AdershM-2/UWB_3/docs/uwb_rtls_design.pdf

# Ultra-Wideband Indoor Positioning System

Design Document: Motivation, Objectives, Methodology & Mathematics

Target Platform: Makerfabs ESP32 UWB Pro (DW1000)

Sensing: UWB Ranging + BNO085 IMU

Output: XYZ Position + Roll/Pitch/Yaw Orientation

Version | 2.0
Date | June 2026
Status | Active Development

UWB RTLS — Design Document | CONTENTS

Contents

1 Introduction and Motivation | 2
2 System Overview | 3
3 Objectives | 4
4 Mathematical Foundations | 4
5 Implementation Roadmap | 17
6 Expected Performance | 18

UWB RTLS — Design Document | 1 INTRODUCTION AND MOTIVATION

### 1 Introduction and Motivation

### 1.1 Problem Statement

Accurate indoor positioning is a prerequisite for autonomous robotics, asset tracking, human-motion capture, augmented reality, and industrial safety systems. The Global Navigation Satellite System (GNSS) fails indoors because satellite signals are attenuated by building materials and the reflected multipath environment renders pseudorange measurements unreliable. Optical systems (cameras, LiDAR) achieve high accuracy but require significant infrastructure, computational resources, and are sensitive to lighting conditions and occlusion. Inertial systems drift unboundedly without external correction.

The result is a gap: no low-cost, infrastructure-light technology currently provides real-time 3D position and 3D orientation (six degrees of freedom, 6-DOF) indoors at centimetre-level accuracy with off-the-shelf microcontroller hardware.

### 1.2 Ultra-Wideband as a Candidate Technology

Ultra-wideband (UWB) radio occupies a spectrum of at least 500 MHz bandwidth (typically 3.1–10.6 GHz for IEEE 802.15.4a devices). The key physical properties that make UWB suitable for ranging are:

- Time resolution. The large bandwidth produces a narrow autocorrelation peak. The Decawave DW1000 timestamps signal arrivals at 15.65 ps resolution (64 GHz system clock), corresponding to a theoretical distance resolution of 15.65 × 10⁻¹² × 3 × 10⁸ ≈ 4.7 mm per clock tick.
- Multipath separation. The short pulse duration (∼2 ns) allows the receiver to distinguish the direct-path component from reflections that arrive within a few nanoseconds. Narrowband systems (Bluetooth, Wi-Fi, Zigbee) cannot make this separation.
- Material penetration. UWB signals propagate through common building materials (drywall, wood, glass), enabling ranging through soft obstructions at the cost of a positive distance bias.
- Low power. The FCC Part 15 power limit (−41.3 dBm/MHz) combined with the wide bandwidth results in pulse energy well below noise floor for narrowband receivers, making UWB inherently covert and interference-resistant.

The Decawave DW1000 chip, used in the Makerfabs ESP32 UWB Pro module, implements IEEE 802.15.4-2011 UWB and achieves a specified ranging accuracy of ±10 cm in line-of-sight (LOS) conditions.

### 1.3 Limitations of Existing Open-Source Libraries

Five open-source Arduino libraries implement DW1000 positioning. All share structural limitations that prevent scaling beyond four anchors or a single mobile tag:

The four-anchor ceiling in thotro and its derivatives arises from the RANGE frame encoding: each device occupies 17 bytes (2-byte address + three 5-byte absolute timestamps) within a 90-byte frame buffer. With the 9-byte MAC header, only ⌊(90 − 9 − 2)/17⌋ = 4 devices fit before buffer overflow. The pizzo00 fork reduces this to 12 bytes/device using differential timestamps, reaching 6 anchors, but the broadcast POLL mechanism still causes RF collision between anchor replies.

Critically, no existing library uses the DW1000’s first-path power registers for non-line-of-sight (NLOS) detection, despite the chip making this data available on every received frame.

UWB RTLS — Design Document | 2 SYSTEM OVERVIEW

Table 1: Open-source DW1000 library comparison

Feature | thotro | Makerfabs jremington | pizzo00 | dw1000-ng
Anchor ceiling | 4 | 4 | 7* | 6 | Unlimited
RF collisions | Yes | Yes | Yes | Yes | No
Update rate (Hz) | 0.6 | 0.6 | 0.6 | 1 | 2
Multi-tag | No | No | No | Partial | No
NLOS detection | No | No | No | No | No
3D positioning | No | No | Fragile | No | No
IMU fusion | No | No | No | No | No
Maintained | No | Partial | Yes | Yes | No

### 1.4 Proposed Contribution

This project designs and implements a scalable UWB real-time locating system (RTLS) with the following distinguishing characteristics:

1. Unlimited anchor scaling via individual addressed DS-TWR exchanges (no shared frame buffer, no broadcast collisions).
2. NLOS detection using the DW1000 first-path power registers (FP_AMPL1/2/3) — the first open-source implementation of this capability.
3. Physics-aware state estimation using a Moving Horizon Estimator with Huber loss, physical room-boundary constraints, and speed limits.
4. Full 6-DOF output (XYZ position + RPY orientation) via tight fusion of UWB ranging and BNO085 IMU data.
5. Anchor self-survey via anchor-to-anchor ranging and Multidimensional Scaling, eliminating the need for manual coordinate measurement.

### 2 System Overview

### 2.1 Hardware

Hardware Specification

UWB module | Makerfabs ESP32 UWB Pro with Display
UWB chip | Decawave DW1000 (IEEE 802.15.4-2011 UWB)
MCU | ESP32 (dual-core Xtensa LX6, 240 MHz, Wi-Fi/BT)
RF front-end | PA/LNA amplifier (∼200 m outdoor range)
Display | 1.3 inch SSD1306 OLED (I²C, pins SDA=4, SCL=5)
IMU (planned) Bosch BNO085 via SPI
Configuration | 3–4 anchors (fixed) + 1 tag (mobile)
Transport | Wi-Fi UDP to MATLAB host (192.168.x.x:5005)

### 2.2 Software Architecture

The system is split into two layers:

Firmware (Arduino/ESP32): The tag performs round-robin DS-TWR ranging to each anchor, collects raw distances with quality metrics, and streams measurement packets over UDP. Anchors are purely passive responders. The tag never solves its own position.

UWB RTLS — Design Document | 4 MATHEMATICAL FOUNDATIONS

Host (MATLAB): All position computation, filtering, visualisation, and logging runs on the host PC. This separation means adding anchors requires only editing a JSON configuration file — no firmware change. The firmware packet format is versioned and IMU-ready.

The processing pipeline on the host is:

Raw ranges median filter

−−−−−−−−→ Filtered ranges NLOS weighting −−−−−−−−−−→ Weighted ranges LM multilat.

−−−−−−−−→ Position EKF/MHE −−−−−−−→ xˆ

EMA
−−−→ Output

### 3 Objectives

O1. Achieve XY positioning accuracy of ≤ 3 cm (1-σ) in LOS and ≤ 8 cm in soft NLOS conditions using 3–4 anchors.

O2. Achieve Z-axis positioning accuracy of ≤ 5 cm with 4 anchors deployed at different heights.

O3. Deliver continuous RPY orientation output at ≥ 50 Hz from BNO085 IMU fusion.

O4. Maintain position tracking continuity during brief anchor occlusions (≤ 3 s) using IMU dead-reckoning.

O5. Support anchor self-survey: determine anchor positions to ≤ 2 cm without external measurement.

O6. Demonstrate update rate ≥ 3 Hz for 3 anchors and ≥ 8 Hz in fast-mode operation.

O7. Provide real-time NLOS detection per anchor using DW1000 channel impulse response diagnostics.

O8. Remain compatible with low-cost hardware: total cost < $200 for a 4-anchor + 1-tag system.

### 4 Mathematical Foundations

This section develops the mathematics behind each processing stage in the pipeline. No prior knowledge of signal processing or estimation theory is assumed. Notation: Scalars are written in italic (t, d, τ ); column vectors in bold italic (x, p); matrices in bold upright (F, Q). The superscript ⊤ means transpose (turning a column into a row). ∥v∥ is the length of vector v (square root of sum of squares of its components). Subscripts k index discrete time steps.

### 4.1 Double-Sided Two-Way Ranging (DS-TWR)

Big picture — what problem does DS-TWR solve?

We want to measure the distance between two radio modules by timing how long a signal takes to travel between them. The speed of light is known (c = 3×10⁸ m/s), so distance = c×time. The problem is that the clock inside each module runs at a slightly different speed. Even a tiny difference — say 20 parts per million (ppm), which is 20 microseconds per second — causes a large range error. If the tag waits 1 ms before replying to an anchor, a 20 ppm clock error makes it think 1 ms has passed when in reality 1 ms × (1 + 20 × 10⁻⁶
) = 1.00002 ms has
passed. That extra 0.00002 ms corresponds to 0.00002 × 10⁻³ × 3 × 10⁸ = 6 m of phantom range. Catastrophic.
DS-TWR fixes this by performing a two-sided exchange so that the clock offsets cancel algebraically — without either device needing to know its clock error.

### 4.1.1 Message Exchange

The DS-TWR protocol uses four messages between a tag (T) and anchor (A), each recorded with a hardware timestamp:

Step | Direction | Frame | Timestamps captured
1 | T → A | poll | t1 (T transmits), t2 (A receives)
2 | A → T | poll-ack | t3 (A transmits), t4 (T receives)
3 | T → A | range | t5 (T transmits); carries t1, t4, t5
4 | A → T | range-report | t6 (A receives); anchor computes & replies d

Think of it as a conversation: the tag says “hello” (t1), the anchor hears it (t2) and replies (t3), the tag hears the reply (t4) and sends a follow-up (t5), and the anchor hears that (t6). Both sides now have enough timing information to eliminate the clock offset.

### 4.1.2 Defining the Timing Intervals

From these six timestamps we form four intervals (all measured in DW1000 hardware ticks; one tick = 15.65 ps):

Ra = t4 − t1 | tag’s round-trip time (poll sent → ack received) | (1)
Da = t3 − t2 | anchor’s reply delay (poll received → ack sent) | (2)
Rb = t6 − t3 | anchor’s round-trip time (ack sent → range received) | (3)
Db = t5 − t4 | tag’s reply delay (ack received → range sent) | (4)

If there were no clock error and the signal takes time τ to travel one way, then ideally Ra = 2τ +Da and Rb = 2τ + Db. Each round-trip is twice the travel time plus the processing delay.

### 4.1.3 The DS-TWR Formula

Combining both round-trips cancels the processing delays and, crucially, the clock offsets:

τToF =

RaRb − DaDb
Ra + Rb + Da + Db

(5)

Why does this formula work?

Consider the ideal case (no clock error). Substitute Ra = 2τ + Da and Rb = 2τ + Db:

τToF =

(2τ + Da)(2τ + Db) − DaDb
(2τ + Da) + (2τ + Db) + Da + Db

=

4τ

2 + 2τ (Da + Db)
4τ + 2(Da + Db)

=

2τ

2τ + Da + Db

2

2τ + Da + Db

= τ

The processing delays Da and Db cancel completely, leaving the true one-way travel time. With clock errors, the algebra is more involved but the errors cancel to second order.

Clock-offset cancellation (detailed). Let εT and εA denote the fractional frequency offsets of the tag and anchor clocks (e.g. ε = 20 × 10⁻⁶
for a 20 ppm crystal). Because the tag’s clock runs fast or slow, all intervals measured by the tag are scaled: Ra (measured by the tag) is really (2τ + Da)(1 + εT ), and Rb (measured by the anchor) is (2τ + Db)(1 + εA). Substituting into eq. (5) and keeping only first-order terms in ε (since ε

2 ≈ 4 × 10⁻¹⁰ is negligible):

τToF ≈ τ | + | O(ε

2
)
| | | {z } ≈ 0.1 mm

The clock-offset terms vanish. The remaining error is at most 0.1 mm — far below the chip’s 4.7 mm resolution.

Worked numerical example

Suppose a tag ranges to an anchor 3 m away. Light travel time: τ = 3 / (3 × 10⁸ ) = 10 ns =
10 × 10⁻⁹
s. In DW1000 ticks (1 tick = 15.65 ps), this is 10 × 10⁻⁹ / 15.65 × 10⁻¹² ≈ 639 ticks. Say the anchor takes 1 ms to process and reply (Da = 1 ms), and the tag takes 1.2 ms (Db = 1.2 ms). In ticks:
Da ≈ 63 900 000, | | Db ≈ 76 700 000

Ra = 2τ + Da ≈ 1278 + 63 900 000 = 63 901 278 ticks

Rb = 2τ + Db ≈ 1278 + 76 700 000 = 76 701 278 ticks

τToF =

RaRb − DaDb
Ra + Rb + Da + Db

≈

63901278 × 76701278 − 63900000 × 76700000 63901278 + 76701278 + 63900000 + 76700000 Numerically the cross-terms from DaDb and the products cancel to leave ≈ 639 ticks, giving: ˆd = 639 × 15.65 × 10⁻¹² × 3 × 10⁸ ≈ 3.0 m. ✓

The measured distance is then:
ˆd = c · τToF + bant | (6)

where c = 2.998 × 10⁸ m/s and bant is a per-board calibration offset (see below).

### 4.1.4 Antenna Delay Calibration

Why calibration is needed

Every DW1000 chip has a slightly different internal wiring delay between the digital timestamp and the physical antenna. This delay is fixed for a given board but unknown. Without correcting it, every range measurement will be off by the same constant — even with perfect DS-TWR maths. Calibration identifies this constant by comparing the measured distance against a known true distance and adjusting a register (∆) until they match.

The DW1000 applies a programmable antenna delay ∆ (a 16-bit register value) that shifts the RX timestamp. Increasing ∆ makes the chip think the signal arrived later, which reduces the computed ToF and thus the reported distance. Calibration finds:

∆∗ = arg min
∆
E

h

ˆd(∆)i
− d

⋆

2

where d

⋆
is the measured true distance (e.g. boards placed 7 m apart with a tape measure). The relationship is monotone, so a binary search over ∆ ∈ [15800, 16900] with 200 averaged measurements per candidate converges to the optimum in 14 iterations (2

14 = 16384 covers the
range). The residual uncertainty is ±3 ticks ≈ ±1.4 mm.

### 4.2 NLOS Detection via Channel Impulse Response

Big picture — detecting blocked paths

When the direct radio path between tag and anchor is blocked by a wall or large object, the signal still arrives — but via a longer reflected route. Since we assume straight-line travel, the extra path length registers as a spurious positive distance error (the measured range is longer than the true range). This is called Non-Line-of-Sight (NLOS) error and is always positive.
The DW1000 gives us a way to detect NLOS without any extra hardware: it separately reports how much energy arrived in the first path (the direct or near-direct arrival) versus the total received energy. If a lot of energy came in late (via reflections), the ratio between total and first-path power is large — a reliable NLOS indicator.

### 4.2.1 Physical Basis

When a radio pulse is transmitted, it spreads out in space. At the receiver, the DW1000 correlates the incoming signal against the known preamble sequence to build a Channel Impulse Response (CIR) — essentially a time-series showing when energy arrives and how much. In LOS conditions, one sharp peak appears at the direct-path delay. In NLOS, additional energy arrives later via reflected paths. The chip hardware captures the amplitude of the three samples straddling the first (earliest) peak, giving us a window into how strong the direct path is relative to all the scattered energy.

### 4.2.2 DW1000 Diagnostic Registers

After every received frame, the DW1000 populates these registers automatically:

- FP_AMPL1, FP_AMPL2, FP_AMPL3 (register 0x12): three amplitude samples around the first-path leading edge. Together they represent the energy in the direct (first-arriving) signal.
- RXPACC (register 0x10): the preamble accumulator count — how many samples were averaged to build the CIR. Used as a normalisation factor.
- CIR_PWR (register 0x12): the total integrated channel power, including all reflections.

### 4.2.3 Computing the NLOS Score

Step 1 — First-path power. Combine the three amplitude samples and normalise by the accumulator count. The result is then converted to decibels (dBm), a logarithmic power scale where each 10 dB corresponds to a factor of 10 in power:

PFP = 10 log10

A²

1 + A²

2 + A²
3
N²
acc | !
− Aconst | (7)

Here A1, A2, A3 are the FP_AMPL values, Nacc is RXPACC, and Aconst is a chip-specific constant (121.74 dBm at 16 MHz PRF; 113.77 dBm at 64 MHz PRF) that accounts for the chip’s internal gain.

Step 2 — Total received power. The total power PRX is read from CIR_PWR via the driver function DW1000.getReceivePower(), using a similar log formula.
Step 3 — NLOS score. The NLOS score is simply the power gap between total and first-path:
∆PNLOS = PRX − PFP | (8)

In LOS, most of the energy arrives in the first path, so PRX ≈ PFP and ∆PNLOS is small. In NLOS, extra reflected energy raises PRX while PFP stays low, widening the gap.

Score | Condition | Action
< 3 dB | LOS. Direct path dominates. | Full weight in multilateration.
3–6 dB | Soft NLOS. Partial obstruction. | Reduce weight proportionally.
≥ 6 dB | Hard NLOS. Reflected path dominant. | Strong downweight or reject.

### 4.2.4 Range Bias Correction under NLOS

NLOS ranging error is always positive: reflected and through-wall paths are geometrically longer than the direct path, so the measured distance always exceeds the true distance. Through-wall propagation also slows the signal by a factor of √
εr, where εr is the material’s relative permittivity (concrete: εr ≈ 6–9; drywall: εr ≈ 2–4). A higher ∆PNLOS score correlates with a larger positive bias, allowing an empirical correction:
bNLOS ≈ kNLOS · max(0, ∆PNLOS − 3 dB) | (9)

with kNLOS ≈ 0.02–0.05 m/dB (environment-dependent, tuned experimentally). This correction is subtracted from the measured range before multilateration.

### 4.3 Weighted Multilateration

Big picture — locating a point from distances

Multilateration is the process of finding a position given distances to several reference points (anchors). The key idea: if you know you are exactly 3 m from anchor 1, you could be anywhere on a circle (or sphere in 3D) of radius 3 m centred on anchor 1. A second anchor gives a second circle. In 2D, two circles intersect at two points. A third anchor breaks the ambiguity and gives a unique intersection — your position.
In practice, the measured distances have noise, so the circles do not intersect perfectly at one point. Instead of looking for an exact intersection, we find the position that is as close as possible to being at the stated distance from each anchor — a least-squares problem.

### 4.3.1 Measurement Model

Let there be N anchors at known positions ai ∈ R

d
(where d = 2 for 2D or d = 3 for 3D), and let ˆdi be the measured range to anchor i after median filtering and bias correction. The true tag position x ∈ R

d
satisfies:

ˆdi = ∥x − ai∥
| | {z | }
true distance

+ ei
|{z}
noise

, ei ∼ N (0, σ²
i
) | (10)

The term ∥x − ai∥ is the Euclidean distance from tag to anchor i (the length of the straight line connecting them). The noise ei
is modelled as Gaussian with standard deviation σi

. Anchors
flagged as NLOS have a larger σi
:
σi = σbase · 10∆PNLOS,i/20 | (11)

A 10 dB NLOS score multiplies the assumed noise standard deviation by 10⁰.5 ≈ 3.16, reducing the weight (see below) by a factor of 10. This is how the NLOS score flows from the radio measurement into the position solver.

### 4.3.2 Weighted Least-Squares Objective

Define the residual for anchor i as ri(x) = ∥x − ai∥ − ˆdi — the difference between the distance implied by guess x and the measured range. If our guess is correct, ri = 0. The position estimate minimises the weighted sum of squared residuals:

xˆ = arg min
x∈Rd

X

N

i=1

wi ri(x)

2
, wi =

1
σ

2
i

(12)

Anchors with higher uncertainty σi get a smaller weight wi
| , so their contribution to the cost is
reduced. This is the core of weighted least squares: trust reliable measurements more.

### 4.3.3 Levenberg-Marquardt Solver

The objective eq. (12) is nonlinear (the distances ∥x − ai∥ are nonlinear in x), so there is no closed-form solution. We use the Levenberg-Marquardt (LM) algorithm, which iteratively improves a guess xk by solving a linearised sub-problem at each step.

The Jacobian J. At the current guess xk, we compute the Jacobian matrix J ∈ R

N×d
. Each
row is the gradient of one residual with respect to the position:

Ji =

∂ri
∂x

=

(x − ai)

| ⊤
∥x − ai∥

(13)

This is just the unit vector pointing from anchor i toward the current guess x. Intuitively, it says: “if you move in direction Ji
, the distance to anchor i increases by one unit.”

LM update step. Let W = diag(w1, . . . , wN ) be the diagonal weight matrix. The LM correction to the current guess is:

xk+1 = xk −

J

⊤WJ + λ diag(J

⊤WJ)

−1
J
⊤Wr(xk) | (14)

The damping parameter λ controls how cautious each step is. When λ is large the step shrinks toward the direction of steepest descent (safe but slow). When λ is small the step is a full Newton step (fast near the solution). LM automatically adjusts λ: increase it if the step made things worse, decrease it if it made things better. This gives it the robustness of gradient descent and the speed of Newton’s method near the solution.

### 4.3.4 Robust Outlier Gating (MAD)

A single badly-NLOS anchor can dominate the cost and pull the estimate far from the truth. After a first LM solve, outlier anchors are detected using the Median Absolute Deviation (MAD):

σˆrobust = 1.4826 · median(|ri − median(r)|) | (15)

Why median instead of mean?

The regular standard deviation is sensitive to outliers: one anchor with a 2 m NLOS error pulls the mean residual and inflates the standard deviation, masking the fact that other anchors are perfectly consistent. The median ignores the extreme values and reports the typical residual. The constant 1.4826 converts the MAD to an equivalent standard deviation under Gaussian noise. Anchors whose residual deviates from the median by more than K = 2.5 times this robust sigma are excluded and the solve repeats with the remaining anchors.

### 4.3.5 Position Covariance

The uncertainty in the position estimate (needed by the Kalman filter) is approximated from the curvature of the cost function at the solution:

Ppos ≈ σ

2

base
J

⊤WJ−1
(16)

Intuitively: if all the Jacobian rows point in similar directions (anchors roughly collinear), the matrix J

⊤WJ is nearly singular and its inverse is large — meaning the position is poorly determined in some directions. If the anchors surround the tag from all sides, the matrix is well-conditioned and the position uncertainty is small. This is the mathematical expression of the “Dilution of Precision” concept familiar from GPS.

### 4.3.6 GPS-Style Simultaneous Bias Estimation

What GPS does that basic ranging does not

In GPS, the receiver’s clock is imprecise, so every pseudorange measurement has the same unknown clock offset added to it. GPS solves for position and this offset simultaneously by using one extra satellite beyond the minimum. The offset term cancels in pairwise differences between satellites, leaving only geometry.
We face the same problem: an uncalibrated or temperature-drifted tag clock adds the same offset δ to all measured ranges. With N ≥ d + 2 anchors (one extra beyond the minimum needed for position), we can estimate δ alongside position.

The augmented measurement model is:

ˆdi = ∥x − ai∥ + δ + ei | (17)

The augmented Jacobian gains an extra column of ones (because moving δ by 1 shifts all residuals by 1):
J˜
i = [Ji
, 1] | (18)

The LM solver treats x˜ = [x

⊤, δ]

⊤ as the unknown and proceeds identically.

Geometric limitation with minimum anchors. If we try this with exactly d + 1 anchors (e.g. 3 anchors in 2D), the δ estimate is not reliable. Subtracting any two range equations cancels δ exactly, so all the information about position comes from differences, not absolute ranges. The solver becomes ill-conditioned near the anchor centroid. For this reason, δ-solve is only enabled when N ≥ d + 2.

### 4.4 State Estimation

### 4.4.1 Extended Kalman Filter (EKF)

Big picture — the Kalman filter idea

The multilateration solver gives a new position estimate every time a ranging sweep completes (roughly 3 Hz). The Kalman filter is a principled way to smooth these noisy position estimates using knowledge of how things physically move.
The filter alternates between two steps every time interval ∆t:
1. Predict. “Given where the tag was and how fast it was moving, where should it be now?” The filter projects the state forward in time using Newton’s equations.
2. Update. “A new measurement arrived. How much should I correct my prediction?”

The correction is proportional to how much we trust the measurement versus the physics model.
The filter tracks not just the state estimate but also its uncertainty (the covariance matrix P). Uncertainty grows during prediction (we are less sure of where the tag is without measurements) and shrinks during update (new data reduces uncertainty).

State vector. The EKF state packs all unknowns into a single column vector:

x =

p
v
a
δ

∈ R

3d+1 | (19)

where p ∈ R

d
is position (e.g. [x, y] in 2D), v ∈ R

d
is velocity (how fast position is changing), a ∈ R

d
is acceleration (how fast velocity is changing), and δ ∈ R is the slowly-varying range bias from §4.3.5.

Transition matrix F (predict step). The state evolves according to Newton’s kinematic equations. If the acceleration stays roughly constant over one time step ∆t, then:

pnew = p + v ∆t +

1/2 a ∆t

2
, | vnew = v + a ∆t, | anew ≈ a, | δnew ≈ δ

Written in matrix form for the full state vector:

F =

Id | ∆t Id | ∆t
| | 2
| | 2
| | Id | 0
0 | Id | ∆t Id | 0
0 | 0 | Id | 0
0 | 0 | 0 | 1

(20)

Each block row corresponds to one sub-state (position, velocity, acceleration, bias). The top-left 3 × 3 block in d = 1 reads: new position = old position ×1 + old velocity ×∆t + old acceleration ×∆t

2/2. This is just kinematics.

Process noise Q (model uncertainty). We know the tag does not follow perfect constant-acceleration motion. Random forces (sudden stops, direction changes) introduce unpredictable acceleration changes. The matrix Q models this uncertainty. Larger Q means we trust the physics model less and will weight new measurements more heavily:

Q = qj

∆t

5
20 I

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
| | I ∆t I | 0
0 | 0 | 0 | qδ ∆t

(21)

The scalar qj (jerk power spectral density, tuned via the EKF_Q_ACCEL slider) controls the trade-off: low qj makes the filter trust its kinematic model and produce smooth but potentially lagging output; high qj makes it follow measurements closely but with more noise.

Measurement model for tight coupling. Rather than feeding the multilaterated position directly into the filter, we can feed the raw ranges and let the filter compute the expected ranges from its own state estimate. For anchor i at position ai
, the predicted range is:
hi(x) = ∥p − ai∥ + δ | (22)

The linearised measurement Jacobian (gradient of hi with respect to the state) is:

Hi =

(p − ai)

⊤
∥p − ai∥
| | {z | }
unit vector toward anchor

, 01×2d
| {z }
vel/acc terms

, 1
|{z}
bias term

(23)

The first part is the unit vector pointing from the tag toward anchor i; moving the tag by 1 m in that direction changes the range to anchor i by exactly 1 m.

Kalman equations. At each time step the filter runs the following sequence:

Predict: xˆk|k−1 = Fxˆk−1|k−1

| (project state forward) | (24)

Pk|k−1 = FPk−1|k−1F

⊤ + Q | (uncertainty grows with time) | (25)

Update: Sk = HkPk|k−1H⊤
k + Rk | (innovation covariance) | (26)
Kk = Pk|k−1H⊤
k S
−1 k | (Kalman gain) | (27)

xˆk|k = xˆk|k−1 + Kk

zk − h(xˆk|k−1

)

| (correct estimate) | (28)
Pk|k = (I − KkHk)Pk|k−1 | (uncertainty shrinks after update) | (29)

Understanding the Kalman gain K

The Kalman gain K decides how much to correct the prediction when a measurement arrives. It is automatically computed from two competing uncertainties:

- Pk|k−1

: how uncertain we are in our prediction. Large P means “I am not confident where the tag is.”
- Rk: how uncertain we are in the measurement (the covariance from the multilaterator, eq. (16)). Large R means “I do not trust this measurement.”
If the prediction is uncertain (large P) and the measurement is reliable (small R), then K is large: the filter corrects strongly toward the measurement. If the prediction is confident (small P) and the measurement is noisy (large R), K is small: the filter barely moves. This is the optimal weighted combination.

The subscript notation xˆk|k−1 means “estimate of state at time k, using data up to time k − 1” (prediction). xˆk|k means “estimate at time k, after incorporating measurement at time k” (updated).

### 4.4.2 Moving Horizon Estimator (MHE)

Big picture — looking at a window of past data

The Kalman filter processes one measurement at a time and maintains a compact summary (mean and covariance). The Moving Horizon Estimator takes a different approach: at every time step, it looks at the last N measurements simultaneously and solves one large optimisation problem to find the trajectory that best fits all of them together.
This is more computationally expensive but offers two key advantages:
1. Hard constraints. The solution is forced to lie inside the room and respect a speed limit. The Kalman filter cannot enforce these.
2. Robustness to outliers. Using the Huber loss (described below), the MHE naturally reduces the influence of NLOS-corrupted measurements without explicitly rejecting them.

At time step k, the MHE considers the window of past states {xk−N+1, . . . , xk} and minimises:

min
{xt}

∥xk−N+1 − x¯k−N+1∥

2
P

−1
arr
| | {z | }
| arrival cost
| (memory of the past)

+

X

k

t=k−N+2

∥xt − Fxt−1∥

2
Q⁻¹
| | {z | }
dynamics residuals
(penalises unphysical jumps)

+

X

t

X

i

ρδ

∥pt − ai∥ − ˆdt,i

| | {z | }
range residuals
(fit the measurements)

(30)

where ∥v∥

2
M = v

⊤Mv is a weighted norm. The three terms penalise:

1. Arrival cost: deviation of the oldest state in the window from the summary x¯k−N+1 carried forward from the previous window. This compactly encodes all information from before the window.
2. Dynamics residuals: how much each consecutive pair of states violates the physics model xt ≈ Fxt−1. Large jumps are penalised.
3. Range residuals: how well the estimated positions fit the UWB range measurements, using the Huber loss ρδ.

The Huber loss ρδ. Standard least squares penalises errors quadratically: doubling the error quadruples the penalty. This means a single large NLOS error can dominate the whole objective. The Huber loss switches to a linear penalty for large errors, limiting the influence of any single outlier:

ρδ(e) =

1
2

e

2
if |e| ≤ δ

δ

|e| − δ
2
if |e| > δ

(31)

Residual |e| Squared loss | Huber loss (δ = 0.15 m)
0.05 m | 0.0025 | 0.00125 (quadratic)
0.15 m | 0.0225 | 0.01125 (quadratic, at threshold)
0.30 m | 0.0900 | 0.01688 (linear; only 12× larger than 0.05 m)
1.00 m | 1.0000 | 0.13500 (linear; only 108× larger than 0.05 m)

An NLOS anchor with a 1 m error contributes 108× less than a perfect anchor under Huber loss, versus 400× more under squared loss.

Constraints:

pmin ≤ pt ≤ pmax | (room boundary, hard constraint) | (32)
∥vt∥2 ≤ vmax | (speed limit, hard constraint) | (33)

These hard constraints prevent the estimator from placing the tag outside the room or moving it at superhuman speed, which can happen during anchor occlusions if the estimator is unconstrained.

Computational cost. With window N = 6, space d = 3, and Na = 4 anchors, the problem has N × (3d + 1) = 60 unknowns and is solved by fmincon (MATLAB interior-point method) in 2–5 ms per step — well inside the 333 ms between UWB sweeps.

Table 2: EKF vs. MHE comparison

Property | EKF | MHE
NLOS handling | Pre-gating required | Huber loss absorbs outliers
Physical constraints | None | Room boundary + speed (hard)
Nonlinearity | Jacobian linearisation | Solved exactly
Lag | Zero | N/2 steps (≈ 1 s at N = 6)
Compute per step | Trivial (µs) | 2–5 ms (fmincon)
Sensitivity to initialisation | Moderate | Low (window smooths errors)

### 4.5 IMU Fusion and Orientation Estimation

Big picture — bridging the gap between UWB updates

UWB provides a position fix roughly every 300 ms. An IMU (inertial measurement unit) measures angular rates (gyroscope) and linear acceleration at 100 Hz. Between UWB updates, the IMU provides 30 intermediate position estimates using dead-reckoning (integrating acceleration twice). At each UWB update, the integrated position is corrected. Together, UWB provides the absolute reference while the IMU provides smooth high-rate motion between fixes.
The BNO085 also outputs orientation (roll/pitch/yaw) at 100 Hz directly, which UWB alone cannot provide.

### 4.5.1 Why Quaternions?

Orientation in 3D can be parameterised in several ways. The most intuitive is three Euler angles (roll ϕ, pitch θ, yaw ψ) — tilt left/right, tilt forward/back, and turn left/right. However, Euler angles have a singularity called gimbal lock: when the pitch angle reaches ±90◦
, roll and yaw
become indistinguishable and one degree of freedom is lost. This causes numerical instability in tracking algorithms.

Quaternions avoid this by representing orientation as four numbers [qw, qx, qy, qz] with the constraint q

2
w + q

2
x + q

2
y + q

2
z = 1. The geometric interpretation: every rotation can be described as a rotation by angle θ about a unit axis [ˆnx, nŷ, nẑ], encoded as:
qw = cos(θ/2), | qx = ˆnx sin(θ/2), | qy = ˆny sin(θ/2), | qz = ˆnz sin(θ/2)

For example, a 90◦ yaw (rotation about the Z axis) gives q = [cos 45◦

| | | , 0, 0,sin 45◦ ] = [0.707, 0, 0, 0.707].

The BNO085 handles all quaternion arithmetic internally and outputs a pre-filtered quaternion, so the user never needs to implement quaternion integration from scratch.

### 4.5.2 Rotation Matrix from Quaternion

To transform a vector from the body frame (relative to the sensor) into the world frame (fixed to the room), use the rotation matrix:

R(q) =

1 − 2(q

2
y + q

2
z

) 2(qxqy − qwqz) 2(qxqz + qwqy) 2(qxqy + qwqz) 1 − 2(q

2
x + q

2
z

) 2(qyqz − qwqx)
2(qxqz − qwqy) 2(qyqz + qwqx) 1 − 2(q

2
x + q

2
y

)

- (34)

Each element is a quadratic combination of the quaternion components. This 3×3 matrix rotates any body-frame vector into world coordinates.

### 4.5.3 Quaternion Kinematics (How Orientation Updates)

If the gyroscope reports a body angular rate ω

b = [ωx, ωy, ωz]

⊤ (in rad/s), the quaternion evolves according to:

q˙ =

1
2

q ⊗

"
0
ω

b

(35)

where ⊗ is the Hamilton product (a specific rule for multiplying two quaternions, analogous to cross-product for vectors). The 0 in the first slot makes the combined object a pure quaternion compatible with the product rule.

For a finite time step ∆t, the exact discrete integration is:

qk+1 = qk ⊗

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
(36)

This rotates the current orientation by the incremental rotation corresponding to spinning at rate ω

b
for time ∆t. The magnitude of the rotation angle is
ω

b
k

∆t radians.

### 4.5.4 IMU-Driven Position Propagation

The BNO085 also outputs linear acceleration a

b
(acceleration with gravity removed) measured in the body frame. To integrate it into world-frame position, first rotate it:

a

w = R(q) a

b

Then apply Newton’s equations over one IMU time step ∆t = 10 ms (at 100 Hz):

pk+1 = pk + vk ∆t +
1/2 a

w
k ∆t

2
(37)

vk+1 = vk + a

w
k ∆t | (38)

Between two UWB sweeps (300 ms apart) the IMU runs 30 propagation steps, providing smooth position estimates throughout. When the next UWB measurement arrives, the Kalman update corrects the accumulated drift.

### 4.5.5 Loose vs. Tight Coupling

Loose coupling first runs multilateration to get a position, then feeds that position into the EKF as the measurement zk = pˆmultilat. It is easier to implement but throws away information: the multilateration step collapses the individual range errors into a single covariance, losing the directional information about which anchors were reliable.

Tight coupling feeds raw UWB ranges ˆdi directly into the EKF/MHE as separate measurements via the model of eq. (22). This is the recommended approach because:

- It can use partial anchor sets (e.g. 2 of 4 anchors visible) without changing any equations.
- Each anchor’s quality metric flows directly into the measurement weight Rk.
- The Jacobian Hi automatically captures the geometry of each anchor.

### 4.5.6 Roll, Pitch, and Yaw from Quaternion

Physical meaning of roll, pitch, yaw

Roll (ϕ): rotation about the forward axis (tilting left/right like an aircraft banking). Pitch (θ): rotation about the side axis (nose up/down). Yaw (ψ): rotation about the vertical axis (turning left/right on a compass heading). Together these three angles fully describe orientation in 3D.

The Euler angles in ZYX convention are extracted from the quaternion by:
ϕ = atan2
2(qwqx + qyqz), 1 − 2(q

2
x + q

2
y

)

(39)
θ = arcsin(2(qwqy − qzqx)) | (40)
ψ = atan2
2(qwqz + qxqy), 1 − 2(q

2
y + q

2
z

)

(41)

The function atan2(y, x) returns the angle whose sine is proportional to y and whose cosine is proportional to x, in the correct quadrant. The arcsin for pitch is why pitch is limited to ±90◦ in this convention.

The BNO085 runs its ARVR Stabilised Rotation Vector mode, which fuses accelerometer, gyroscope, and magnetometer internally at 400 Hz. The magnetometer provides an absolute heading reference (like a compass), preventing the yaw drift that gyroscope integration alone would accumulate over time.

### 4.6 Anchor Self-Survey via Multidimensional Scaling

Big picture — building a map from pairwise distances

Normally we assume the anchor positions are known (measured with a tape measure or laser rangefinder and entered into the config file). Any measurement error directly biases all subsequent position estimates.
Anchor self-survey replaces manual measurement: the anchors range to each other and a mathematical procedure called Multidimensional Scaling (MDS) recovers their 2D or 3D layout automatically. The analogy: given a table of driving distances between cities, MDS reconstructs a map of those cities without any compass or coordinate system.

### 4.6.1 Data Collection

With N anchors, there are N
2
=

N(N−1)
2

unique pairs. For 4 anchors this is 6 pairs. Each anchor temporarily becomes a ranging initiator and ranges to every other anchor. Each pairwise distance is averaged over M = 100 measurements to reduce noise: the averaged uncertainty is σd/

√
M ≈ 5 cm/

√
100 = 0.5 cm.

### 4.6.2 Classical Multidimensional Scaling

Step 1 — Build the squared-distance matrix. Arrange all pairwise distances ˆdij into a symmetric N × N matrix and square each entry:

D

(2)
ij = ˆd
2
ij
The diagonal entries are zero (distance from any anchor to itself is zero).
Step 2 — Double-centering. The matrix D⁽²⁾ encodes distances relative to the centroid of the anchor cloud, but it is not centred. Apply the centering matrix J = IN −

1
N

11⊤ (which
subtracts row and column means): B = −
1/2 J D⁽²⁾ J | (42)

UWB RTLS — Design Document | 5 IMPLEMENTATION ROADMAP

Why double-centering?

If the anchor positions are stored in a matrix X (rows = anchors, columns = coordinates), then the squared distances satisfy D

(2)
ij = ∥xi − xj∥ 2 = ∥xi∥

2 − 2xi
- xj + ∥xj∥

2
. The
double-centering operation eq. (42) algebraically cancels the ∥xi∥

2
and ∥xj∥

2
terms, leaving
Bij = xi
- xj — the dot products between anchor positions. In matrix form: B = XX⊤. We have converted distances into dot products, from which positions can be extracted by factorisation.
Step 3 — Eigendecomposition. Factor B into eigenvectors and eigenvalues: B = VΛV⊤. If the distances were exact, exactly d eigenvalues would be non-zero (one per spatial dimension). Take the d largest:
Xˆ = Vd Λ
| 1/2 d
(43)

where Vd contains the d leading eigenvectors as columns and Λd = diag(λ1, . . . , λd). Each row of Xˆ is the recovered position of one anchor.

Numerical example: 3 anchors in 2D

Suppose the true anchor positions are a1 = (0, 0), a2 = (3, 0), a3 = (1.5, 2.6) metres. The true pairwise distances are: d12 = 3 m, d13 = 3 m, d23 = 3 m (equilateral triangle, side 3 m).

D⁽²⁾ =

0 9 9
9 0 9
9 9 0

After double-centering: B =

6 | −3 −3
−3 | 6 | −3
−3 −3 | 6

- (scaled by 1/3 internally). Eigendecomposition

yields 2 non-zero eigenvalues. Taking the top 2 and applying eq. (43) recovers the anchor layout up to rotation/reflection. After frame fixation, the output matches the true positions.

### 4.6.3 Coordinate Frame Fixation

MDS recovers the shape but not the orientation or position (the solution is ambiguous up to rigid-body motion). Three conventions fix a unique coordinate frame:

1. Translation: Subtract the position of anchor 1 from all positions, so anchor 1 becomes the origin (0, 0) or (0, 0, 0).
2. Rotation: Rotate the layout so that anchor 2 lies on the positive X axis.
3. Reflection: If anchor 3 ends up below the X axis (negative Y), flip the Y axis.

The result is written to config/anchors.json for immediate use by the localisation pipeline.

### 4.6.4 Noise Propagation

Each pairwise distance is the mean of M = 100 measurements. If individual measurement noise is σd ≈ 5 cm, the mean has standard deviation σd/

√
M = 0.5 cm. Classical MDS propagates this to a position uncertainty of roughly 0.5 cm per anchor coordinate — within our ≤ 2 cm self-survey target.

### 5 Implementation Roadmap

The system is developed in six phases, each independently testable:

UWB RTLS — Design Document | 6 EXPECTED PERFORMANCE

Table 3: Implementation phases and key items

Phase | Item | Description | Difficulty

1 — Foundation

1.0 | Switch to 64 MHz PRF (accuracy mode) | Easy
1.1 | Better calibration (200 samples, multi-distance) | Easy
1.2 | Adaptive polling: skip dead anchors | Easy
1.3 | Faster sweep rate (reduce reply delay) | Medium
1.5 | Anchor self-survey + auto anchors.json | Medium

2 — Ranging

2.1 | FP_POWER NLOS detection (firmware + wire format) | Medium
2.2 | Weighted multilateration (NLOS score) | Medium
2.3 | NLOS range bias correction slider | Easy
2.4 | Per-anchor diagnostics panel | Easy
2.5 | GPS-style δ-solve (4+ anchors) | Medium

3 — Estimation

3.1 | Constant-acceleration EKF | Medium
3.2 | δ as EKF state (bias estimation) | Med-Hard
3.3 | Moving Horizon Estimator | Hard
3.4 | Hybrid EKF + MHE | Medium

4 — 3D + RPY

4.1 | 4th anchor + 3D configuration | Easy
4.2 | BNO085 SensorImu (SPI) | Medium
4.3 | RPY output from quaternion | Easy
4.4 | Loose coupling: IMU-aided EKF | Hard
4.5 | Tight coupling: raw ranges + IMU in MHE | Very Hard

5 — Hardening

5.1 | Deep sleep on anchors | Medium
5.2 | DW1000 driver error handling | Medium
5.3 | Temperature compensation | Medium
5.4 | Online self-calibration | Hard

6 — Scale

6.1 | Multi-tag TDMA superframe | Hard
6.2 | Differential timestamp encoding | Hard
6.3 | On-device 2D solve (OLED) | Medium

### 6 Expected Performance

The theoretical floor for the DW1000 chip is approximately 1–2 cm in perfect LOS conditions (limited by the 15.65 ps timestamp resolution and residual crystal asymmetry). Practical indoor environments with multipath and occasional NLOS will see 2–5 cm as the sustainable floor. IMU integration does not improve UWB ranging accuracy but eliminates position lag between sweeps and provides orientation at sensor rate.

UWB RTLS — Design Document | 6 EXPECTED PERFORMANCE

Table 4: Expected accuracy progression through implementation phases

After Phase | XY accuracy | Z accuracy | RPY | Rate | Key enabler
Current | 3–10 cm | — | — | 3 Hz | Baseline
Phase 1 | 2–6 cm | — | — | 4–8 Hz | Calibration + PRF
Phase 2 | 1–4 cm | — | — | 4–8 Hz | NLOS detection
Phase 3 | 1–3 cm | — | — | 4–8 Hz | MHE + CA-EKF
Phase 4 | 1–3 cm | 2–5 cm | 3–5◦ | 100 Hz RPY | IMU fusion
Phase 5 | 1–3 cm | 2–5 cm | 3–5◦ | 100 Hz RPY | Reliability
