AdershM-2/UWB_3/docs/uwb_rtls_for_dummies.pdf

# UWB Indoor Positioning

### A Plain-English Guide to Every Equation

Companion to the technical design document.

No prior engineering or maths background assumed.

Hardware | Makerfabs ESP32 UWB Pro (Decawave DW1000)
Goal | Find the XYZ position and orientation of a moving tag
Version | 1.0 — June 2026

UWB RTLS — Plain English Guide | CONTENTS

Contents

1 The Big Picture in One Page | 2
2 Step 1 — Measuring Distance with Radio Pulses (DS-TWR) | 2
3 Step 2 — Detecting Blocked Paths (NLOS) | 5
4 Step 3 — Finding Position from Distances (Multilateration) | 7
5 Step 4 — Smoothing Position Over Time (EKF / MHE) | 11
6 Step 5 — Adding Orientation (IMU Fusion) | 14
7 Step 6 — Finding Anchor Positions Automatically (MDS) | 16
8 How All the Pieces Fit Together | 19

UWB RTLS — Plain English Guide 2 STEP 1 — MEASURING DISTANCE WITH RADIO PULSES (DS-TWR)

### 1 The Big Picture in One Page

What are we building?

We are building an indoor GPS. Four small radio modules (called anchors) are fixed at known positions around a room. One more module (called the tag) is carried by a person or robot. The tag measures how far it is from each anchor by timing how long a radio pulse takes to travel between them. A laptop then uses those four distances to calculate where the tag must be.
That is the whole idea. Everything else in this document is about doing it more accurately.

Why not just use GPS? Ordinary GPS works by receiving signals from satellites 20 000 km above Earth. Indoors, those signals are too weak and reflect off walls, making them unreliable. Our system places the equivalent of “mini-satellites” in the same room, which solves both problems.

The processing chain — each step in the pipeline is covered by one section of this document:

Step | What happens
1 | Tag sends a radio pulse to each anchor and times the round-trip (§2)
2 | We check whether any anchor’s signal was blocked or reflected (§3)
3 | We use the four distances to triangulate position (§4)
4 | We smooth the position over time using a physics model (§5)
5 | We add orientation (tilt, heading) from an IMU sensor (§6)
6 | Anchors measure each other to find their own positions automatically (§7)

### 2 Step 1 — Measuring Distance with Radio Pulses (DS-TWR)

What is DS-TWR?

DS-TWR stands for Double-Sided Two-Way Ranging. It is the method used to measure how far the tag is from one anchor. The core idea: send a radio pulse from the tag to the anchor, measure how long it takes, and multiply by the speed of light to get a distance. Then correct for the fact that neither device has a perfect clock.

### 2.1 Why Timing is Hard — The Clock Problem

Radio pulses travel at the speed of light: c = 3 × 10⁸ metres per second. At 3 metres distance, the travel time is:

time =

distance
speed =

3
3 × 10⁸

= 10 nanoseconds (a nanosecond is 10⁻⁹ seconds)

So we need to measure 10 nanoseconds accurately. That is extremely short. The clock inside a cheap crystal oscillator runs at a slightly wrong speed — typically off by about 20 parts per million (ppm). What does that mean?

How bad is a 20 ppm clock error?

“20 parts per million” means the clock gains or loses 20 microseconds for every second it runs. If the tag waits 1 millisecond (1/1000 of a second) before sending its reply, the

UWB RTLS — Plain English Guide 2 STEP 1 — MEASURING DISTANCE WITH RADIO PULSES (DS-TWR)

error in that delay is:

20 × 10⁻⁶ × 1 × 10⁻³
seconds = 20 nanoseconds of error

Since light travels 3 × 10⁸ m/s, 20 ns of timing error corresponds to:

20 × 10⁻⁹ × 3 × 10⁸ = 6 metres of fake distance

A 6 metre error from a 1 ms processing delay! This is why we cannot simply time a single pulse.

### 2.2 The Four-Message Fix

DS-TWR uses four messages between the tag (T) and anchor (A) so that the clock errors cancel out mathematically:

Msg | Who sends | Name | What time is recorded
1 | Tag → Anchor POLL | Tag records send time t1; Anchor records receive time t2
2 | Anchor → Tag POLL-ACK Anchor records send time t3; Tag records receive time t4
3 | Tag → Anchor RANGE | Tag records send time t5; also sends t1, t4, t5 inside the message
4 | Anchor → Tag REPORT | Anchor records receive time t6; computes and sends back distance

Think of it like a carefully timed conversation where both sides know exactly when they
spoke and when they heard a reply.

### 2.3 Building the Four Timing Intervals

From those six timestamps, we build four intervals. Each is measured in clock ticks (one tick on the DW1000 chip = 15.65 picoseconds, i.e. 15.65 × 10⁻¹² seconds):

Ra = t4 − t1 | Tag’s round-trip time | (tag sent POLL at t1, received ACK at t4)
Da = t3 − t2 | Anchor’s reply delay | (anchor received POLL at t2, sent ACK at t3)
Rb = t6 − t3 | Anchor’s round-trip time (anchor sent ACK at t3, received RANGE at t6)
Db = t5 − t4 | Tag’s reply delay | (tag received ACK at t4, sent RANGE at t5)

R stands for “Round-trip.” D stands for “Delay” (the waiting time before replying). The subscripts a and b indicate which side (tag or anchor) did the measuring.

If the clocks were perfect and the one-way travel time is τ :

Ra = | 2τ
|{z}
signal went there and back

+ Da
|{z}
anchor’s delay

and Rb = 2τ + Db

### 2.4 The DS-TWR Formula

τToF =

Ra · Rb − Da · Db
Ra + Rb + Da + Db

(1)

UWB RTLS — Plain English Guide 2 STEP 1 — MEASURING DISTANCE WITH RADIO PULSES (DS-TWR)

τToF | The one-way travel time we want (ToF = Time of Flight)
Ra, Rb | The two round-trip measurements
Da, Db | The two processing delays

### 2.4.1 Why does this formula work? (Step-by-step)

Step 1. In the ideal case, substitute Ra = 2τ + Da and Rb = 2τ + Db into the formula:

τToF =

(2τ + Da)(2τ + Db) − DaDb
(2τ + Da) + (2τ + Db) + Da + Db
Step 2. Expand the numerator:

(2τ + Da)(2τ + Db) − DaDb = 4τ

2 + 2τDb + 2τDa + DaDb − DaDb = 4τ

2 + 2τ (Da + Db)

Step 3. Simplify the denominator:

(2τ + Da) + (2τ + Db) + Da + Db = 4τ + 2Da + 2Db = 2(2τ + Da + Db)

Step 4. Divide:

τToF =

4τ

2 + 2τ (Da + Db)
2(2τ + Da + Db)

=

2τ (2τ + Da + Db)
2(2τ + Da + Db)

= τ ✓

The delays Da and Db cancel out completely. The formula returns the exact travel time regardless of how long the devices waited before replying.

### 2.4.2 How the Clock Error Cancels

With real clocks, the tag’s clock runs at a slightly wrong speed. Let εT be how wrong (e.g. εT = 20 × 10⁻⁶
for a 20 ppm error). Every interval measured by the tag is stretched by (1 + εT ). Similarly the anchor’s clock error is εA.

So the actual measured values are:

Ra = (2τ + Da)(1 + εT ) Rb = (2τ + Db)(1 + εA)

When you substitute these into the DS-TWR formula and do the algebra, the εT and εA terms cancel to first order, leaving:

τToF ≈ τ + (error proportional to ε

2
)
| | {z | }
≈ (20 ppm)

2=4×10⁻¹⁰, i.e. less than 0.1 mm

The remaining error is tiny (less than 0.1 mm), no matter how long the devices waited.

### 2.4.3 Converting Travel Time to Distance

ˆd = c · τToF + bant | (2)

UWB RTLS — Plain English Guide | 3 STEP 2 — DETECTING BLOCKED PATHS (NLOS)
ˆd | Measured distance (the hat ˆ means “estimated”, not exact)
c | Speed of light: 2.998 × 10⁸ m/s
τToF | Travel time from equation 1
bant | A small correction for each board’s internal wiring delay (see below)

Complete numerical example

A tag is 3 metres from an anchor. The DW1000 clock ticks at 64 GHz (i.e. 1/64 × 10⁹ seconds per tick = 15.65 ps per tick). The one-way travel time is 10 ns = 639 ticks. Say the anchor delays 1 ms (Da ≈ 63,900,000 ticks) and the tag delays 1.2 ms (Db ≈ 76,700,000 ticks). Then:
Ra = 2 × 639 + 63,900,000 = 63,901,278 ticks
Rb = 2 × 639 + 76,700,000 = 76,701,278 ticks
Plugging into equation 1: the huge delay numbers cancel in numerator and denominator, and we get back ≈ 639 ticks. Multiplying: 639 × 15.65 ps × 3 × 10⁸ m/s = 3.0 m. ✓

### 2.5 Antenna Delay Calibration

Why calibrate?

Every DW1000 chip has a slightly different internal wiring delay between its digital clock and its physical antenna. This shifts every distance reading by the same constant amount. Calibration finds and removes that constant.
Think of it like zeroing a scale before weighing something — the scale might read 2 grams when empty, so you subtract 2 grams from every reading.

The DW1000 has a register (∆, a 16-bit number) that shifts the receive timestamp. We find the best value by trying different ∆ values and comparing the measured distance against a known true distance d

⋆
:
∆∗ = arg min
∆
E[

ˆd(∆)] − d
⋆

2

Plain English: “Find the ∆ that makes the average measured distance E[

ˆd(∆)] as close as
possible to the true distance d

⋆
.” The symbol arg min means “the value of ∆ that minimises the expression in the brackets.” We use a binary search (the same idea as guessing a number between 1 and 100 by always trying the middle of the remaining range), which finds the answer in 14 steps.

Key takeaway

After calibration, the distance error caused by internal chip delays is reduced to under 1.4 mm.

### 3 Step 2 — Detecting Blocked Paths (NLOS)

What is NLOS?

NLOS stands for Non-Line-of-Sight. It means the direct path between tag and anchor is blocked by a wall, person, or furniture. When this happens, the radio pulse still arrives at the anchor — but only after bouncing off other surfaces. Because the bounced path is longer than the direct path, the measured distance is always too large. We never get a negative NLOS error, only positive ones.

UWB RTLS — Plain English Guide 3 STEP 2 — DETECTING BLOCKED PATHS (NLOS)

The DW1000 chip can tell us whether this happened by reporting how much of the received energy came in early (the direct path) versus late (via reflections).

The shouting analogy

Shout “hello” across a room. In a normal room you hear one clear echo. Now put a wall in the way — some sound diffracts around it, and some bounces off side walls, arriving a little later and sounding “muddy.” More spread-out echoes = more reflected paths = NLOS.

### 3.1 What the Chip Reports

After every received message, the DW1000 automatically fills three registers:

Register | What it stores | In plain words
FP_AMPL1, 2, 3 Three amplitude samples | Strength of the first-arriving signal
RXPACC | Preamble accumulator count How many samples were averaged (normalisation factor)
CIR_PWR | Total channel power | Strength of everything received, including reflections

### 3.2 Computing First-Path Power

We combine the three first-path amplitudes A1, A2, A3 into a single power value. Power is proportional to amplitude squared, so we square each and add them. Then we normalise by N²
acc (where Nacc = RXPACC) and convert to decibels (dB):

PFP = 10 log10

A²

1 + A²

2 + A²
3
N²
acc | !
− Aconst | (3)
PFP | First-path power in dBm (power of the direct-arrival signal)
A1, A2, A3 | The three FP_AMPL register values
Nacc | RXPACC — normalises for how many preamble samples were collected
Aconst | Chip constant: 121.74 dBm at 16 MHz PRF; 113.77 dBm at 64 MHz PRF
log10 | Logarithm base 10 (tells us the power of 10 needed to reach a number)

What is a decibel (dB)?

A decibel is a way of expressing a ratio on a squished scale, because power can vary by enormous factors. 10 log10(x) converts a power ratio x into dB. Key facts:
- +3 dB means the power doubled (10⁰.3 ≈ 2).
- +10 dB means the power became 10 times larger (10¹ = 10).
- −10 dB means the power became 10 times smaller.
We use dB because “6 dB difference” is easier to write than “the power ratio is 3.98”.

### 3.3 The NLOS Score

The total received power PRX is read from CIR_PWR by the chip’s driver. The NLOS score is simply the gap between total and first-path power:

∆PNLOS = PRX − PFP | (4)

UWB RTLS — Plain English Guide 4 STEP 3 — FINDING POSITION FROM DISTANCES (MULTILATERATION)

∆PNLOS | NLOS score in dB. ∆ (delta) means “difference.”
PRX | Total received power (first path + all reflections)
PFP | First-path power (direct arrival only)

How to read the score:

NLOS score | Meaning | What we do
Less than 3 dB | Most energy came in early (LOS) | Trust this anchor fully
3 to 6 dB | Some late energy (soft NLOS) | Reduce this anchor’s weight
More than 6 dB Most energy came in late (hard NLOS) Strongly distrust or ignore

### 3.4 Correcting the NLOS Range Error

Because the blocked path is longer than the direct path, the measured distance is always too large. We estimate how much to subtract:

bNLOS ≈ kNLOS · max(0, ∆PNLOS − 3 dB) | (5)
bNLOS | The distance correction to subtract from ˆd (in metres)
kNLOS | A tunable constant, typically 0.02–0.05 m per dB
max(0, . . .) “Take the larger of 0 and the expression.” If the score is below 3 dB, the correction is zero (no correction needed in LOS).

Example

NLOS score = 8 dB. Correction: b = 0.03 × (8 − 3) = 0.15 m. We subtract 15 cm from the measured range before using it in the position solver.

Key takeaway

NLOS detection is free — the chip computes it from data it already collects. No extra hardware required. This is the first open-source UWB system to use it.

### 4 Step 3 — Finding Position from Distances (Multilateration)

What is multilateration?

“Trilateration” or “multilateration” means finding a position given distances to several known points. You have distances from the tag to each anchor. Each distance says “I could be anywhere on a circle (or sphere) of that radius around this anchor.” Multiple circles narrow it down to one intersection point — your position.

The radio-station analogy

Imagine you can hear three radio stations and you know how strong each signal is (weaker = farther away). You draw a circle of the right radius around each station on a map. The point where all three circles cross is where you are. With four anchors in 3D (one per spatial dimension plus one spare), you can find position in XYZ.

UWB RTLS — Plain English Guide 4 STEP 3 — FINDING POSITION FROM DISTANCES (MULTILATERATION)

### 4.1 The Measurement Equation

For each anchor i (where i goes from 1 to N, the number of anchors):

ˆdi = ∥x − ai∥
| | {z | }
true distance

+ ei
|{z}
noise

(6)

ˆdi | Measured (noisy) distance to anchor i
x | The tag’s position we are trying to find — a vector like [x, y] or [x, y, z]
ai | The known position of anchor i — also a vector like [ax, ay]
∥x − ai∥ The straight-line distance from tag to anchor i
| This equals q (x − ax) 2 + (y − ay) 2 in 2D (Pythagoras’ theorem)
ei | Measurement noise — a random error, assumed to follow a bell curve
N (0, σ²
i
| ) Bell curve (Gaussian) with average 0 and spread σi
σi | Standard deviation: roughly the expected size of the error

The noise σi for each anchor depends on its NLOS score:

σi = σbase · 10 ∆PNLOS,i / 20 | (7)
σbase | Baseline noise (e.g. 0.10 m) when the anchor is in perfect LOS
10∆P/20 | A multiplier > 1 that grows with the NLOS score
| At 10 dB NLOS: 10¹⁰/20 = 10⁰.5 ≈ 3.16, so σi ≈ 3.16 × σbase

An NLOS anchor gets a larger σi

| , which means we trust it less (see weights below).

### 4.2 Minimising the Total Error

We want to find the position x that makes all the distance equations as consistent as possible. The cost function is:

xˆ = arg min
x

X

N

i=1

wi

∥x − ai∥ − ˆdi

2
, wi =

1
σ

2
i

(8)

arg minx | “Find the x that makes the following expression as small as possible”
PN
i=1 | Add up the following term for each anchor from i = 1 to i = N
wi | Weight for anchor i: larger weight = we trust this anchor more
wi = 1/σ²
i | Noisier anchors (large σi) get smaller weight (large σ
| 2
| i in denominator)
(∥x − ai∥ − ˆdi)
2 | Squared difference between the distance our guess implies
| and what we actually measured to anchor i

Plain English

We are guessing a position x. For each anchor, we check: “if I were at position x, what distance would I expect to anchor i? How far is that from what I actually measured?” We square that gap so positive and negative errors don’t cancel, multiply by how much we trust the anchor, and add it all up. We adjust our guess to make this total as small as possible.

UWB RTLS — Plain English Guide 4 STEP 3 — FINDING POSITION FROM DISTANCES (MULTILATERATION)

### 4.3 Solving It Iteratively — Levenberg-Marquardt (LM)

This minimisation has no closed-form solution (we cannot just rearrange the equation). So we use an iterative algorithm called Levenberg-Marquardt that makes small improvements to the guess until it stops improving.

The residual vector. For a current guess xk, define the residual for anchor i as:

ri(xk) = ∥xk − ai∥ − ˆdi

This is simply: (distance my guess implies) − (what I measured). If ri = 0, the guess is perfect for anchor i. If ri > 0, the guess is too far from anchor i.

The Jacobian. To improve the guess, we need to know: “which direction should I move x to reduce each ri most quickly?” The answer is the Jacobian matrix J. Each row i of J is:

Ji =

∂ri
∂x

=

(x − ai)

⊤
∥x − ai∥

(9)

∂ri/∂x | “How much does ri change when I nudge x a tiny bit?” (partial derivative)
(x − ai) | The vector pointing from anchor i to the current guess
∥x − ai∥ | The length of that vector
(x − ai)/∥x − ai∥ This divides by the length to get a unit vector (length = 1)
In plain words: Ji | is a unit vector pointing from anchor i toward the current position guess.
Moving the guess in that direction increases the distance to anchor i by exactly 1 metre per metre of movement. This is just geometry.

The update step. Given the Jacobian J, the weight matrix W = diag(w1, . . . , wN ) (a matrix with weights on the diagonal, zeros elsewhere), and the damping parameter λ, the new guess is:

xk+1 = xk −

J

⊤WJ + λ diag(J

⊤WJ)

−1
J
⊤Wr(xk) | (10)

This looks intimidating but the logic is:

1. J

⊤Wr — the weighted gradient (which direction is downhill?).

2. (J

⊤WJ)

−1 — scales the step to the right size.

3. λ — a safety dial. Large λ: take a tiny, safe step (slow but won’t overshoot). Small λ: take a big, efficient step (fast near the solution). The algorithm sets λ automatically: increase it if the step made things worse; decrease it if the step helped.

The algorithm typically converges in 5–15 iterations.

### 4.4 Throwing Out Bad Anchors (MAD Gating)

After the first solve, we check whether any anchor is wildly inconsistent (e.g. NLOS blocked and the correction wasn’t enough). We use the Median Absolute Deviation:

σˆrobust = 1.4826 · median(|ri − median(r)|) | (11)

UWB RTLS — Plain English Guide 4 STEP 3 — FINDING POSITION FROM DISTANCES (MULTILATERATION)

median(r) | The middle value of all residuals when sorted smallest to largest
|ri − median(r)| How far each residual is from the median
median(. . .) | The median of those absolute distances
1.4826 | A constant that makes the result equivalent to a standard deviation when the noise is bell-shaped (Gaussian). This is a well-known statistics result.

Why median instead of mean?

The ordinary average is pulled by outliers. If five anchors have 2 cm residuals and one has 200 cm (NLOS), the average is about 35 cm — way above the typical 2 cm. The median ignores the outlier and returns 2 cm. We use the median to judge which anchors are normal and which are suspicious.
Any anchor with a residual more than K = 2.5 times this robust σˆ is excluded and the solve repeats with the remaining anchors.

### 4.5 How Certain Are We? (Position Covariance)

After the solve, we want to know how uncertain the position estimate is. The answer comes from the curvature of the cost function:

Ppos ≈ σ

2

base
J

⊤WJ−1
(12)
Ppos | The position covariance matrix. Its diagonal entries are the
variance (spread²
) of the error in x and y (and z). σ

2
base | Baseline ranging variance
(J

⊤WJ)

−1 The inverse of the curvature matrix. When all anchors surround
the tag evenly, this is small (good geometry). When anchors are
all in a line, this is large in the perpendicular direction (bad geometry).

This matrix is passed to the Kalman filter in the next step.

### 4.6 Solving for a Timing Bias Too (GPS-Style)

If we have N ≥ d + 2 anchors (at least 4 in 2D, 5 in 3D), we can simultaneously solve for an unknown timing offset δ that shifts all measurements by the same amount — exactly how GPS receivers solve for their clock error:

ˆdi = ∥x − ai∥ + δ + ei | (13)

The only change to the solver is that the Jacobian gains an extra column of ones (because changing δ by 1 shifts every residual by 1 equally):

J˜
i = [Ji
, 1] | (14)

Everything else stays the same.

Key takeaway

With 3 anchors in 2D, multilateration finds (x, y) in 2 unknowns from 3 equations — one spare for checking consistency. With 4 anchors, we get a third spare which lets us also solve for the timing bias δ.

UWB RTLS — Plain English Guide 5 STEP 4 — SMOOTHING POSITION OVER TIME (EKF / MHE)

### 5 Step 4 — Smoothing Position Over Time (EKF / MHE)

What problem are we solving now?

The multilateration step gives a position every time a ranging sweep completes (about 3 times per second). That position is noisy — it jumps around even when the tag is stationary. We want to smooth it using knowledge that people and robots do not teleport. They move continuously, with some speed and acceleration. A filter uses this physics knowledge to reject noise and fill in the gaps.

### 5.1 The Extended Kalman Filter (EKF)

The ship navigator analogy

Imagine a navigator on a ship. Every few minutes they get a GPS position (noisy). Between GPS fixes, they use the ship’s speed and heading (from a compass and speedometer) to estimate where the ship is now. When the next GPS fix arrives, they combine the physics-based estimate with the new measurement, trusting each one according to how reliable it has been. The Kalman filter does exactly this, but with maths.

### 5.1.1 The State Vector

The Kalman filter tracks everything it needs to know in a single column vector called the state:

x =

p
v
a
δ

(15)

p | Position — e.g. [x, y] in metres in 2D
v | Velocity — e.g. [vx, vy] in m/s (how fast position is changing)
a | Acceleration — e.g. [ax, ay] in m/s² (how fast velocity is changing)
δ | Range bias — the common clock offset shared by all anchor measurements

The filter also keeps track of how uncertain it is about each of these quantities, stored in a matrix P (the covariance matrix).

### 5.1.2 Step A: Predict (Physics)

Between measurements, the filter predicts where the tag should be now, based on where it was and how fast it was moving. This is just Newton’s kinematics:

| new position = old position + velocity × ∆t +
| 1 2 × acceleration × ∆t
| 2
| new velocity = old velocity + acceleration × ∆t

Written for all state variables at once using a transition matrix F:

xˆk|k−1 = F xˆk−1|k−1

(16)

UWB RTLS — Plain English Guide 5 STEP 4 — SMOOTHING POSITION OVER TIME (EKF / MHE)

xˆk|k−1 | State estimate at time k, predicted using data up to time k − 1
xˆk−1|k−1 | State estimate at time k − 1, after incorporating the measurement at k − 1
F Transition matrix — encodes the kinematic equations above
∆t | Time between measurements

The matrix F (shown in the technical document) is just the kinematics equations packed into matrix form. Its top-left block reads: new x = old x × 1 + old vx × ∆t + old ax × ∆t

| 2/2.

The prediction uncertainty grows:

Pk|k−1 = F Pk−1|k−1 F

⊤ + Q | (17)

Q is the process noise matrix. It represents the fact that the tag might change direction or speed in ways the filter cannot predict (e.g. the person suddenly stops). Larger Q = the filter knows it cannot predict well = it gives new measurements more weight.

### 5.1.3 Step B: Update (Measurement)

A new UWB measurement zk arrives. The filter combines prediction and measurement:

Sk = Hk Pk|k−1 H⊤
k + Rk | (total uncertainty in the predicted measurement)
(18)

Kk = Pk|k−1 H⊤
k S

−1
k
(Kalman gain) | (19)

xˆk|k = xˆk|k−1 + Kk

zk − h(xˆk|k−1

)

(corrected estimate) | (20)

Pk|k = (I − Kk Hk) Pk|k−1

(uncertainty reduced after update) | (21)
Hk | Measurement Jacobian — how does the measurement depend on the state?
Rk | Measurement noise covariance (= Ppos from equation 12)
Sk | Innovation covariance — total uncertainty about what measurement to expect
Kk | Kalman gain — the weight given to the measurement correction

zk − h(xˆk|k−1

) “Innovation”: difference between what we measured and what we predicted
h(·) | The function that converts a state into a predicted measurement
For anchor i: hi(x) = ∥p − ai∥ + δ

Understanding the Kalman gain K

K is automatically computed from two uncertainties:

- Pk|k−1

(prediction uncertainty): if this is large, the filter is not confident in its prediction, so it will strongly correct toward the measurement.
- Rk (measurement uncertainty): if this is large, the measurement is noisy, so the filter barely corrects.
If the prediction is perfect and the measurement is noisy, K ≈ 0 (ignore the measurement). If the prediction is useless and the measurement is perfect, K ≈ H⁻¹
(jump to the
measurement). In practice it is always somewhere between.

The measurement model for anchor i in tight coupling is:

hi(x) = ∥p − ai∥ + δ | (22)

UWB RTLS — Plain English Guide 5 STEP 4 — SMOOTHING POSITION OVER TIME (EKF / MHE)

and its Jacobian (how does this measurement change if the state changes?):

Hi =

(p − ai)

⊤
∥p − ai∥

, 0 |{z} vel/acc terms

, 1

- (23)

The first part is the unit vector from anchor i to the tag. It says: “moving 1 metre toward anchor i reduces the range to anchor i by 1 metre.” The final 1 is for the bias δ: increasing the bias by 1 increases all ranges by 1.

### 5.2 Moving Horizon Estimator (MHE)

An alternative to the Kalman filter

Instead of updating one step at a time, the MHE keeps the last N measurements and solves one big optimisation problem over all of them simultaneously. Think of it like a detective who reviews all the evidence from the last 6 crime scenes together, rather than updating their theory one crime at a time. This is slower to compute but allows hard constraints (“the suspect cannot be outside the building”).

The MHE minimises this objective over the window {xk−N+1, . . . , xk}:

min ∥xk−N+1 − x¯k−N+1∥

2
P

−1
arr
| | {z | }
Term 1: Arrival cost
(memory of history)

+

X

t

∥xt − Fxt−1∥

2
Q⁻¹
| | {z | }
Term 2: Physics penalty
(penalise unphysical jumps)

+

X

t,i

ρδ

∥pt − ai∥ − ˆdt,i

| | {z | }
Term 3: Range fit
(fit the UWB measurements)

(24)

∥v∥

2
M A weighted squared length: v

⊤Mv (penalises directions M says matter)
x¯k−N+1 | Prior estimate at the start of the window (from previous window’s solution)
Parr | Uncertainty of that prior estimate (arrival covariance)
Fxt−1 | Where physics says xt should be, given xt−1
ρδ(·) | Huber loss (explained below)
ˆdt,i | UWB range measurement to anchor i at time t

The Huber loss ρδ — tolerating bad measurements:

ρδ(e) =

1/2 e

2
if |e| ≤ δ (normal error: quadratic penalty)

δ

|e| − δ
2
if |e| > δ (large error: linear penalty)

(25)

Why the Huber loss?

Ordinary squared error (e

2

) treats a 1 m NLOS error as 1/0.05² = 400 times worse than a normal 5 cm error. One bad anchor dominates everything. The Huber loss switches to linear growth for large errors, so the 1 m outlier only contributes about 13 times a normal 5 cm error — a much fairer penalty that does not let one bad anchor ruin the solution.

UWB RTLS — Plain English Guide 6 STEP 5 — ADDING ORIENTATION (IMU FUSION)

Error |e| Squared: e

2 | Huber (δ = 0.15 m) | Ratio
0.05 m | 0.0025 | 0.00125 | 1× (baseline)
0.15 m | 0.0225 | 0.01125 | 9×
0.30 m | 0.0900 | 0.01688 | 13× (Huber caps growth)
1.00 m | 1.0000 | 0.13500 | 108× vs 400× for squared

Hard constraints prevent the MHE from placing the tag outside the room or moving it faster than a person can walk:

pmin ≤ pt ≤ pmax | (room boundary) | (26)
∥vt∥ ≤ vmax | (speed limit, e.g. 2 m/s for walking) | (27)

Key takeaway

EKF = fast, simple, real-time. MHE = slower, handles hard constraints and outliers better. Use EKF first; upgrade to MHE for hostile environments.

### 6 Step 5 — Adding Orientation (IMU Fusion)

What does the IMU add?

UWB tells us where the tag is (position), but not which way it is pointing (orientation). A BNO085 IMU (Inertial Measurement Unit) measures rotation and acceleration 100 times per second. Adding it gives us:
1. Roll, Pitch, Yaw — the three angles that describe orientation.
2. 30 position estimates per UWB sweep — by integrating acceleration between UWB fixes.

### 6.1 Describing Orientation — Why Quaternions?

Three ways to describe “which way you are facing”

Euler angles (roll, pitch, yaw): easy to understand, but have a bug called gimbal lock. When you pitch up 90 degrees, roll and yaw point in the same direction and you lose a degree of freedom — the maths breaks down.
Quaternions: four numbers instead of three, with one constraint. No gimbal lock, no singularities. The BNO085 outputs quaternions directly, so we never experience gimbal lock.

A quaternion is written q = [qw, qx, qy, qz] with the constraint q

2
w + q

2
x + q

2
y + q

2
z = 1 (unit
length). The geometric meaning: any rotation can be described as “rotate by angle θ about a unit axis nˆ”, encoded as:

qw = cos(θ/2) The “how much” part
qx = ˆnx sin(θ/2) The x-component of the axis, scaled qy = ˆny sin(θ/2) The y-component of the axis, scaled qz = ˆnz sin(θ/2) The z-component of the axis, scaled

Example: 90◦ yaw (turning left)

Axis = [0, 0, 1] (straight up, the Z axis). Angle θ = 90◦ .

qw = cos(45◦

) = 0.707, | qx = 0, | qy = 0, | qz = sin(45◦
) = 0.707

UWB RTLS — Plain English Guide 6 STEP 5 — ADDING ORIENTATION (IMU FUSION)

So q = [0.707, 0, 0, 0.707].

### 6.2 The Rotation Matrix

To rotate a vector from the body frame (tag’s perspective) into the world frame (room’s perspective), we use:

R(q) =

1 − 2(q

2
y + q

2
z

) 2(qxqy − qwqz) 2(qxqz + qwqy) 2(qxqy + qwqz) 1 − 2(q

2
x + q

2
z

) 2(qyqz − qwqx)
2(qxqz − qwqy) 2(qyqz + qwqx) 1 − 2(q

2
x + q

2
y

)

- (28)

Each entry is a quadratic combination of qw, qx, qy, qz. If the tag accelerates forward (body frame), multiply R by that acceleration vector to get the world-frame direction of the acceleration. This is needed to integrate IMU acceleration into world-frame position.

### 6.3 How Orientation Updates (Quaternion Kinematics)

The gyroscope measures angular rate ω

b = [ωx, ωy, ωz] in rad/s. The continuous-time update rule is:

q˙ =

1
2

q ⊗

"
0
ω

b

(29)
q˙ | Time derivative of the quaternion (how fast it is changing)
⊗ | Hamilton product (the rule for multiplying two quaternions, similar to cross product)
[0, ω

b
| ] The angular rate packed as a pure quaternion (zero scalar part)
1
2 | A factor that comes from the chain rule applied to the angle-halving in quaternions

For a finite time step ∆t (e.g. 10 ms at 100 Hz), the discrete update is:

qk+1 = qk ⊗

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
(30)

What this equation does

The big bracket on the right is a quaternion that represents “rotate by ∥ω

b∥ · ∆t radians
about the axis ω

b/∥ω

b∥.” Multiplying (Hamilton product ⊗) the current orientation quaternion by this rotation quaternion rotates it to the new orientation. This is exactly analogous to multiplying rotation matrices, but numerically more stable.
The BNO085 chip handles all of this internally and outputs the result directly.

### 6.4 Position Propagation from IMU

The BNO085 also reports linear acceleration a

b
(gravity already removed) in the body frame. Steps:

### 1. Rotate to world frame: a

w = R(q) a

b

UWB RTLS — Plain English Guide 7 STEP 6 — FINDING ANCHOR POSITIONS AUTOMATICALLY (MDS)

### 2. Integrate (Newton’s equations):

pk+1 = pk + vk ∆t +
1/2 a

w
k ∆t

2
(31)

vk+1 = vk + a

w
k ∆t | (32)

This runs at 100 Hz. Every UWB sweep (at 3 Hz) provides 33 intermediate positions, making the output much smoother. The UWB measurement then corrects any drift accumulated during those 33 IMU steps.

### 6.5 Extracting Roll, Pitch, Yaw from a Quaternion

Physical meaning

Roll ϕ: tilting left/right (like an airplane banking). Pitch θ: nose up or down. Yaw ψ: turning left or right (like a compass bearing). These three angles together fully describe orientation.

From a unit quaternion [qw, qx, qy, qz]:

ϕ = atan2
2(qwqx + qyqz), 1 − 2(q

2
x + q

2
y

)

(33)
θ = arcsin(2(qwqy − qzqx)) | (34)
ψ = atan2
2(qwqz + qxqy), 1 − 2(q

2
y + q

2
z

)

| (35)

atan2(y, x) The 4-quadrant arctangent. Returns the angle whose tangent is y/x, choosing the correct quadrant based on the signs of y and x. Range: −180◦

to +180◦
arcsin(x) Inverse sine. Returns the angle whose sine is x. Range: −90◦ to +90◦ (this is why pitch is limited to ±90◦
).

The BNO085 ARVR Stabilised Rotation Vector mode fuses accelerometer + gyroscope + magnetometer internally at 400 Hz. The magnetometer provides a compass heading (absolute yaw reference), preventing the yaw angle from drifting over time as it would with a gyroscope alone.

### 7 Step 6 — Finding Anchor Positions Automatically (MDS)

What problem does this solve?

Normally, the anchor positions must be measured by hand with a tape measure and typed into the configuration file. Even small errors (1–2 cm) directly bias the position output. Anchor self-survey replaces the tape measure: the anchors range to each other, and a mathematical technique called Multidimensional Scaling (MDS) reconstructs their 2D or 3D layout automatically.

The city-map analogy

You are given a table of road distances between 4 cities but no map. You want to reconstruct the map. MDS is the procedure that does exactly this — from pairwise distances, it recovers the 2D coordinates of each point.

UWB RTLS — Plain English Guide 7 STEP 6 — FINDING ANCHOR POSITIONS AUTOMATICALLY (MDS)

### 7.1 Collecting Pairwise Distances

With N anchors, there are N
2
= N(N − 1)/2 unique pairs. For 4 anchors: 4 × 3/2 = 6 pairs. Each anchor temporarily acts as a tag and ranges to every other anchor. Each pair’s distance is averaged over M = 100 measurements. By the statistics rule for averaging: the uncertainty reduces from σd per measurement to σd/

√
M.

Noise benefit of averaging

Each single UWB measurement has noise σd ≈ 5 cm. After averaging 100 measurements:

uncertainty of mean =

5 cm
√
100

=

5
10

= 0.5 cm

We get sub-centimetre anchor position accuracy for free, just by averaging more measurements.

### 7.2 Step 1: The Squared-Distance Matrix

Arrange all pairwise distances in a symmetric N × N matrix (rows and columns are anchors), and square each entry:
D

(2)
ij = ˆd
2
ij
The diagonal is zero (each anchor is 0 metres from itself). This matrix encodes all the geometric information.

### 7.3 Step 2: Double-Centering

Apply the centering matrix J = IN −

1
N

11⊤, where IN is the identity matrix and 1 is a column of ones:

B = −

1/2 J D⁽²⁾ J | (36)

Why this step?

Consider four anchor positions packed as rows of a matrix X. The squared distance between anchor i and anchor j expands as:

d

2
ij = ∥xi − xj∥

2 = ∥xi∥

2 − 2 xi
- xj + ∥xj∥

2

The terms ∥xi∥

2 and ∥xj∥

2 depend only on how far each anchor is from the origin — which is an arbitrary choice we have not made yet. The double-centering operation cancels these terms and leaves only Bij = xi

- xj (the dot product between positions). In matrix form: B = XX⊤. We have converted distances (which depend on the origin) into dot products (which describe shape, independent of origin).

### 7.4 Step 3: Eigendecomposition

Decompose B into eigenvalues and eigenvectors:

B = VΛV⊤

UWB RTLS — Plain English Guide 7 STEP 6 — FINDING ANCHOR POSITIONS AUTOMATICALLY (MDS)

V Matrix of eigenvectors (each column is an eigenvector)
Λ | Diagonal matrix of eigenvalues λ1 ≥ λ2 ≥ . . . ≥ λN
V⊤ | Transpose of V

What is an eigenvalue/eigenvector?

An eigenvector of a matrix is a special direction that the matrix does not rotate — it only stretches or shrinks it. The eigenvalue is the stretch factor. For our matrix B, which encodes a 2D shape, there are exactly 2 large eigenvalues (one for each spatial dimension). All others are near zero. The two eigenvectors corresponding to the two largest eigenvalues point along the two axes of the shape.

Take the top d eigenvalues (2 for 2D, 3 for 3D) and their eigenvectors:

Xˆ = Vd Λ

1/2
d

(37)

Vd The d eigenvectors with the largest eigenvalues, as columns Λ

1/2

d | A diagonal matrix with √ λ1, . . . , √ λd on the diagonal (square root because B = XX⊤ and we want X, not XX⊤)
Xˆ | The recovered anchor positions: each row is one anchor’s (x, y) or (x, y, z)

### 3 anchors forming an equilateral triangle

True positions: A1 = (0, 0), A2 = (3, 0), A3 = (1.5, 2.6) metres. All sides = 3 m.

D⁽²⁾ =

0 9 9
9 0 9
9 9 0

After double-centering and eigendecomposition, taking the 2 largest eigenvectors and scaling by √
λ, we recover a layout matching the triangle (up to rotation and reflection). After frame fixation (below), we get back the original coordinates.

### 7.5 Step 4: Fix the Coordinate Frame

MDS recovers the shape but not its orientation or position (there is no “north” in the math). Three rules fix a unique frame:

1. Move anchor 1 to the origin. Subtract xˆ1 from every row of Xˆ .
2. Rotate so anchor 2 is on the positive X axis. Compute the angle of xˆ2 and rotate all points by −that angle.
3. Flip if needed. If anchor 3 ends up below the X axis (negative y), negate all y coordinates.

The resulting layout is saved to config/anchors.json and used immediately. No tape measure needed.

### 7.6 How Accurate Is It?

Each pairwise distance is the mean of 100 measurements. The averaging reduces noise by a factor of √
100 = 10. MDS propagates this to anchor position uncertainty of approximately

UWB RTLS — Plain English Guide | 8 HOW ALL THE PIECES FIT TOGETHER

σd/

√
M per coordinate:

Position accuracy ≈

5 cm
√
100

= 0.5 cm per anchor

This is well within the target of ≤ 2 cm for anchor self-survey.

Key takeaway

All the maths in this section uses only: squared distances, averages, and eigenvalues. No GPS, no cameras, no manual measurement.

### 8 How All the Pieces Fit Together

§ Step | Input | Output
2 | DS-TWR ranging 6 timestamps (per anchor) | Distance ˆdi to each anchor
3 | NLOS detection | FP_AMPL + RXPACC + CIR_PWR | NLOS score, corrected ˆdi
4 | Multilateration | N corrected distances + anchor positions Position estimate pˆ + covariance
5 | EKF / MHE | New position every sweep | Smoothed position xˆ at each step
6 | IMU fusion | Quaternion + linear accel at 100 Hz | Roll/pitch/yaw + high-rate positions
7 | MDS self-survey | Anchor-to-anchor distances | Anchor positions in anchors.json

The six phases of improvement map directly to these steps:

Phase | Improves | Target accuracy
0 (done) MATLAB robustness | Stable 3–10 cm baseline
1 | PRF + calibration + self-survey 2–6 cm
2 | NLOS weighting | 1–4 cm
3 | EKF/MHE | 1–3 cm
4 | 3D + IMU fusion + RPY | 1–3 cm XY, 2–5 cm Z, 3 ◦–5 ◦ RPY
5–6 | Hardening + multi-tag | Same accuracy, more robust
