AdershM-2/UWB_3/RAP Paper/03_CaRLi-V_Camera-RADAR-LiDAR-3D-Velocity.pdf

IEEE ROBOTICS AND AUTOMATION PRACTICE (RA-P) | 1

# CaRLi-V: Camera-RADAR-LiDAR Point-Wise 3D Velocity Estimation

Landson Guo∗

, Andres M. Diaz Aguilar∗

, William Talbot‡†, Turcan Tuna‡

, Marco Hutter‡

, Cesar Cadena‡

Abstract—Accurate point-wise velocity estimation in 3D is crucial for robot interaction with non-rigid dynamic agents, enabling robust performance in path planning, collision avoidance, and object manipulation in dynamic environments. To this end, this paper proposes a novel RADAR, LiDAR, and camera fusion pipeline for point-wise 3D velocity estimation named CaRLi-V. This pipeline leverages raw RADAR measurements to create a novel RADAR representation, the velocity cube, which densely encodes RADAR radial velocities. By combining the velocity cube for radial velocity extraction, optical flow for tangential velocity estimation, and LiDAR for point-wise range measurements through a closed-form solution, our approach can produce 3D velocity estimates for a dense array of points. Developed as an open-source ROS2 package¹
, CaRLi-V has been field-tested on a custom dataset and achieves low velocity error metrics relative to ground truth while outperforming state-of-the-art scene flow methods.

Index Terms—Sensor Fusion, Computer Vision for Automation, Data Sets for Robotic Vision, Visual Tracking, Range Sensing

I. INTRODUCTION
3D velocity estimation is essential for robotic applications in dynamic environments, enabling systems to perceive and react effectively to moving objects. Conventional 3D velocity estimation tends to rely on object-wise estimates, which can be inaccurate in the case of non-rigid objects that are partially in motion [1]–[6]. In contrast, dense velocity estimates consist of per-point velocity measurements that describe the motion of all surfaces in a scene. This captures fine-grained motion variations that can improve downstream tasks such as object detection and collision avoidance in dynamic environments [7]. However, extracting dense velocities remains challenging and often requires specialized hardware. Sensors such as Frequency-Modulated Continuous-Wave (FMCW) RADAR and LiDAR enable the direct extraction of radial velocity. However, RADAR data is difficult to interpret directly and presents signal processing challenges, such as multi-path reflections, low signal-to-noise ratios, and limited resolving power, factors that explain why common detection algorithms, like Constant False Alarm Rate (CFAR), typically yield sparse point clouds [8]. While FMCW LiDAR can resolve many of these signal processing problems, it is a costly emerging technology that is not readily available [9], [10] while still limited to radial velocities. Alternatively, optical flow and scene flow algorithms extract velocity estimates from consecutive motion in indirect sensors such as cameras and Time of Flight (ToF) LiDAR, but these are either limited to tangential motion or incur very high computational cost [11], [12].
∗Authors are with ETH Zurich, Z ¨ | urich, Switzerland and contributed equally. ¨
‡ Authors are with the Robotic Systems Lab (RSL), ETH Zurich. ¨
† Corresponding author (E-mail address: wtalbot@ethz.ch).
The research leading to these results has received funding from armasuisse Science and Technology and Swiss National Science Foundation (SNSF) under grant CHIST-ERA-23-MultiGIS-07. 1https://github.com/Soldann/CaRLi-V

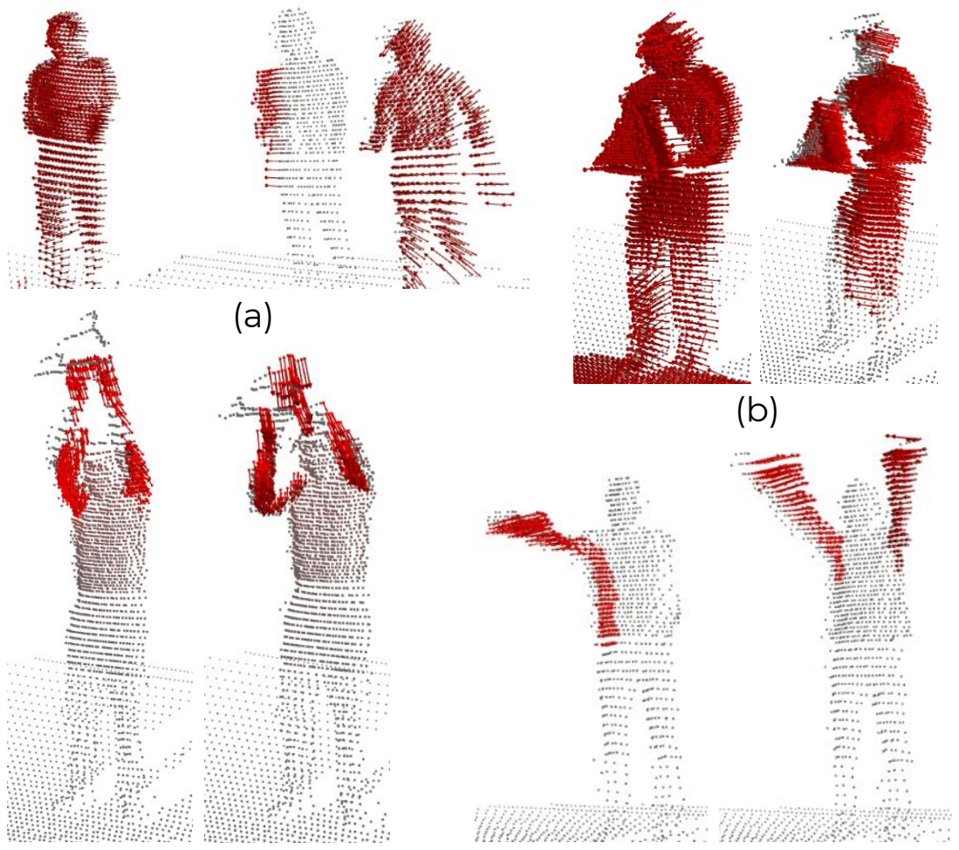
[picture p11: figure]

(c) (d)

Fig. 1. Resulting point clouds augmented with full velocity vectors displayed in red. The pipeline is able to (a) discern velocities between different dynamic agents; (b) estimate both radial and tangential velocities, as well as combinations of both, and (c, d) extract velocities from single parts of non-rigid moving agents, such as individual limbs in humans.

In this work, we propose a point-wise velocity estimation approach using perceptual sensor fusion from camera, RADAR, and LiDAR sensors. We build upon classical RADAR processing theory based on the RADAR cube to develop a novel representation, the velocity cube, that densely models radial velocities in space. Using the high spatial accuracy of the LiDAR points as a reference, we compute the velocity of each point by combining radial measurements from the velocity cube and tangential optical flow readings coinciding with these points to assign full velocity estimates. In this manner, CaRLi-V (Camera-RADAR-LiDAR point-wise Velocity estimation) is capable of estimating point-wise 3D velocities for all LiDAR points within camera and RADAR range as shown in Fig 1, following the recent trend of cross-modal motion estimation using Doppler cues [13]. We implement this approach as an open-source ROS package¹
and validate its
performance in real-world settings using a custom dataset that has been provided to facilitate the reproduction of our results.

II. RELATED WORK

Recent works on full velocity estimation from direct measurements predominantly focus on object-wise estimates [1]– [6], restricting predictions to detected rigid objects. To tackle these limitations, Long et al. [7] propose a method for point-wise full velocity estimation by augmenting RADAR point cloud measurements with camera-based optical flow for tangential velocity estimation. They present a closed-

# arXiv:2511.01383v2 [cs.RO] 10 Apr 2026 (https://arxiv.org/abs/2511.01383v2)

form geometric solution for the full velocity, as well as a neural network to correct for RADAR positional inaccuracies. However, relying on the RADAR point cloud introduces sparsity in the resulting velocity estimates. Scene flow directly leverages LiDAR’s higher spatial resolution to produce denser velocity estimates by computing displacement vectors between consecutive point cloud measurements, with efficient implementations including [14]–[19]. However, in addition to being computationally expensive, since scene flow is estimated instead of directly observed, it has unbounded error that potentially exceeds RADAR measurement noise in complex scenes. As demonstrated by Long et al. [7], optical flow, used to estimate pixel-wise displacement vectors, can be leveraged to estimate tangential velocities. Many dense optical flow algorithms are inspired by RAFT [20], with notable extensions including [21]–[23]. While accurate, these algorithms are very computationally demanding. To address this, alternatives such as NeuFlow [24], [25] employ simpler architectures, enabling real-time performance with minimal loss of accuracy.
RADAR point clouds are the result of detection algorithms that focus on identifying strong intensity peaks over noise. While effective for robust target detection, this process discards weaker returns and thus loses substantial information, leading to sparse radial velocity measurements [8], [26]. A promising alternative is the RADAR cube, a 3D/4D object representing range, Doppler velocity, azimuth (and elevation) angle, computed using the Fast Fourier Transform (FFT) across all Analog-to-Digital Converter (ADC) dimensions, yielding a dense representation of RADAR returns. Existing studies use the RADAR cube for object detection [27]–[29] and demonstrate its capabilities for encoding local motion patterns, but none to the authors’ knowledge extend upon its capacities for dense velocity estimation.
Recent advances in scene flow techniques focus on integrating different sensor modalities to further improve velocity estimates in challenging scenarios. DoGFlow [13] introduces cross-modal supervision via RADAR Doppler measurements for LiDAR scene flow; MilliFlow [30] focuses on estimating scene flow directly from RADAR point clouds; and CamLiFlow [31] integrates dense image and sparse LiDAR modalities in an end-to-end fusion framework. These demonstrate how camera and Doppler information can help with non-rigid motion handling, improving accuracy and highlighting the effectiveness of cross-modal fusion in addressing the limitations of LiDAR-only scene flow.

III. METHODOLOGY

A. RADAR preprocessing

Traditionally, 4D RADAR processing involves applying FFTs along the sample, chirp, and antenna dimensions of the raw ADC data to construct a 4D RADAR cube, a dense representation of RADAR returns with axes corresponding to range, Doppler, azimuth, and elevation. However, due to significant noise present in raw RADAR measurements, CFAR is commonly used to isolate strong reflections in the cube and extract discrete point returns for RADAR point cloud generation [8], [32].

However, peak-detection approaches discard useful information about object shape, size, and spatial continuity contained in the full RADAR cube. To preserve this information, we introduce a novel RADAR representation—the velocity cube—which encodes dense radial velocity across the measurement space. The velocity cube is a discretized 3D tensor with angular dimensions (range, azimuth, and elevation), where each voxel is assigned a single radial velocity value by collapsing the Doppler axis. The velocity cube is computed for each spatial coordinate (r, α, θ) as the radial velocity corresponding to the Doppler bin with maximum magnitude:

V (r, α, θ) = vd∗ , d∗ = arg max

d

R(r, α, θ, d), (1)

where R(r, α, θ, d) denotes the magnitude of the RADAR return at range r, azimuth α, elevation θ, and Doppler index d, and vd∗ is the radial velocity associated with bin d

∗
To suppress noise, windowing is applied during FFT processing to mitigate spectral leakage caused by signal truncation during sampling, which breaks the assumption of signal periodicity in finite-length sequences [33]. In the RADAR cube, this appears as stretched reflections along the its dimensions. A Hanning window is employed to taper the signal smoothly at both ends, reducing sidelobe levels and suppressing crossshaped artifacts from strong point returns.
Furthermore, non-maximum suppression is applied at the RADAR cube level to filter out values more than 16 dB below the peak, enabling the removal of low-frequency noise while retaining spatial resolution. This reduces ambiguities in the location of objects along the angular dimensions, which is important given their lower resolution relative to range and Doppler in most RADAR. Furthermore, this removes the presence of salt-and-pepper noise stemming from lowintensity, low signal-to-noise ratio Doppler readings, which get carried into the velocity cube due to the argmax in Eq. 1. After suppression, velocity readings remain concentrated only in regions corresponding to actual moving agents, as visible in Fig 3. The non-maximum suppression threshold follows from a parameter ablation study (see supplementary material), where 16 dB achieved the lowest error by balancing noise suppression with the preservation of informative signal content.
B. Camera Preprocessing
In parallel , dense optical flow is computed between consecutive image pairs to obtain pixel-wise displacement vectors. For this, we make use of Neuflow v2 [25] for its inference speed, but alternatives like RAFT [20] could also be employed.
C. Sensor fusion
As shown in Fig 2, the preprocessed RADAR and camera data are individually fused with the LiDAR point cloud to provide point-wise radial velocity measurements and imageplane motion constraints, which are jointly used to recover the full 3D velocities. To estimate radial velocities, since the LiDAR provides accurate 3D positions but no Doppler, while the RADAR provides Doppler readings with inaccurate angles, we use the LiDAR points as ”queries” into the RADAR velocity cube. For each LiDAR point, its coordinates are

IEEE ROBOTICS AND AUTOMATION PRACTICE (RA-P) | 3 FFTs

### Camera Pre-Processing

RADAR ADC Data

### RADAR Pre-Processing

Consecutive Camera Images

Velocity Cube

LiDAR Point Cloud

Assign radial

velocities from

doppler context

Argmax over
doppler
RADAR Cube | RADAR Cube

Point cloud with full
velocities

Point-Wise Radial
Velocity Estimates

Hanning

windowing
Intensity

thresholding

Optical flow

LiDAR points
projected to
camera

### Sensor Fusion

Geometric

closed-form
solution

Point-Wise Optical
Flow Measurements

Project to

velocity cube

Assign context
windows

Fig. 2. The CaRLi-V pipeline is divided into three steps: RADAR preprocessing, where raw ADC RADAR data is used to compute the RADAR velocity cube, a dense representation of velocities in the environment; Camera preprocessing, where two consecutive camera images are used to compute optical flow vectors for each pixel in the image; Sensor fusion, where the LiDAR point cloud is projected into both representations to extract radial velocity and optical flow readings, with both estimates combined through a closed-form solution.
converted to polar form and used to assign it to the nearest
bin in the discretized velocity cube. The radial velocity of
that point is then defined as the maximum-magnitude velocity within a local context window to mitigate the effects of spatial uncertainty inherent in RADAR measurements. In our implementation, this context window spans 5 azimuth bins, 10 elevation bins, and 20 range bins, corresponding to a physical coverage of about 10◦×50◦×0.938 m. Once again, these were selected based on our parameter ablation study.
For tangential velocity estimation, each LiDAR point is projected onto the image, and its corresponding optical flow vector provides an image-space motion constraint for that point. Through the camera intrinsics, this pixel displacement is mapped to motion in normalized image coordinates, while the LiDAR-derived depth provides the scale required to convert this motion into metric displacement. Due to the high spatial resolution of the camera and LiDAR, no context window is required. These image constraints are combined with the RADAR-derived radial velocity in a closed-form geometric solution of Eq. 2 to recover the full 3D velocity vector. Originally derived by Long et al. [7], this models the motion of a point from position p to q at constant velocity m˙ over time ∆t. In this same interval, the camera moves from B to A. The closed-form solution is

Am˙ =

B
AR1 − up

B
AR3
B
AR2 − vp

B
AR3
Arˆ

⊤

−1

Bq1 − up
Bq3
/∆t

Bq2 − vp
Bq3
/∆t
r˙
- ,

(2)
where Am˙ is the 3D velocity of the point q in A frame,

B
AR1,

B
AR2,

B
AR3 are the first, second, and third rows of the rotation matrix from A to B,

Bq1
,

Bq2
,

Bq3
the coordinates
of the point we are trying to measure in B frame, up and vp the image coordinates of point p,

Arˆ

⊤ is the unit vector

pointing in the direction from the RADAR frame origin | 4 2 2 4

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
Fig. 3. Effect of thresholding on the velocity cube. Thresholding removes saltand-pepper noise and improves spatial precision along the angular dimensions, concentrating velocity readings to regions corresponding to moving agents.

to point q expressed in A frame, and r˙ the radial velocity measured by the RADAR. For a detailed geometric derivation of how image-space motion is combined with radial velocity to recover full 3D velocity, the reader is referred to [7].

IV. RESULTS & DISCUSSION
Existing datasets providing RADAR, LiDAR, and camera data lack ground truth velocities [34]–[38], and those that do only provide RADAR point clouds [38]. As such, we collected a new dataset consisting of scenes with humans walking, waving, and manipulating RADAR retro-reflectors to test our pipeline on dynamic agents undergoing non-rigid motion. Details and access are provided in the supplementary material. Ground truth velocities were obtained by manually labelling bounding boxes around each object and measuring the displacement of their centroid across consecutive frames. For direct comparison, the point-wise velocity estimates from our pipeline were averaged over the same object clusters. Note that this methodology incurs certain limitations: non-rigid motion (e.g., limb movement) can alter bounding box dimensions, shifting centroids and affecting the ground truth estimate, which explains the larger deviation observed for humans compared to the rigid reflector (see Fig 4). Additionally, the average of point-wise velocities may be biased by local motions

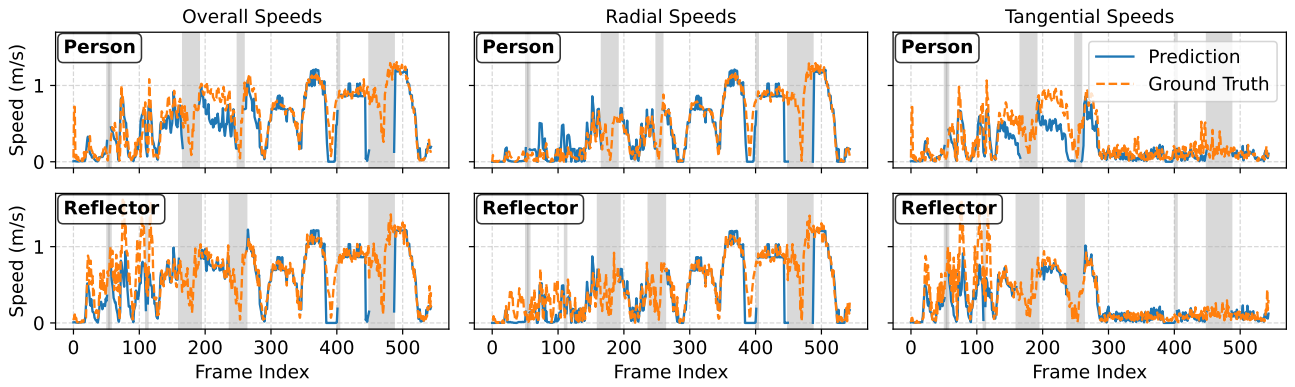
[picture p12: figure]
Speed (m/s); Person; Overall Speeds; Radial Speeds; Tangential Speeds; Prediction Ground Truth; Frame Index; Reflector

Fig. 4. Plots of the magnitude of the estimated (blue) and ground truth (orange) velocity vectors, as well as their decompositions into radial and tangential components. These are taken from Scene 1 of the provided dataset. Gray regions show areas where the target object moved out sensor range. Note the jitter in the ground truth is due to the fact that we use instantaneous velocity estimates of the centroid.

that deviate from the overall object motion. Nevertheless, since
centroid motion reflects the object translation, averaging point-wise velocities provides a coherent and comparable estimate
by capturing the dominant motion shared across most points. While non-rigid motions introduce local deviations, these are typically spatially limited and directionally inconsistent, and therefore tend to cancel out or diminish under averaging.
To quantify performance, we define the per-frame velocity error (VE) and velocity angular error (VAE) as:

ei = ∥vi − vˆi∥2

, θi = cos⁻¹

vi
- vˆi
∥vi∥2
- ∥vˆi∥2
. (3)

where vi and vˆi are the ground truth and estimated velocities at frame i respectively. We report the average (AVE, AVAE) and median (MVE, MVAE) of these quantities across frames, including tangential and radial components for the velocity error. Additionally, a weighted AVAE (AVAEw) is computed by weighting each θi by the magnitude of the ground truth velocity as small velocities may be ambiguous in direction. Overall, the pipeline produces dense, high-resolution velocity estimates that distinguish the motion of different dynamic agents, resolve multiple moving agents simultaneously, and capture localized non-rigid motions such as human limb movement (see Fig. 1). Notably, AVEtan is higher than AVErad, pointing to the optical flow branch as the main source of inaccuracy. This is visible in Fig 4, particularly in frames 200-250, where the predicted tangential speed for the person is underestimated, likely due to the use of NeuFlow v2 [25] instead of slower but more accurate methods such as RAFT [20]. Still, the gap between radial and tangential errors remains small, indicating that the proposed fusion strategy is able to recover motion reliably across different directions. Table I also shows that the standard deviations are relatively large for several metrics, indicating that the pipeline performs well for most frames, but degrades in a smaller number of more challenging cases. This is consistent with the consistently lower median values, suggesting that the typical error is substantially lower than the mean error, while a limited number of difficult frames disproportionately increase the average. These cases are likely associated with ambiguous motion conditions such as very small target velocities, where angular errors become unstable and optical-flow-based tangential estimation be-

TABLE I
VELOCITY ESTIMATION PERFORMANCE COMPARED TO THE GROUND TRUTH FROM SCENE 1 (STANDARD DEVIATION IN PARENTHESES)
Metric | TeFlow [19] Flow4D [18] DeltaFlow [17] | Ours

Velocity Magnitude Errors

AVE [m/s] | 0.39 (0.24) | 0.32 (0.23) | 0.32 (0.23) | 0.22 (0.21)
AVErad [m/s] | 0.17 (0.14) | 0.14 (0.13) | 0.15 (0.13) | 0.12 (0.16)
AVEtan [m/s] | 0.33 (0.23) | 0.26 (0.22) | 0.25 (0.22) | 0.16 (0.16)
MVE [m/s] | 0.37 | 0.30 | 0.29 | 0.14
MVErad [m/s] | 0.13 | 0.11 | 0.12 | 0.07
MVEtan [m/s] | 0.29 | 0.22 | 0.2 | 0.11

Velocity Angular Errors

AVAE [◦] | 38.1 (33.0) | 40.8 (38.2) | 40.9 (38.1) | 28.2 (33.0)
AVAEw [
◦] | 30.4 (28.4) | 30.0 (29.8) | 29.7 (29.0) | 18.0 (14.9)
MVAE [◦] | 24.0 | 22.8 | 22.7 | 13.1

comes more sensitive to noise. This is also reflected by the gap between AVAE and AVAEw, indicating that a substantial portion of the angular error is associated with low-speed points. Compared to [17]–[19], CaRLi-V achieves lower error on all reported metrics in Table I. Since the compared baselines are learned scene flow methods that infer motion indirectly from consecutive LiDAR frames, while CaRLi-V combines LiDAR geometry with direct RADAR velocities and image-based tangential constraints, this highlights the value of the proposed cross-modal fusion strategy for dense velocity estimation. Note that the RADAR’s limited angular resolution combined with the large Doppler context leads to velocity estimates occasionally bleeding into nearby static objects. This effect further increases the difference between AVAE and AVAEw since static points can exhibit large apparent angular deviations.

V. CONCLUSION
CaRLi-V presents a novel field-tested RADAR, LiDAR, and camera fusion pipeline for dense point-wise 3D velocity estimation. By introducing the velocity cube and combining it with optical flow and LiDAR in closed-form, CaRLi-V enables accurate velocity estimation for dynamic, non-rigid agents, outperforming state-of-the-art scene flow methods when evaluated on a custom dataset. Future work will focus on more advanced Doppler context window algorithms and temporal filtering strategies to reduce velocity bleeding, leveraging sparse optical flow for improved computational efficiency, and evaluating point-wise accuracy using motion capture techniques.

REFERENCES

[1] B. Yang, R. Guo, M. Liang, S. Casas, and R. Urtasun, “Radarnet: Exploiting radar for robust perception of dynamic objects,” 2020. [Online]. Available: https://arxiv.org/abs/2007.14366
[2] Y. Wang, J. Deng, Y. Li, J. Hu, C. Liu, Y. Zhang, J. Ji, W. Ouyang, and Y. Zhang, “Bi-lrfusion: Bi-directional lidar-radar fusion for 3d dynamic object detection,” in Proceedings of the IEEE/CVF Conference on Computer Vision and Pattern Recognition (CVPR), June 2023, pp. 13 394–13 403.
[3] J. Song, L. Zhao, and K. A. Skinner, “Lirafusion: Deep adaptive lidar-radar fusion for 3d object detection,” 2024. [Online]. Available: https://arxiv.org/abs/2402.11735
[4] D. Niederlohner, M. Ulrich, S. Braun, D. K ¨ | ohler, F. Faion, C. Gl ¨ | aser, ¨
A. Treptow, and H. Blume, “Self-supervised velocity estimation for automotive radar object detection networks,” in 2022 IEEE Intelligent Vehicles Symposium (IV), 2022, pp. 352–359.
[5] M. Kampelmuhler, M. G. M ¨ | uller, and C. Feichtenhofer, “Camera-based ¨
vehicle velocity estimation from monocular video,” 2018. [Online]. Available: https://arxiv.org/abs/1802.07094
[6] R. McCraith, L. Neumann, and A. Vedaldi, “Real time monocular vehicle velocity estimation using synthetic data,” 2021. [Online]. Available: https://arxiv.org/abs/2109.07957
[7] Y. Long, D. Morris, X. Liu, M. Castro, P. Chakravarty, and P. Narayanan, “Full-velocity radar returns by radar-camera fusion,” in Proceedings of the IEEE/CVF International Conference on Computer Vision, October 2021.
[8] H. Rohling, “Radar cfar thresholding in clutter and multiple target situations,” IEEE transactions on aerospace and electronic systems, no. 4, pp. 608–621, 2007.
[9] B. Zhou, S. Sun, Y. Zhang, M. Yu, and Y. Wang, “Towards deep radar perception for autonomous driving: Datasets, methods, and challenges,” Sensors, vol. 22, no. 11, p. 4208, 2022.
[10] L. Brune, K. Dietmayer, and N. Scheiner, “A survey of deep learningbased methods for fmcw radar odometry and ego-localization,” Applied Sciences, vol. 14, no. 6, p. 2267, 2024.
[11] R. Battrawy, Z. Li, B. Dellen, and N. Navab, “Dense scene flow estimation from sparse lidar and stereo images,” in IEEE/RSJ International Conference on Intelligent Robots and Systems (IROS). IEEE, 2019, pp. 7604–7610.
[12] C. M. Ng, Y. Chen, X. Jiang, A. Steed, and W. K. V. Lo, “Uncertainty estimation of dense optical flow for robust scene flow in dynamic environments,” Sensors, vol. 21, no. 21, p. 7212, 2021.
[13] A. Khoche, Q. Zhang, Y. Cai, S. S. Mansouri, and P. Jensfelt, “Dogflow: Self-supervised lidar scene flow via cross-modal doppler guidance,” arXiv preprint arXiv:2508.18506, 2025.
[14] Y. Lin and H. Caesar, “Icp-flow: Lidar scene flow estimation with icp,” 2024. [Online]. Available: https://arxiv.org/abs/2402.17351
[15] Q. Zhang, Y. Yang, P. Li, O. Andersson, and P. Jensfelt, “Seflow: A self-supervised scene flow method in autonomous driving,” 2024. [Online]. Available: https://arxiv.org/abs/2407.01702
[16] X. Li, J. Zheng, F. Ferroni, J. K. Pontes, and S. Lucey, “Fast neural scene flow,” 2023. [Online]. Available: https://arxiv.org/abs/2304.09121
[17] Q. Zhang, X. Zhu, Y. Zhang, Y. Cai, O. Andersson, and P. Jensfelt, “DeltaFlow: An efficient multi-frame scene flow estimation method,” in The Thirty-ninth Annual Conference on Neural Information Processing Systems, 2025. [Online]. Available: https://openreview.net/forum?id=T9 qNDtvAJX (https://openreview.net/forum?id=T9qNDtvAJX)
[18] J. Kim, J. Woo, U. Shin, J. Oh, and S. Im, “Flow4d: Leveraging 4d voxel network for lidar scene flow estimation,” IEEE Robotics and Automation Letters, vol. 10, no. 4, pp. 3462–3469, 2025.
[19] Q. Zhang, C. Jiang, X. Zhu, Y. Miao, Y. Zhang, O. Andersson, and P. Jensfelt, “TeFlow: Enabling multi-frame supervision for self-supervised feed-forward scene flow estimation,” in Proceedings of the IEEE/CVF conference on computer vision and pattern recognition, 2026.
[20] Z. Teed and J. Deng, “Raft: Recurrent all-pairs field transforms for optical flow,” 2020. [Online]. Available: https://arxiv.org/abs/2003.12039
[21] Y. Wang, L. Lipson, and J. Deng, “Sea-raft: Simple, efficient, accurate raft for optical flow,” 2024. [Online]. Available: https: //arxiv.org/abs/2405.14793
[22] A. Jahedi, M. Luz, L. Mehl, M. Rivinius, and A. Bruhn, “High resolution multi-scale raft (robust vision challenge 2022),” 2022. [Online]. Available: https://arxiv.org/abs/2210.16900
[23] Z. Teed and J. Deng, “Raft-3d: Scene flow using rigid-motion embeddings,” 2021. [Online]. Available: https://arxiv.org/abs/2012.007 26 (https://arxiv.org/abs/2012.00726)
[24] Z. Zhang, H. Jiang, and H. Singh, “Neuflow: Real-time, high-accuracy optical flow estimation on robots using edge devices,” in 2024 IEEE/RSJ International Conference on Intelligent Robots and Systems (IROS), 2024, pp. 5048–5055.
[25] ——, “Neuflow: Real-time, high-accuracy optical flow estimation on robots using edge devices,” in 2024 IEEE/RSJ International Conference on Intelligent Robots and Systems (IROS). IEEE, 2024, pp. 5048–5055.
[26] M. A. Richards, J. A. Scheer, and W. A. Holm, Principles of modern radar: basic principles. IET, 2010.
[27] A. Palffy, J. Dong, J. F. P. Kooij, and D. M. Gavrila, “Cnn based road user detection using the 3d radar cube,” IEEE Robotics and Automation Letters, vol. 5, no. 2, p. 1263–1270, Apr. 2020. [Online]. Available: http://dx.doi.org/10.1109/LRA.2020.2967272
[28] Y. Jin, Y. Kuang, M. Hoffmann, C. Schußler, A. Deligiannis, J.-C. ¨ Fuentes-Michel, and M. Vossiek, “Radar and lidar deep fusion: Providing doppler contexts to time-of-flight lidar,” IEEE Sensors Journal, vol. 23, no. 20, pp. 25 587–25 600, 2023.
[29] F. Fent, A. Palffy, and H. Caesar, “Dpft: Dual perspective fusion transformer for camera-radar-based object detection,” IEEE Transactions on Intelligent Vehicles, p. 1–11, 2024. [Online]. Available: http://dx.doi.org/10.1109/TIV.2024.3507538
[30] F. Ding, Z. Luo, P. Zhao, and C. X. Lu, “milliflow: Scene flow estimation on mmwave radar point cloud for human motion sensing,” in European Conference on Computer Vision. Springer, 2024, pp. 202–221.
[31] H. Liu, T. Lu, Y. Xu, J. Liu, and L. Wang, “Learning optical flow and scene flow with bidirectional camera-lidar fusion,” IEEE Transactions on Pattern Analysis and Machine Intelligence, vol. 46, no. 4, pp. 2378– 2395, 2023.
[32] S. Yao, R. Guan, Z. Peng, C. Xu, Y. Shi, W. Ding, E. Gee Lim,
Y. Yue, H. Seo, K. Lok Man, J. Ma, X. Zhu, and Y. Yue, “Exploring radar data representations in autonomous driving: A comprehensive review,” IEEE Transactions on Intelligent Transportation Systems, vol. 26, no. 6, p. 7401–7425, Jun. 2025. [Online]. Available: http://dx.doi.org/10.1109/TITS.2025.3554781
[33] Jwo, Dah-Jing, Wu, I-Hua, and Chang, Yi, “Windowing design and performance assessment for mitigation of spectrum leakage,” E3S Web Conf., vol. 94, p. 03001, 2019. [Online]. Available: https://doi.org/10.1051/e3sconf/20199403001
[34] W. Maddern, G. Pascoe, C. Linegar, and P. Newman, “1 Year, 1000km: The Oxford RobotCar Dataset,” The International Journal of Robotics Research (IJRR), vol. 36, no. 1, pp. 3–15, 2017. [Online]. Available: http://dx.doi.org/10.1177/0278364916679498
[35] D. Barnes, M. Gadd, P. Murcutt, P. Newman, and I. Posner, “The oxford radar robotcar dataset: A radar extension to the oxford robotcar dataset,” in Proceedings of the IEEE International Conference on Robotics and Automation (ICRA), Paris, 2020. [Online]. Available: https://arxiv.org/abs/1909.01300
[36] A. Palffy, E. Pool, S. Baratam, J. F. P. Kooij, and D. M. Gavrila, “Multiclass road user detection with 3+1d radar in the view-of-delft dataset,” IEEE Robotics and Automation Letters, vol. 7, no. 2, pp. 4961–4968, 2022.
[37] M. Meyer and G. Kuschk, “Automotive radar dataset for deep learning based 3d object detection,” in 2019 16th European Radar Conference (EuRAD), 2019, pp. 129–132.
[38] H. Caesar, V. Bankiti, A. H. Lang, S. Vora, V. E. Liong, Q. Xu, A. Krishnan, Y. Pan, G. Baldan, and O. Beijbom, “nuscenes: A multimodal dataset for autonomous driving,” in CVPR, 2020.

TABLE II
SUPPLEMENTARY MATERIAL
Supplementary Material | Description | Link
Dataset | The dataset was collected on the sensor rig shown in our public repository (https://github.com/Sol dann/CaRLi-V) (https://github.com/Soldann/CaRLi-V) using the following sensors: • V-MD3 RADAR transceiver • HESAI QT128 LiDAR • ZED 2i Camera The dataset consists of various scenes, each saved as a separate MCAP file. Furthermore, an annotated version of scene 1 is provided along with an evaluation script, which was used to test the accuracy of the velocity estimates. This annotated scene includes bounding boxes for the person and the RADAR reflector, which were moving throughout the scene. The bounding boxes were manually labeled for each frame separately using the online data annotation platform ”Supervisely” (https: //supervisely.com). The dataset consists of the following scenes (including the number of LiDAR frames in parentheses): • Scene 1: A person holding a radar reflector moving it up, down, left, right, forward, backward (545 frames) • Scene 2: A person moving forward, back, side to side, and in a figure 8 without a reflector (448 frames) • Scene 3: A person moving arms while stationary (391 frames) • Scene 4: A person moving just an arm holding the radar reflector (336 frames) • Scene 5: One stationary person holding a reflector, one moving person holding a reflector, and one moving then stationary person without a reflector (304 frames) • Angle Tests 1-6: A supplementary set of six MCAP files consisting of a person holding the RADAR reflector in different locations for testing of angular accuracy Ground truth: To compute the ground truth velocities, a Python script (included in our open-source repository) was used to extract the centroid of the bounding boxes at each frame, from which the person and the reflector velocities were computed by taking the displacement of the object’s centroid between consecutive frames divided by the time between frames. To compare our pipeline’s point- wise velocity estimates with these ground truth object-wise velocities, the average velocity of all points within each bounding box was used to compute the object-wise velocity at each frame. The same was done for the scene flow methods.

https://drive.google
.com/drive/folders/1
UL3VH1ohd WEl
az9 1rwBXL3sD56
v-sE?usp=drive link (https://drive.google.com/drive/folders/1UL3VH1ohd_WElaz9_1rwBXL3sD56v-sE?usp=drive_link)
Open-source package | The proposed pipeline has been implemented as an open-source ROS2 package. The package can be installed following the instructions on the GitHub page.

https://github.com/S
oldann/CaRLi-V (https://github.com/Soldann/CaRLi-V)
Ablation study | An ablation study was conducted to determine the best performing parameters regarding the non- maximum suppression threshold and the Doppler context cube dimensions. These were chosen to be 16 dB and 5 azimuth × 10 elevation × 20 range bins respectively. All experiments are provided in the linked document.Ablation Study Link (https://drive.google.com/file/d/1mmHAB13cUg7lGWQMyjycJdf3t4YLK5_b/view?usp=drive_link)
Azimuth angle estimation | An explanation of the linear approximation that was used for angle estimation has been provided in the attached supplementary material. | Azimuth Angle Esti- mation Link (https://drive.google.com/file/d/1mPeh8J50JbAY3uWld1gpxPougZ2WQW_p/view?usp=drive_link)
Supplementary Videos | Video 1: Main video giving an overview of the pipeline and of the methods used in this work. | https://youtu.be/k 9M2VB4EQu8 (https://youtu.be/k9M2VB4EQu8)
| Video 2: Video of the pipeline running on Scenes 1 and 3 of the collected dataset illustrating the pipeline in action. These scenes display a person walking around and moving a RADAR reflector in the air, and a person moving their arms around while standing in place. | https://youtu.be/M KxTlQ3L6q0 (https://youtu.be/MKxTlQ3L6q0)

Video 3: Video showcasing a comparison of the ground truth and computed velocity vectors in Scene
1. These are shown as velocity plots over time for the person and the retro-reflector individually.

https://youtu.be/M
MEd8KCGGbM (https://youtu.be/MMEd8KCGGbM)

Video 4: Video visualizing the effects of different windowing techniques on range-doppler RADAR cube data (of which the Hanning window was selected). This is compared to the RFFT (range FFT) output of the V-DM3 RADAR, which has its own signal processing pipeline to reject noise.

https://youtu.be/mqh
vvih8nNs (https://youtu.be/mqhvvih8nNs)

Video 5: Video visualizing the velocity cube alongside the LiDAR data of a scene to better illustrate the concept of the velocity cube.

https://youtu.be/bcn
T-UELoDg (https://youtu.be/bcnT-UELoDg)

TABLE III
SENSOR SETTINGS AND SPECIFICATIONS USED IN OUR DATASET.
V-MD3 RADAR | HESAI QT128 LiDAR | ZED 2i Camera
Setting used | 7 | Settings used | – | Settings used | –
Max range [m] | 6 m | Max range [m] | 50 m | Depth range [m] | 20 m (2.1 mm) / 35 m (4 mm)
Max speed [km/h] | 10 km/h | Max speed [km/h] | – | Max speed [km/h] | –
Range samples | 128 | Range samples | – | Range samples | –
Speed samples | 32 | Speed samples | – | Speed samples | –
Angle setting | 3D | FoV | 360◦ × 105.2
| | | ◦ | FoV | 110◦ × 70◦ × 120◦ (2.1 mm) / 72◦ × 44◦ × 81◦ (4 mm)
Frame rate [ms] | 130 ms | Frame rate [ms] | 100 ms and 50 ms (10 Hz and 20 Hz) | Frame rate [ms] | 10 ms (100 Hz)
Range res. [cm] | 4.69 cm | Range res. [cm] | – | Range res. [cm] | –
Speed res. [km/h] | 0.63 km/h | Speed res. [km/h] | – | Speed res. [km/h] | –
