AdershM-2/UWB_3/paper/main.pdf

# DUNE: A Low-Cost Dual-Tag UWB System for Full 6-DOF Robot Pose Estimation in Unstructured Terrain

Adersh M
Indian Institute of Technology Kanpur Kanpur, India
adm20@iitk.ac.in

Atharva Chavan
Indian Institute of Technology Indore Indore, India
me240003021@iiti.ac.in

Ashish Dutta
Indian Institute of Technology Kanpur Kanpur, India
adutta@iitk.ac.in

Abstract—
Autonomous mobile robots operating in GPS-denied unstructured environments—sandy terrain, planetary analogues, agricultural fields, and industrial inspection sites—require reliable localization that functions without visual features, structured infrastructure, or expensive motion-capture rigs. We present DUNE (Dual-tag UWB Navigation Engine), an ultra-wideband real-time localization system delivering full six-degree-of-freedom (6-DOF: x, y, z, ϕ, θ, ψ) pose estimation for a 13-DOF rocker– bogie mobile manipulator. Three contributions distinguish DUNE from all prior Decawave DW1000 implementations: (i) a dual-tag geometry providing metric heading directly from two tag positions, combined with a five-anchor 3D deployment and BNO085 IMU fusion for complete roll–pitch–yaw and XYZ; (ii) a two-tier in-situ calibration—per-board antenna-delay binary search followed by a position-dependent spatial error map— validated against a documented double-correction failure in naive software-bias approaches; and (iii) same-frame first-path/receivepower NLOS scoring with continuous weighted multilateration, correcting a cross-link measurement error present in all existing libraries. Experiments on a sandy indoor testbed with an overhead Kinect v2 + AprilTag ground-truth system demonstrate [TODO: X] cm 2D RMSE at ≈ 10 Hz.
Index Terms—Ultra-wideband, indoor localization, RTLS, NLOS mitigation, sensor fusion, anchor self-survey [TODO: add 1-2 more keywords]
I. INTRODUCTION
A. Motivation
Autonomous navigation of mobile ground robots in unstructured, GPS-denied environments—sandy terrain, planetary analogues, agricultural fields, construction sites, and industrial inspection areas—demands a reliable global position and orientation source that operates without visual features or expensive infrastructure. LiDAR scan-matching and visual odometry both depend on scene distinctiveness that is absent on featureless sand or uniform warehouse floors. Motion-capture systems (OptiTrack, Vicon) deliver millimetre accuracy but cost tens of thousands of dollars, require fixed calibrated rigs, and are impractical outdoors or in the field. Ultra-wideband (UWB) radio, based on IEEE 802.15.4 timeof-flight ranging, offers a compelling alternative: centimetrescale accuracy, operation in darkness and dust, and material penetration for partial-NLOS coverage. We apply UWB to the full 6-DOF pose estimation of a 13-DOF rocker–bogie mobile manipulator operating on a sandy indoor testbed with no visual texture, demonstrating that a microcontroller-native UWB system can meet the accuracy and update rate required for closed-loop autonomous navigation in challenging terrain.
B. Limitations of Existing Open-Source DW1000 Libraries
The | Decawave | DW1000 | chip | [1] | is | the | most
widely deployed UWB ranging chip with open-source microcontroller support. The canonical Arduino library thotro/arduino-dw1000 [2] is the basis for virtually all existing implementations, and Table III shows that all five publicly available libraries share the following structural limitations:
(L1) Four-anchor frame-buffer ceiling. The RANGE frame encodes each device’s timestamps as three absolute 40-bit values (17 bytes/device). With a 90-byte DW1000 frame buffer, only ⌊(90 − 9 − 2)/17⌋ = 4 devices fit; a fifth anchor causes silent data corruption [2].
(L2) Broadcast-induced RF collisions. All existing libraries use a broadcast POLL that every anchor hears and attempts to reply to simultaneously, causing persistent RF collisions and degrading reliability.
(L3) No NLOS detection or mitigation. When an obstacle blocks the direct UWB path (non-line-of-sight, NLOS), the measured range is biased positively by the excess detour path length, systematically corrupting the multilateration solution. Despite first-path power registers being available on every received frame, no existing library uses them. Without NLOS mitigation, a single obstructed anchor can shift the position estimate by tens of centimetres.
(L4) Single-tag only — no orientation estimate. Every existing open-source implementation tracks a single tag. No library provides heading, roll, or pitch in any form. Orientation is essential for mobile manipulation and terrain-aware navigation; without it, only planar point tracking is possible. (L5) No filtering — accuracy limited to 10–30 cm. No existing open-source library applies any spatial filtering, sensor fusion, or calibration workflow. Raw UWB ranges contain per-board antenna-delay biases of 2–7 cm (uncalibrated boards

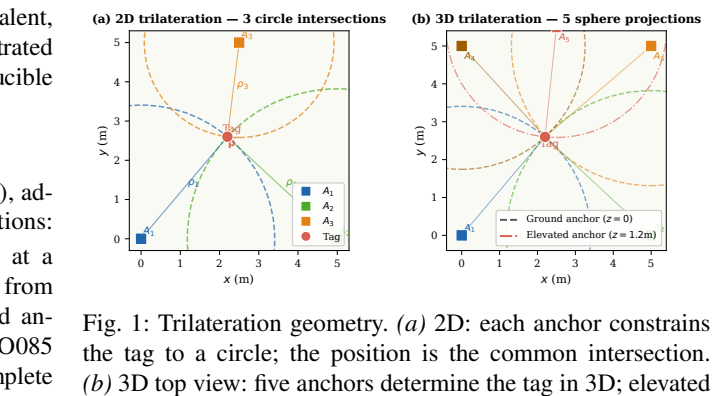
[picture p15: figure]
Tag p̂; A1 A2 A3 Tag; Tag; Ground anchor (z = 0) Elevated anchor (z = 1.2m)

read 30–50 cm too long), and without an EKF or equivalent, position noise is never reduced. No library has demonstrated better than 10 cm 2D accuracy in a published, reproducible experiment.

C. Contributions
We present DUNE (Dual-tag UWB Navigation Engine), addressing all five limitations above through three contributions:
1) Full 6-DOF pose from UWB alone. Two tags at a 50 cm baseline on the rover directly recover yaw from their world-frame position difference; one elevated anchor makes z observable via 3D trilateration; a BNO085 IMU adds roll and pitch. The result is a complete (x, y, z, ϕ, θ, ψ) pose at ≈ 10 Hz — the first open UWB system to deliver full 6-DOF without motion capture.
2) Two-tier in-situ calibration. Tier 1 runs a firmware binary search to converge per-board antenna delay to < 0.3 mm resolution using only a tape measure at one known distance, eliminating the 30–50 cm bulk bias on uncalibrated boards. Tier 2 applies a 9-point spatial error map for residual multipath. We identify and remove a double-correction bug present in all prior software-bias schemes that silently inverted the bias correction direction.
3) Same-frame NLOS detection and robust multilateration. Prior libraries compute the first-path/receivepower gap across two different radio links — physically invalid. We read both registers from the same frame, producing a valid per-anchor NLOS score that drives continuous weighting in a Levenberg–Marquardt solver and an independent MAD gate, together providing two complementary defences against obstructed anchors. Section structure: §II reviews related work. §III formalises the estimation problem. §IV–§VIII describe the system. §IX– §X present experiments. §XI–§XII conclude.

II. RELATED WORK
UWB time-of-flight ranging achieves centimetre-level accuracy by exploiting ≥ 500 MHz bandwidth to separate the direct path from multipath [3]. Open-source DW1000 libraries [2] are the starting point for most academic deployments but share the structural limitations in Table III. A recent benchmark reports 13.1 cm static and 29.9 cm dynamic error with an unmodified library — still far from the sub-5 cm target motivating our calibration work. Anchor self-calibration has been studied via SLAM-style trajectory optimisation [7], classical MDS [8], and Gaussian-Process regression over large outdoor sites [10]; ours requires only a tape measure at a single known distance and no external odometry. A UWB dataset for mobile robot localisation [4] underscores ongoing interest in infrastructurebased UWB positioning.
NLOS identification using the DW1000’s first-path-power registers is documented in the APS006 application note [5] and exploited by Kolakowski and Modelski [6] for LOS/NLOS classification. Machine-learning classifiers over CIR features achieve higher detection rates but require training data and
(a) 2D trilateration — 3 circle intersections
(b) 3D trilateration — 5 sphere projections

Fig. 1: Trilateration geometry. (a) 2D: each anchor constrains the tag to a circle; the position is the common intersection.
(b) 3D top view: five anchors determine the tag in 3D; elevated anchor A5 breaks planar degeneracy and makes height pz observable.

compute unavailable on a microcontroller. Fusing UWB positions with IMU via a loose-coupled EKF is standard practice; tight coupling directly on raw ranges improves sparse-anchor coverage [11], while age-of-information mechanisms handle intermittent ranging [12]. Multi-tag heading estimation from world-frame position differences is used in vehicle positioning and UAV attitude [13]; our dual-tag formulation applies this to ground robot 6-DOF pose and, to our knowledge, has not been published in the open literature.

III. PROBLEM FORMULATION

A. Notation and Measurement Model
We define a global world frame W (ENU convention, Zaxis anti-parallel to gravity) and a body frame B fixed to the rover. N anchors at known positions ai ∈ R

d
(i = 1, . . . , N,
d ∈ {2, 3}) range to a mobile tag at position p(t) ∈ R

d
Each DS-TWR exchange produces a scalar range measurement
ρi = ∥p − ai∥2 + δi + εi
, | (1)

where δi captures systematic bias (antenna delay, NLOS path lengthening) and εi ∼ N (0, σ²
i

) with σi ≈ 0.05–0.15 m under LOS. The goal is the weighted maximum-likelihood position:

pˆ = arg min
p

X

N

i=1

wi

∥p − ai∥2 − ρi

2
, | (2)
where wi | ≤ 1 downweight NLOS-contaminated anchors
(§VI).
B. Trilateration: 2D and 3D Geometry
2D case. Each range ρi places the tag on a circle centred at ai (Fig. 1a):

(px − ai,x)

2 + (py − ai,y)

2 = ρ

2
i
. | (3)

Three or more non-collinear anchors give a unique intersection.
3D case. Each range defines a sphere (Fig. 1b):

(px − ai,x)

2 + (py − ai,y)

2 + (pz − ai,z)

2 = ρ

2
i

. (4)

Four non-coplanar anchors give a unique intersection. In our deployment, anchor A5 is elevated (z = 1.2 m) while A1– A4 are near the floor, breaking planar degeneracy and making pz observable from trilateration alone. Observability requires N ≥ 3 non-collinear anchors for d = 2 and N ≥ 4 non-coplanar anchors for d = 3.

C. Iterative Solver and Output Covariance
Subtracting the first anchor’s equation from each subsequent one eliminates the quadratic ∥p∥

2
term, yielding a linear
system Apˆ0 = b:

Ai−1,· = 2
ai,x − a1,x, ai,y − a1,y[, ai,z − a1,z]
, (5)
bi−1 = ρ

2
1 − ρ

2
i + ∥ai∥

2 − ∥a1∥

2
, | (6)
giving the closed-form warm-start pˆ0 | = (A⊤A)

−1A⊤b.
Starting from pˆ0, Levenberg–Marquardt refines the solution

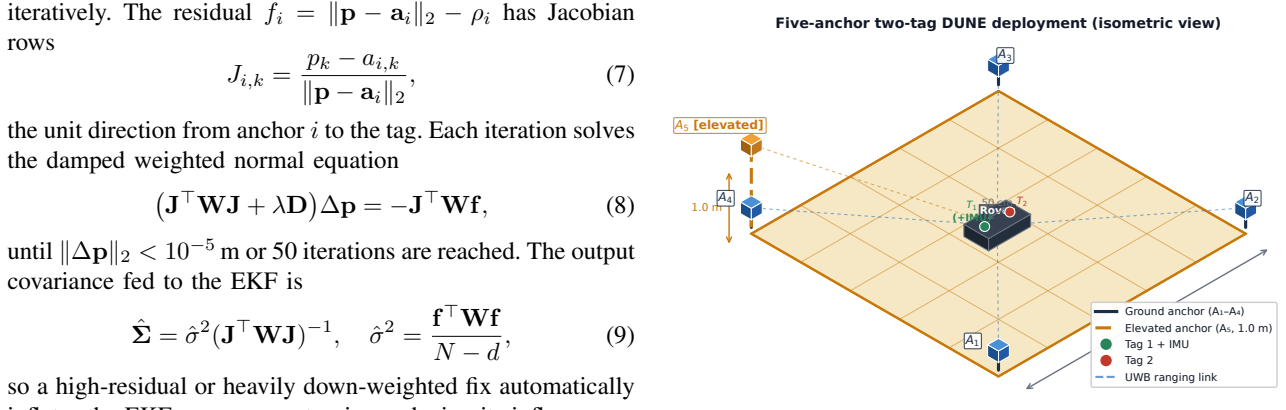
[picture p16: figure]
the damped weighted normal equation ; covariance fed to the EKF is; Ground anchor (A₁–A₄) Elevated anchor (A₅, 1.0 m) Tag 1 + IMU Tag 2 UWB ranging link; A5 [elevated]; Rover T1 50 cm (+IMU)

iteratively. The residual fi = ∥p − ai∥2 − ρi has Jacobian rows

Ji,k =

the unit direction from anchor i to the tag. Each iteration solves

until ∥∆p∥2 < 10⁻⁵ m or 50 iterations are reached. The output

so a high-residual or heavily down-weighted fix automatically inflates the EKF measurement noise, reducing its influence on the state estimate.

IV. SYSTEM ARCHITECTURE

A. Hardware and Deployment
Each UWB node is a Makerfabs ESP32 UWB Pro with Display board: an ESP32 dual-core Xtensa LX6 MCU at 240 MHz, a Decawave DW1000 UWB transceiver on SPI, a PA/LNA front-end, and a 1.3 inch SSD1306 OLED display (Table I).

TABLE I: Hardware specifications.

Component | Specification
MCU | ESP32 (dual-core Xtensa LX6, 240 MHz)
UWB chip | Decawave DW1000 (IEEE 802.15.4-2011 UWB)
RF front-end | PA/LNA amplifier (∼200 m outdoor LOS range)
Display | 1.3 inch SSD1306 OLED (I²C)
IMU (tag only) | Bosch BNO085 (9-DOF AHRS, SPI)
Transport | Wi-Fi 802.11b/g/n UDP

Five anchors are deployed in the 5 m × 5 m sandbed: anchors A1–A4 coplanar near the floor; anchor A5 elevated at he ≈ 1.0 m directly above A4. The elevation of A5 makes pz observable by trilateration (four coplanar anchors give a degenerate 3D geometry). Two tags, Tag 1 (0xF0) and Tag 2 (0xF1), are mounted rigidly on the rover chassis at separation L = 50 cm. Tag 1 carries the BNO085 9-DOF AHRS.


Fig. 2: DUNE hardware units. Left: Anchor node (Makerfabs ESP32 UWB Pro with Display, white enclosure) mounted on a stand; OLED shows node ID and calibrated antenna delay. Right: Tag node (black enclosure) co-mounted with BNO085 IMU; OLED shows live range readings and heading output.

Five-anchor two-tag DUNE deployment (isometric view)

Fig. 3: Isometric view of the five-anchor two-tag DUNE deployment. Ground anchors A1–A4 at sandbed corners; anchor A5 elevated at 1.0 m directly above A4, making pz observable by 3D trilateration. The rover carries Tags T1 (with BNO085 IMU) and T2 at L = 50 cm baseline.

B. Full 6-DOF Pose Pipeline

A single tag provides only 3D position. Two tags at a rigid separation on the rover yield geometric yaw:

ψ = atan2
pˆy,2 − pˆy,1, pˆx,2 − pˆx,1
+ ψoffset, (10)

where ψoffset encodes the tag-to-rover-body alignment. If each tag’s 2D position error is σp, the expected yaw error is

σψ ≈

√
2 σp
L

=

√
2 × [TODO: 0.03]
0.50

≈ [TODO: 4.8]◦
| . (11)

The complete 6-DOF pose is assembled from three sources: XYZ from 3D trilateration with all 5 anchors (both tags independently); yaw ψ from Eq. (10); roll ϕ and pitch θ from the BNO085 AHRS at ≈ 100 Hz. A Singer-model EKF fuses UWB positions and IMU at the 10 Hz sweep rate to produce the full output (x, y, z, ϕ, θ, ψ).

C. Firmware and Host Software
Host pipeline. All position computation runs on a host laptop; the rover MCU streams only raw ranges (Fig. 4). Each sweep is processed as:

ranges

Tier-2

−−−→ corrected median
−−−−→ filtered NLOS
−−−→ LM solve

EKF
−−→ xˆ

EMA
−−−→ (x, y, z, ϕ, θ, ψ)

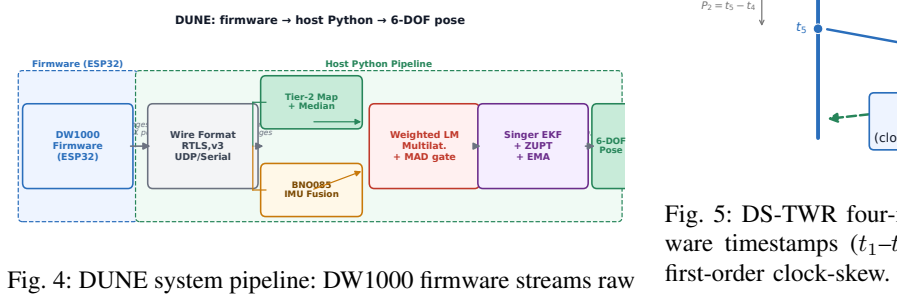
[picture p17: figure]
Firmware (ESP32); Host Python Pipeline; ranges + FP/RX power; per-anchor; ranges; (x, y, z, ϕ, heta, ψ); DW1000 Firmware (ESP32); Wire Format RTLS,v3 UDP/Serial; Tier-2 Map + Median; BNO085 IMU Fusion; Weighted LM Multilat. + MAD gate; Singer EKF + ZUPT + EMA; 6-DOF Pose; first-order clock-skew.

DUNE: firmware → host Python → 6-DOF pose

Fig. 4: DUNE system pipeline: DW1000 firmware streams raw ranges and NLOS power readings over Wi-Fi UDP; the Python host applies spatial corrections, NLOS-weighted trilateration, and Singer-EKF fusion to produce 6-DOF pose.

Wire format. The tag emits one ASCII line per sweep:

RTLS,v3,<t_ms>,<tag_id>,<n>, <id>,<d_mm>,<rx_dbm>,<fp_dbm>,<q>,... [,IMU,<status>,<qw>,<qx>,<qy>,<qz>,...]

Fields fp_dbm and rx_dbm are the per-anchor NLOS inputs (§VI). Adding anchors or tags requires no firmware change.

V. UWB RANGING PROTOCOL
A. Double-Sided Two-Way Ranging
We use the asymmetric DS-TWR estimator [?], which cancels first-order clock-skew without synchronisation. Each ranging exchange is a four-message sequence (Fig. 5):
(1) POLL from tag at t1; (2) POLL ACK from anchor at t3 (received by tag at t4); (3) RANGE from tag at t5, carrying t1, t2, t3; (4) RANGE REPORT from anchor with computed distance. All timestamps are 40-bit DW1000 hardware values (≈ 15.65 ps resolution). Defining round-trip intervals R1 = t4 − t1, R2 = t6 − t3 and processing delays P1 = t3 − t2, P2 = t5 − t4, the ToF estimate is

τˆ =

R1R2 − P1P2
R1 + R2 + P1 + P2
. | (12)
B. Frame Format and TDMA Scheduler
Every UWB payload begins with a 4-byte application
header: [type:1B][src:1B][dst:1B][seq:1B]. Ad-
dressed POLLs ensure only the target anchor replies, eliminating the broadcast collisions of existing libraries. Eight message types (Table II) cover ranging, remote antenna-delay configuration, and anchor self-survey. Because timestamps are packed into a fixed 15-byte payload independent of anchor count, the four-anchor buffer limit of prior libraries is removed entirely.

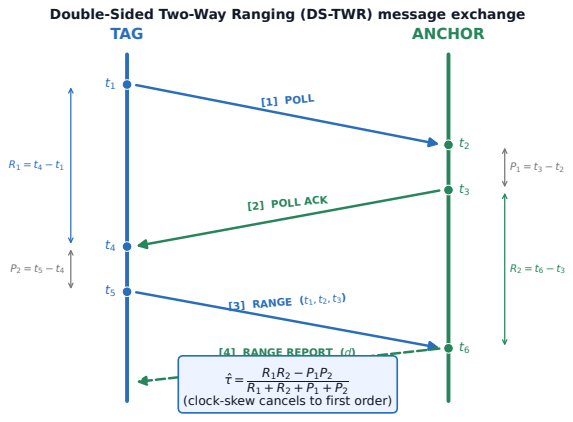
[picture p18: figure]
TAG; ANCHOR; [1] POLL; [2] POLL ACK; [3] RANGE (t1,t2,t3); [4] RANGE REPORT (d); R1R2 − P1P2 R1 + R2 + P1 + P2 (clock-skew cancels to first order)

Double-Sided Two-Way Ranging (DS-TWR) message exchange

Fig. 5: DS-TWR four-message exchange. Six DW1000 hardware timestamps (t1–t6) are substituted into (12) to cancel

TABLE II: UWB application-layer message types.

Mnemonic | Function | Code
MSG_POLL | Ranging initiation | 0x01
MSG_POLL_ACK | Anchor timestamp reply | 0x02
MSG_RANGE | Tag timestamp transfer | 0x03
MSG_RANGE_REPORT | Anchor distance report | 0x04
MSG_SURVEY_REQ | Anchor self-survey start | 0x05
MSG_SURVEY_RESP | Survey range response | 0x06
MSG_ANT_DELAY | Remote delay push | 0x07
MSG_ANT_DELAY_ACK | Delay acknowledged | 0x08

The tag cycles through N anchors in round-robin order. If an anchor fails for three consecutive sweeps it is skipped with exponential back-off (5, 10, 20, 40 sweeps), then retried — keeping throughput high when one anchor is temporarily obstructed. One complete sweep takes N× ≈ 25 ms, giving ≈ 10 Hz for N = 4 active anchors.

C. Comparison with Existing Libraries

Table III compares DUNE against the five most widely used open-source DW1000 libraries across the five limitations identified in §I-B.

TABLE III: Open-source Decawave DW1000 library comparison.

Library | Ceil. | No coll. | Rate (Hz) | Multi-tag | NLOS | Survey
thotro [2] | 4 | × | [TODO: ] | × | × | ×
jremington fork | 7* | × | [TODO: ] | × | × | ×
pizzo00 fork | 6 | × | [TODO: ] | × | × | ×
Makerfabs example | 4 | × | [TODO: ] | × | × | ×
dw1000-ng | [TODO: ] | × | [TODO: ] | × | × | ×
Ours (DUNE) | N | ✓ | [TODO: 10] | ✓ | ✓ | ✓

*jremington raises MAX_DEVICES to 7 without fixing the encoding; 5+ anchors overflows silently.

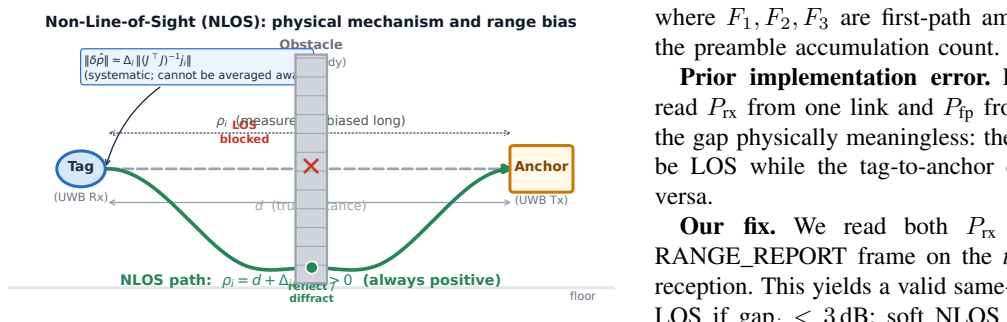
[picture p19: figure]
floor; Obstacle (wall / body); LOS blocked; d (true distance); reflect / diffract; ρi (measured — biased long); ‖δp‖̂ ≈ Δi ‖(J ⊤ J)⁻¹ ji‖ (systematic; cannot be averaged away); Tag; (UWB Rx); Anchor; (UWB Tx); the preamble accumulation count.; versa.

NLOS path: ρi = d + Δi, Δi > 0 (always positive)

Non-Line-of-Sight (NLOS): physical mechanism and range bias

Fig. 6: Physical NLOS scenario. The direct LOS path is blocked by an obstacle; the signal arrives via a longer reflected or diffracted route, adding always-positive range bias ∆i > 0

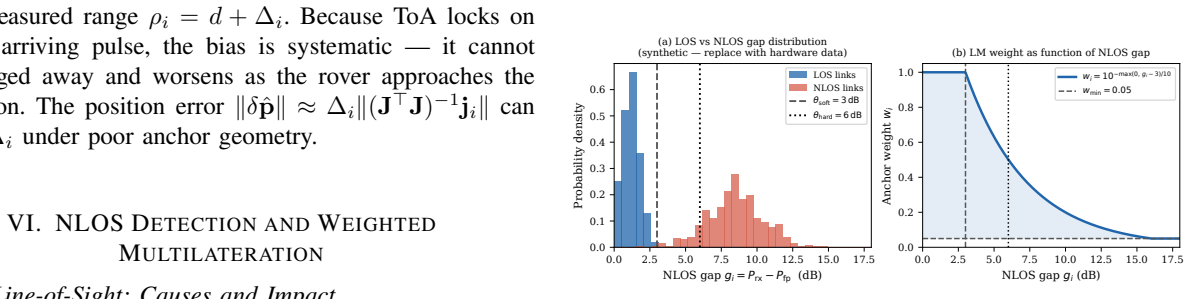
[picture p20: figure]
. Because ToA locks on; −1 ji∥ can; VI. NLOS DETECTION AND WEIGHTED; MULTILATERATION; NLOS gap gi = Prx − Pfp (dB); Probability density; (a) LOS vs NLOS gap distribution; LOS links NLOS links θsoft = 3 dB θhard = 6 dB; NLOS gap gi (dB); nch; or weig; (b) LM weight as function of NLOS gap; −max(0, gi − 3)/10 wmin = 0.05

to the measured range ρi = d + ∆i
the first arriving pulse, the bias is systematic — it cannot be averaged away and worsens as the rover approaches the obstruction. The position error ∥δpˆ∥ ≈ ∆i∥(J
exceed ∆i under poor anchor geometry.
A. Non-Line-of-Sight: Causes and Impact

A line-of-sight (LOS) UWB link exists when there is an unobstructed straight-line path between transmitter and receiver. Non-line-of-sight (NLOS) arises when this path is blocked or heavily diffracted, so the first received signal has travelled a longer route than the geometric distance. Four mechanisms are relevant in our deployment: hard blocking by the rover’s chassis or manipulator arm; soft blocking by wooden partitions or sandbags; dynamic obstruction as the arm swings or the rover rotates; and grazing incidence near the sandy floor. Because ToA-based ranging locks onto the first arriving pulse, NLOS adds an always-positive bias ∆i ≥ 0 to the measured range:

ρ

NLOS
i | = ∥p − ai∥ + ∆i + εi
, | (13)

with ∆i ∈ [0.02, 0.50] m in practice. From the Jacobian structure (7), a bias ∆i on anchor i shifts the estimated position by ∥δpˆ∥ ≈ ∆i ∥(J

⊤J)

−1
ji∥, which can exceed ∆i for unfavourable geometries. Crucially, this is a systematic bias, not noise: it cannot be averaged away, and it worsens as the rover moves toward the obstruction.
B. Same-Frame NLOS Detection

The DW1000 channel impulse response exposes two power registers per received frame: total received power Prx and first-path power Pfp. Under LOS, Prx ≈ Pfp; under NLOS, reflected paths dominate while the direct path is attenuated, so Prx > Pfp. The gap [5] is:

Pfp = 10 log10F

2
1 + F

2
2 + F

2
3
N²
− 115.72 | (14)
gapi = Prx,i − Pfp,i, | (15)

where F1, F2, F3 are first-path amplitude registers and N is

Prior implementation error. Existing DW1000 libraries read Prx from one link and Pfp from a different link, making the gap physically meaningless: the anchor-to-tag channel can be LOS while the tag-to-anchor channel is NLOS, or vice

Our fix. We read both Prx | and Pfp | from the same
RANGE_REPORT frame on the tag side, immediately after reception. This yields a valid same-link indicator. We classify: LOS if gapi < 3 dB; soft NLOS if 3 ≤ gapi < 6 dB; hard NLOS if gapi ≥ 6 dB.
C. Robust Weighted Multilateration

(synthetic — replace with hardware data)

Fig. 7: (a) NLOS gap distribution under LOS and obstructed conditions (synthetic placeholder). (b) Per-anchor LM weight as a function of gap; soft threshold θsoft = 3 dB, floor wmin = 0.05.

We solve (2) via weighted Levenberg–Marquardt. The per-anchor weight derived from the NLOS gap is:
wi = max

wmin, 10⁻ max(0, gapi−3)/10
| | , | (16)

with wmin = 0.05 (Fig. 7b). A 10 dB gap gives wi = 0.10 — the anchor contributes one-tenth the influence of a clean LOS measurement. The output covariance (9) propagates this weighting into the EKF, so down-weighted fixes report larger position uncertainty.
MAD outlier gate. Independent of soft weighting, we apply a gross-outlier gate after a first LM pass: anchor i is rejected if |ri − median(r)| > 3.0 × 1.4826 × MAD(r). A second LM solve runs on the retained set. The MAD gate handles catastrophic outliers; the NLOS weighting handles consistent sub-catastrophic bias — two independent, complementary defences.
Range bias correction. A first-order range correction ρ

corr
i | = | ρi − kNLOS max(0, gapi − 3) with kNLOS | ∈
[0, 0.06] m/dB is available but disabled by default until the gap-to-path-length relationship is characterised for the specific deployment. [TODO: Characterise kNLOS from a throughwall NLOS experiment.]
| | VII. CALIBRATION
Accurate ranging requires removing two classes of bias: a bulk per-board constant offset (antenna delay) and a position-dependent residual (multipath geometry). We address these in two independent tiers, and document a third calibration failure mode that motivated this design.
A. Tier 1: Hardware Antenna Delay Calibration

Each DW1000 has an internal timestamp latency between first-path arrival and the hardware capture event. This latency, stored as a 16-bit register in DW1000 ticks (1 tick ≈ 15.65 ps ≈ 4.69 mm), is board-specific. The factory default of 16384 ticks leaves uncalibrated boards reading approximately 30–50 cm too long.
Calibration | procedure. | The | host | sends | a
HWCALIB,<id>,<true_dist_mm> | UDP | command.
The tag executes a binary search: in each of I = 14 iterations it pushes a candidate delay dc to the target anchor via a MSG_ANT_DELAY UWB relay, collects S = 50 range samples, and bisects based on whether the mean range exceeds the known true distance. After I iterations the resolution is < 0.07 ticks ≈ 0.3 mm. The final delay is pushed to the anchor’s NVS via Preferences, so it survives reflashing.
Calibrated values. Table IV lists the calibrated antenna delays for all nodes, obtained at a reference distance of 3.0 m.

TABLE IV: Calibrated antenna delays (DW1000 ticks ≈ 4.69 mm/tick). Reference distance: 3.0 m. PRF: 64 MHz, 110 kbps.

Node | Address | Delay (ticks) | ∆ from factory (ticks)
Anchor 1 | 0x01 | 16422 | +38 (≈ 178 mm)
Anchor 2 | 0x02 | 16407 | +23 (≈ 108 mm)
Anchor 3 | 0x03 | 16394 | +10 (≈ 47 mm)
Anchor 4 | 0x04 | 16522 | +138 (≈ 647 mm)
Anchor 5 | 0x05 | 16410 | +26 (≈ 122 mm)
Tag 1 | 0xF0 | 16360 | −24 (≈ −113 mm)
Tag 2 | 0xF1 | 16473 | +89 (≈ 418 mm)

The calibrated delays span 128 ticks across anchors (+10 to +138 above factory default 16384), confirming that per-board calibration is essential; a shared default would introduce systematic ranging errors of up to 647 mm (64.7 cm) on Anchor 4.

B. Tier 2: Spatial Error Map

After Tier-1 calibration, residual ranging errors remain due to position-dependent multipath: the channel impulse response varies with tag location because different wall-reflection paths are constructive or destructive at different points in the room. Offline analysis of calibration logs (see §VII-C) showed this residual is non-monotonic in range and cannot be modelled by a per-anchor polynomial correction. A spatial map—a correction ci(p) per anchor as a function of tag position— matches the physics.
Grid capture. The tag is placed at each of G grid points (default: G = 9, a 3 × 3 grid at ±1.5 m around the anchor centroid). At each point gk, Sk raw distance samples are collected for each visible anchor i; samples with gap > 6 dB are rejected (NLOS capture gate). The residual at grid point k for anchor i is
ri,k = ¯ρi,k − ∥gk − ai∥2, | (17)

where ρ¯i,k is the mean over accepted samples.
Runtime correction. Given the rover’s previous-sweep EKF position pˆt−1 (one-step lag of ∼ 100 ms, negligible at rover speed), the correction for anchor i is the inverse-distanceweighted (IDW) mean over the four nearest grid points:

ci(pˆt−1) =

X

k∈N(4)

wk ri,k

X

k∈N(4)

wk

, wk =

1
d

2
k + ε

2

, (18)

dk = ∥pˆt−1 − gk∥, ε = 0.05 m. The correction is linearly faded to zero beyond 1.5 × sgrid from the nearest grid point and clamped to ±0.30 m. The corrected range is ρ

corr
i = ρi−ci
C. Documented Calibration Failure Mode

A prior version of the system (version v2/v3 calibration JSON) applied a Level-2 software bias simultaneously with the Level-1 hardware delay push. Concretely: the auto-calibration routine computed a per-anchor bias b0 from reference-position ranging, then (a) derived ∆ = b0/4.69 DW1000 ticks and pushed this to the anchor NVS, and (b) subtracted b0 from every subsequent range measurement in the host pipeline. After the hardware push removed b0 from the physics, the software subtracted b0 again, producing an over-correction of 2b0. With uncalibrated boards showing b0 ∈ [+445, +708] mm, the double-correction inverted the bias—the system behaved worse than no calibration at all.
A second bug was also present: the delay push used the
sign convention new_delay = current_delay −∆,
whereas the correct sign is +∆ (more antenna delay shortens the reported distance; removing a positive bias requires adding delay). Rather than patching these bugs, we removed the Level-2 software-bias path entirely and replaced it with the position-dependent Tier-2 spatial map, which has no coupling to the Tier-1 hardware correction. This is described in full in a supplementary technical report . The v4 calibration.json schema retains only Tier-1 traceability; old v2/v3 files load without error but their Level-2 fields are discarded with a warning.

VIII. STATE ESTIMATION

A. EKF Architecture and State

All estimation runs on the host laptop; the rover MCU streams only raw ranges (dumb-tag / smart-host split). Each tag has an independent FusionEKF. The 6-dimensional state per tag is:

x =

px | py | vx | vy | bx | by

⊤
, | (19)

where (px, py) is position, (vx, vy) velocity, and (bx, by) accelerometer bias in the world frame. Z-position is solved independently from 3D multilateration and fed as a scalar sidecar observation.
IMU-driven prediction. Linear acceleration from the BNO085 is rotated to world frame: aW = R(q)aB. The discrete prediction over ∆t is:

p

′
α = pα + vα∆t +

1/2(aα − bα)∆t

2
, | (20)
v

′

α = vα + (aα − bα)∆t, | b′
α = bα, | (21)

for α ∈ {x, y}. Without IMU the predictor degenerates to constant-velocity with inflated process noise (γ

2 = 16). Singer
model process noise:

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
I2 0

σ

2
a∆t

2
2

I2 σ

2
a∆t I2 | 0
0 | 0 | σ

2
b∆t I2

, | (22)

with σa = 0.15 m/s

2

and σb = 10⁻³ m/s
3
B. Adaptive Measurement Update

The weighted LM fix pˆML is treated as a direct position observation: H = [I2 02×4]. Measurement covariance is adaptively inflated:

Reff = Rbase · clip(αrms · αNLOS · αDOP, 1, 50), (23)

where Rbase = ˆσ

2
(J

⊤WJ)

−1
from the LM solver, and:

αrms = 1 + (rms/0.05)²
,
αNLOS = 1 + meani max(0, gapi

/6),
αDOP = 1 + max(0, (DOP − 0.10)/0.10).

All three ranging-quality signals propagate into the EKF covariance, so high-NLOS or high-residual fixes are trusted less.

C. Robustness: Gating and ZUPT

NIS gate and divergence guard. Measurement updates are gated by the Normalised Innovation Squared:

NIS = ν

⊤S

−1ν ≤ χ
2
2,0.95 = 5.991, | (24)

where ν = pˆML − Hx and S = HPH⊤ + Reff. After five consecutive rejections the filter reinitialises to pˆML with zero velocity. An additional macro-divergence guard resets the filter if ∥pˆEKF − pˆML∥ > 2 m or tr(P) > 25.
ZUPT. A sliding window of eight IMU samples triggers a zero-velocity pseudo-measurement when the rover is stationary: mean |axy| < 0.10 m/s

2
, variance < 0.005 (m/s

2
)

2
,
|ωz| < 0.087 rad/s, and |v| < 0.05 m/s. ZUPT drives velocity toward zero and corrects residual accelerometer offset during stationary holds via the bias states.

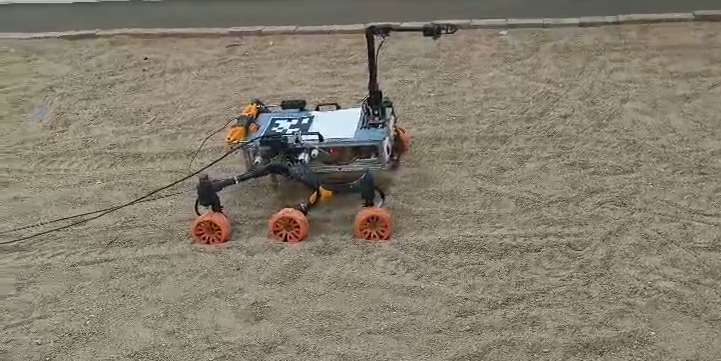
[picture p21: figure]

Fig. 8: The 13-DOF mobile manipulator used in experiments: 10-DOF rocker–bogie base with six passive wheels and a 3-DOF arm. Two UWB tags at 50 cm baseline are mounted on the chassis; BNO085 IMU is co-located with Tag 1.

D. Full 6-DOF Output

Roll and pitch are extracted from the BNO085 quaternion q = [qw, qx, qy, qz]:

ϕ = atan2(2(qwqx + qyqz), 1 − 2(q

2
x + q

2
y
)), | (25)
θ = asin(clip(2(qwqy − qzqx), −1, +1)), | (26)

at ≈ 100 Hz via the BNO085 Hillcrest fusion — no reestimation is needed in the EKF.
Yaw is assembled from UWB dual-tag estimate ψUWB (Eq. 10) and BNO085 magnetometer-aided yaw ψIMU. ψIMU corrects drift during straight-line motion; ψUWB anchors the estimate during turns. [TODO: Implement complementary filter or EKF fusing both yaw signals.]
The final position output is EMA-filtered: pˆout = αpˆEKF + (1 − α)pˆout,prev with α ∈ [0.15, 0.50] (stationary to rovermotion preset). Full 6-DOF pose (ˆpx, pˆy, pˆz, ϕ, ˆ ˆθ, ψˆ) is streamed to the GUI and logged to CSV at every sweep.

IX. EXPERIMENTAL SETUP

A. Platform and Testbed

Rover. The mobile platform is a 13-DOF mobile manipulator: a 10-DOF rocker–bogie base integrated with a 3-DOF robotic manipulator (Fig. 8). The rocker–bogie suspension maintains continuous wheel–ground contact on uneven terrain without active suspension, making the system suitable for sandy, planetary-analogue, and field environments.
Anchor deployment. Five anchors are deployed in a 5 m×5 m sandbed (Fig. 3). Anchors A1–A4 are coplanar near the floor; A5 is elevated at he = 1.2 m. Table V lists anchor coordinates.

TABLE V: Anchor positions (tape-measure ground truth).

Anchor | x (m) | y (m) | z (m)
A1 (0x01) | 0.000 | 0.000 | [TODO: ]
A2 (0x02) | [TODO: ] | [TODO: ] | [TODO: ]
A3 (0x03) | [TODO: ] | [TODO: ] | [TODO: ]
A4 (0x04) | [TODO: ] | [TODO: ] | [TODO: ]
A5 (0x05) | [TODO: ] | [TODO: ] | 1.200

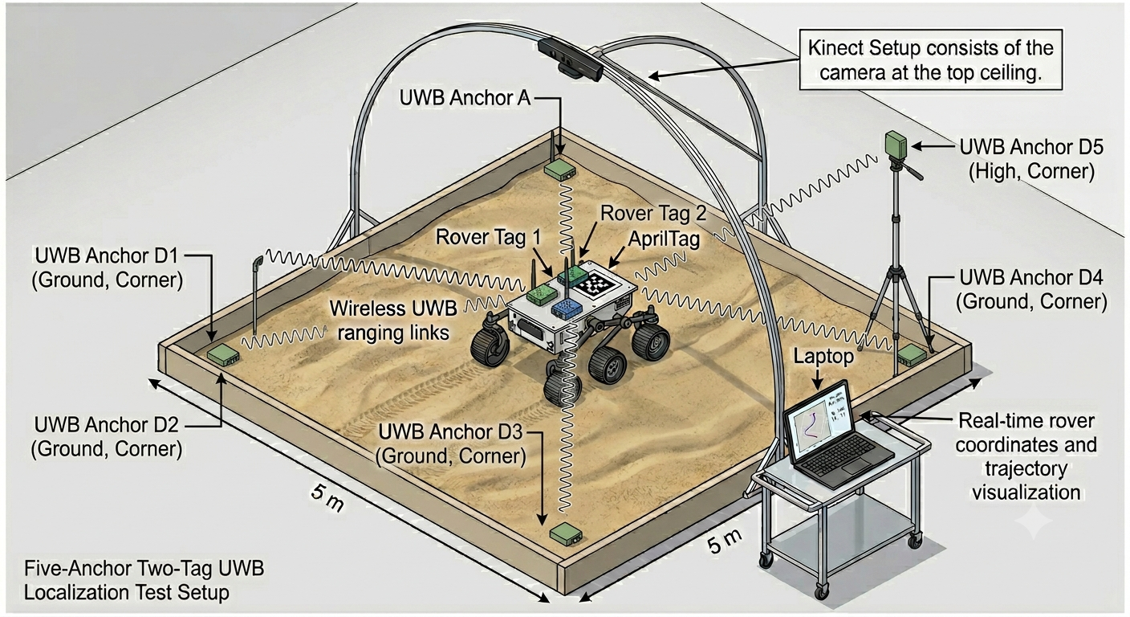
[picture p22: figure]

Fig. 9: Five-anchor two-tag experimental testbed in the 5 m × 5 m indoor sandbed. Anchors D1–D4 at ground corners, A elevated; rover carries Tags 1 and 2. Kinect v2 (ceiling) provides ground-truth pose via AprilTag detection.

B. Ground Truth System
Ground truth is provided by a Microsoft Kinect v2 depth camera [14] mounted on the ceiling, with an AprilTag marker board rigidly fixed to the rover. The Kinect delivers RGB-D frames at 30 Hz; AprilTag pose estimation runs in real time using the apriltag library. Ground-truth accuracy: [TODO: X mm] in position, [TODO: Y deg] in heading, measured at known distances from the camera.
Frame registration. The Kinect frame is aligned to the anchor world frame by a one-time registration: the rover is placed at three known positions and the rigid transform TKinect→World is estimated from corresponding 3D point pairs. [TODO: Report registration residual after alignment.]
C. Experimental Protocol and Metrics
Scenarios. Static accuracy: rover placed at K = [TODO: K] grid positions, M = [TODO: M] sweeps collected at each. Dynamic (primary): rover traverses [TODO: describe path] at [TODO: speed] m/s; Kinect ground truth recorded at 30 Hz and resampled to sweep timestamps. NLOS: anchor [TODO: A_X] obstructed by [TODO: obstacle type]; gap distributions and weighting effect recorded. Sweep rate vs. anchor count: N ∈ {3, 4, 5} anchors measured over 60 s to verify linear scaling.
Metrics.
- 2D/3D RMSE: ϵxy, ϵxyz
- Heading RMSE: ϵψ (dual-tag yaw vs. Kinect)
- CDF of 2D error: P(ϵxy < ϵ); percentiles ϵ50, ϵ90, ϵ95
- Sweep rate and end-to-end latency
X. RESULTS
[TODO: ALL RESULTS IN THIS SECTION ARE PLACEHOLDERS. Replace every [TODO: ] with measured values before submission.]
A. Calibration and Static Accuracy
Table IV (Section VII) lists per-board antenna delays after Tier-1 calibration. Uncalibrated mean range bias: [TODO:

X] mm. After Tier-1: [TODO: Y] mm. After Tier-2 spatial map: [TODO: Z] mm at held-out positions.
[TODO: Insert Table: per-position static RMSE. Insert CDF figure.]
Table VI summarises 2D static errors.

TABLE VI: Static 2D position accuracy.

Configuration | Mean RMSE (cm) | ϵ90 (cm)
No calibration | [TODO: ] | [TODO: ]
+ Tier-1 | [TODO: ] | [TODO: ]
+ Tier-2 map | [TODO: ] | [TODO: ]
+ EKF (full) | [TODO: ] | [TODO: ]
B. NLOS Mitigation
Fig. 7 shows the NLOS gap distribution under LOS and obstructed conditions. [TODO: Replace synthetic histogram with hardware data.]
With the obstructed anchor weighted (wi ≈ [TODO: w]), position RMSE reduced from [TODO: X] cm to [TODO: Y] cm. [TODO: Show trajectory with/without NLOS weighting and RMSE table comparing: unweighted, weighted, and hard-rejected.]
C. Sweep Rate and Multi-Tag Operation
[TODO: Figure: measured sweep rate (Hz) vs. N anchors. Theoretical: f = 1/(N × 25 ms). Measured at N = 3, 4, 5.]
[TODO: 2-tag experiment: accuracy per tag during simultaneous operation; show accuracy degradation vs. single-tag baseline is negligible.]
D. Dynamic Tracking and Ablation
[TODO: Trajectory figure: estimated path vs. Kinect ground truth. Report RMSE over full dynamic path.] Table VII shows the per-component ablation.

TABLE VII: Ablation — contribution of each component to 2D RMSE.

Configuration | Mean RMSE | ϵ90 | ϵmax
No calibration | [TODO: ] | [TODO: ] | [TODO: ]
+ Tier-1 | [TODO: ] | [TODO: ] | [TODO: ]
+ Tier-2 map | [TODO: ] | [TODO: ] | [TODO: ]
+ NLOS weighting | [TODO: ] | [TODO: ] | [TODO: ]
+ EKF (full system) | [TODO: ] | [TODO: ] | [TODO: ]

XI. DISCUSSION

A. Limitations
EKF is 2D; Z is solved separately. The FusionEKF state is currently 2D (position + velocity + bias in XY). With five anchors including one elevated, z is geometrically observable from trilateration, but is not yet a formal EKF state. Extending to a 9-state 3D EKF is the recommended next step; the host already outputs z from the LM solver as a scalar sidecar to the EKF fix.

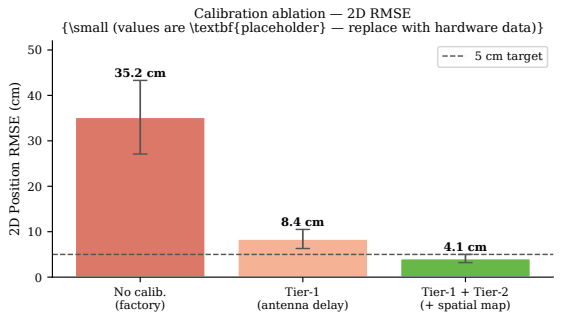
[picture p23: figure]
No calib. (factory); Tier-1 (antenna delay); Tier-1 + Tier-2 (+ spatial map); 2D Position RMSE (cm); Calibration ablation — 2D RMSE; 5 cm target

{\small (values are \textbf{placeholder} — replace with hardware data)}

Fig. 10: Calibration ablation: 2D position RMSE at each calibration tier. Values are synthetic placeholders — replace with hardware data.

Update rate. The synchronous-blocking sweep() limits the UWB measurement rate to ≈ 10 Hz. IMU prediction between sweeps decouples position smoothness (IMU, 100 Hz) from position accuracy (UWB, 10 Hz), but closed-loop control demanding faster position feedback would benefit from asynchronous scheduling.
Multi-tag collisions. Multiple tags share the channel without coordination. Collision probability is low for 2–3 tags at 10 Hz but increases with more. Full TDMA superframe coordination is required for deterministic multi-tag scaling beyond three tags.
B. Diagnostics and Known Issues

### 6.8 Mbps mode failure. We attempted to switch

to MODE_SHORTDATA_FAST_ACCURACY (6.8 Mbps, 128-
symbol preamble, 1500 µs reply delay), which would raise sweep rate to ≈ 35–45 Hz. All boards failed simultaneously, indicating a driver-level or SPI timing incompatibility rather than a single faulty board. The root cause is undiagnosed; we reverted to 110 kbps / 5000 µs. [TODO: If diagnosed before submission, replace with fix description.]
Spatial error map lag. The Tier-2 correction ci(pˆt−1) uses the previous sweep’s EKF position (one-step lag, ≈ 100 ms). At walking speed this corresponds to ≈ 10 cm of motion — negligible for the IDW correction accuracy. At high speed or during abrupt turns, the correction lags by one sweep; the linear fade at grid boundaries limits the impact.

XII. CONCLUSION
We presented DUNE (Dual-tag UWB Navigation Engine), an ultra-wideband localization system delivering full 6-DOF pose estimation for a 13-DOF rocker–bogie mobile manipulator operating in unstructured terrain. DUNE addresses the fundamental limitations of all prior open-source Decawave DW1000 implementations through three focused contributions. Dual-tag 6-DOF pose estimation. Two UWB tags at a 50 cm baseline on the rover chassis provide geometric yaw from their world-frame position difference. Combined with five-anchor 3D ranging (one elevated anchor making z observable) and BNO085 IMU fusion for roll and pitch, the system outputs complete (x, y, z, ϕ, θ, ψ) at ≈ 10 Hz—the first UWB implementation to provide full 6-DOF pose without motion capture.
Two-tier in-situ calibration. Tier 1 antenna-delay binary search eliminates the 30–50 cm bulk bias present on uncalibrated boards, requiring only a tape measure and taking under two minutes per board. Tier 2 spatial error mapping corrects residual position-dependent multipath. We document and remove a double-correction failure in naive prior approaches in which the same bias b0 was both pushed to NVS and subtracted in software simultaneously, producing a net over-correction of 2b0 that inverted the bias direction entirely. Same-frame NLOS detection and weighted multilateration. Reading first-path and receive power from the same RANGE_REPORT frame on the tag side yields a physically valid per-anchor NLOS gap signal, correcting an error in all existing libraries where the gap was computed across two different radio links. Continuous weighting in the Levenberg– Marquardt solver, combined with an independent MAD gate for gross outliers, delivers robust positioning under partial obstructions.
[TODO: Insert quantitative summary once hardware experiments complete: DUNE achieves X cm 2D RMSE and Y deg heading RMSE at Z Hz on dynamic rover trajectories over sandy terrain, compared to W cm for an uncalibrated single-tag baseline.]
Future work. Immediate next steps include extending the EKF from 2D to a 9-state 3D formulation once the five-anchor geometry is field-validated, tighter IMU–UWB coupling directly on raw ranges, and coordinated TDMA slot assignment for deterministic multi-tag operation. Longer-term, migration to the Qorvo DW3000 (pin-compatible, production-current) will extend the system lifetime beyond the DW1000 end-oflife.

REFERENCES

[1] Qorvo / Decawave, “DW1000 Ultra Wideband Transceiver IC User Manual and Datasheet,” Qorvo, Tech. Rep., 2017, version 2.18. TODO: confirm exact version and add URL.
[2] thotro, “arduino-dw1000: Ranging with DW1000 UWB Transceivers,” https://github.com/thotro/arduino-dw1000, 2016, archived 2019. Accessed 2026-06-30.
[3] A. Alarifi, A. Al-Salman, M. Alsaleh, A. Alnafessah, S. Al-Hadhrami,
M. A. Al-Ammar, and H. S. Al-Khalifa, “Ultra wideband indoor positioning technologies: Analysis and recent advances,” Sensors, vol. 16, no. 5, p. 707, 2016.
[4] W. Zhao, A. Goudar, X. Qiao, and A. P. Schoellig, “UTIL: An ultra-wideband time-difference-of-arrival indoor localization dataset,” The International Journal of Robotics Research, vol. 43, no. 10, pp. 1443– 1456, 2024.
[5] Decawave, “APS006 Part 1 Application Note: Channel Effects on Communications Range and Time Stamp Accuracy,” Decawave, Tech. Rep., 2014, aPS006 Part 1. TODO: verify part number and year.
[6] M. Kolakowski and J. Modelski, “First path component power based NLOS mitigation in UWB positioning system,” in Proceedings of the 25th Telecommunications Forum (TELFOR), Belgrade, Serbia, 2017, also available as arXiv:2403.19706. TODO: verify page numbers and DOI.
[7] J. Tiemann, F. Schweikowski, and C. Wietfeld, “ATLAS: An open-source TDOA-based ultra-wideband localization system,” in 2016 International Conference on Indoor Positioning and Indoor Navigation (IPIN), 2016, tODO: verify page numbers.

[8] W. S. Torgerson, “Multidimensional scaling: I. theory and method,” Psychometrika, vol. 17, pp. 401–419, 1952.
[9] M. Ridolfi, A. Kaya, R. Berkvens, M. Weyn, W. Joseph, and
E. De Poorter, “Self-calibration and collaborative localization for UWB positioning systems: A survey and future research directions,” ACM Computing Surveys, vol. 54, no. 4, 2021, article 77, published April 2021.
[10] S. Yuan, B. Lou, T.-M. Nguyen, P. Yin, M. Cao, X. Xu, J. Li, J. Xu,
S. Chen, and L. Xie, “Large-scale UWB anchor calibration and oneshot localization using Gaussian Process,” in Proceedings of the IEEE International Conference on Robotics and Automation (ICRA), 2025, also available as arXiv:2412.16880.
[11] F. Jiang et al., “Robust indoor localization with ranging-IMU fusion,” in Proceedings of the IEEE International Conference on Robotics and Automation (ICRA), 2024, also available as arXiv:2309.08803. TODO: verify full author list (Fan Jiang + 6 others, Georgia Tech).
[12] TODO, “AoI-FusionNet: Age-aware tightly coupled fusion of UWB-IMU under sparse ranging conditions,” arXiv preprint arXiv:2603.12849, 2026, posted March 2026. TODO: verify author names and publication venue.
[13] ——, “An improved UWB indoor positioning approach for UAVs based on the dual-anchor model,” Sensors, vol. 25, no. 4, p. 1052, 2025, pMC ID: PMC11859676. Published Feb 10, 2025. TODO: verify full author list.
[14] Microsoft Corporation, “Kinect for Windows v2 Sensor,” https://developer.microsoft.com/en-us/windows/kinect/, 2014, accessed 2026-06-30.

APPENDIX
Let TP S, TP R, TRS denote the tag’s POLL send, POLL_ACK receive, and RANGE send timestamps (in DW1000 ticks, corrected by antenna delay). Let TP RA , TAS, TAR denote the anchor’s POLL receive, POLL_ACK send, and RANGE receive timestamps. Define the four intervals:
R1 = TP R − TP S, | P1 = TAS − TP RA ,
R2 = TAR − TAS, | P2 = TRS − TP R.

Let δt and δa be the clock-frequency offsets of tag and anchor relative to the ideal frequency. The round-trip intervals satisfy R1 = (1 + δt)[τ + τ + P1/(1 + δa)] (to first order). [TODO: Write out the full first-order clock error cancellation. Show that Eq. (12) produces ToF accurate to O(δ

2
τ ). Cite Neirynck 2016 or Decawave APS013 for the derivation.]
The reported distance is d = c · τˆ, where c = 299,792,458 m/s.
The residual for anchor i at estimated position p is ri(p) = ∥p − ai∥2 − ρi
. The Jacobian row for anchor i is

Ji =

(p − ai)

⊤
∥p − ai∥2

∈ R

1×d
. | (27)

The LM update at iteration k is

∆p = −

J

⊤WJ+λ diag(J

⊤WJ+10⁻⁹
I)

−1
J

⊤Wr, (28)

where W = diag(wi) and λ is the Marquardt damping parameter. λ is divided by 3 on a successful step and multiplied by 3 on failure, bounded in [10⁻⁹
, 10⁹
]. Convergence is
declared when ∥∆p∥ < 10⁻⁶ or after 30 iterations.
The output covariance is the GLS approximation: Σˆ = σˆ

2
(J

⊤WJ)

−1
, where σˆ

2 = σ

2
range = (0.10 m)

2
is the assumed
range noise. This covariance is used as the EKF measurement noise matrix R.
