AdershM-2/UWB_3/RAP Paper/figures/driven_run_2panel.png

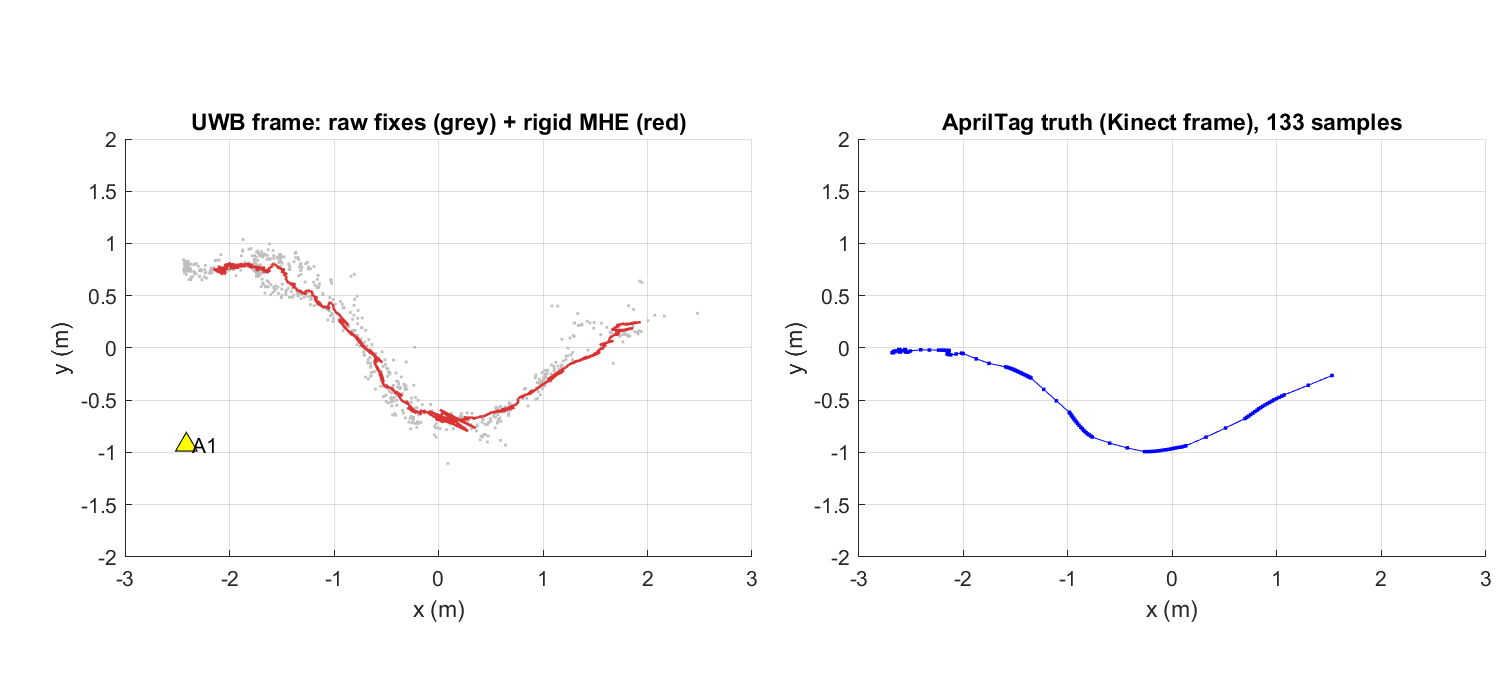
RAP Paper/figures/driven_run_2panel.png
