AdershM-2/UWB_3/RAP Paper/figures/driven_run_top.png

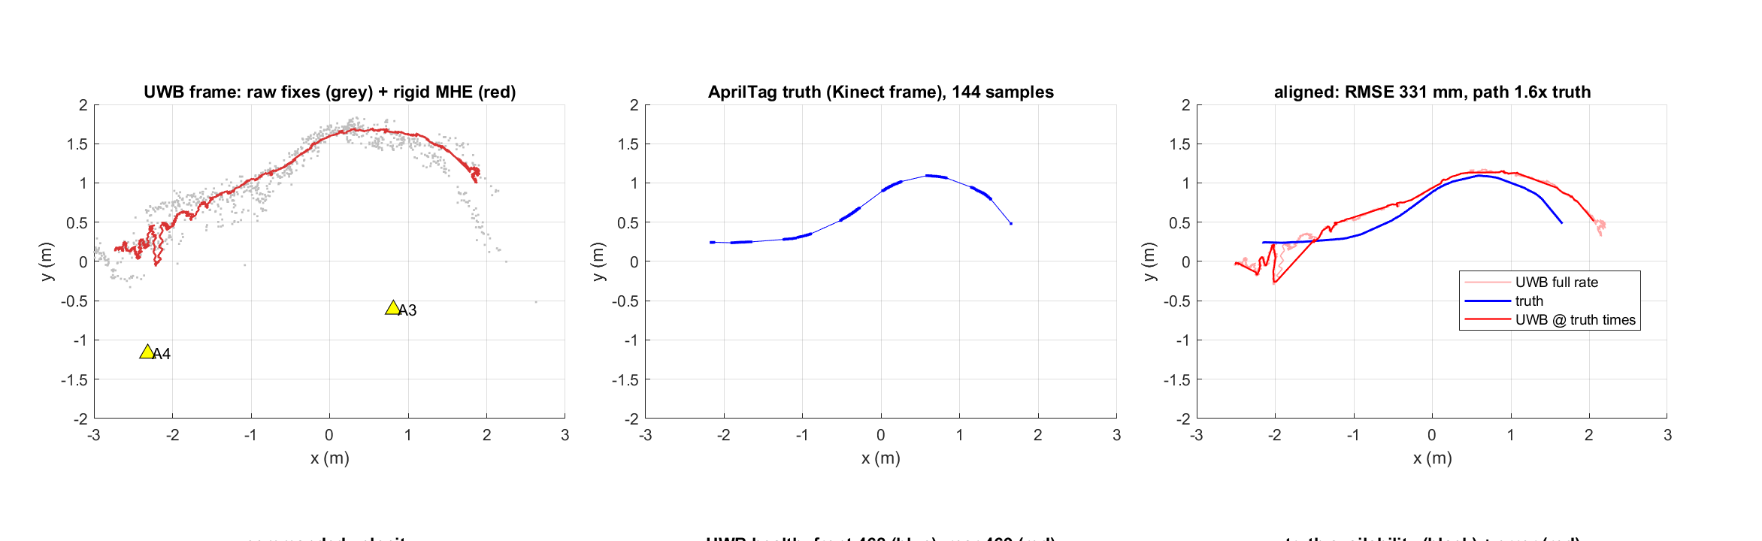
RAP Paper/figures/driven_run_top.png
