AdershM-2/UWB_3/RAP Paper/figures/rover_run_top.png

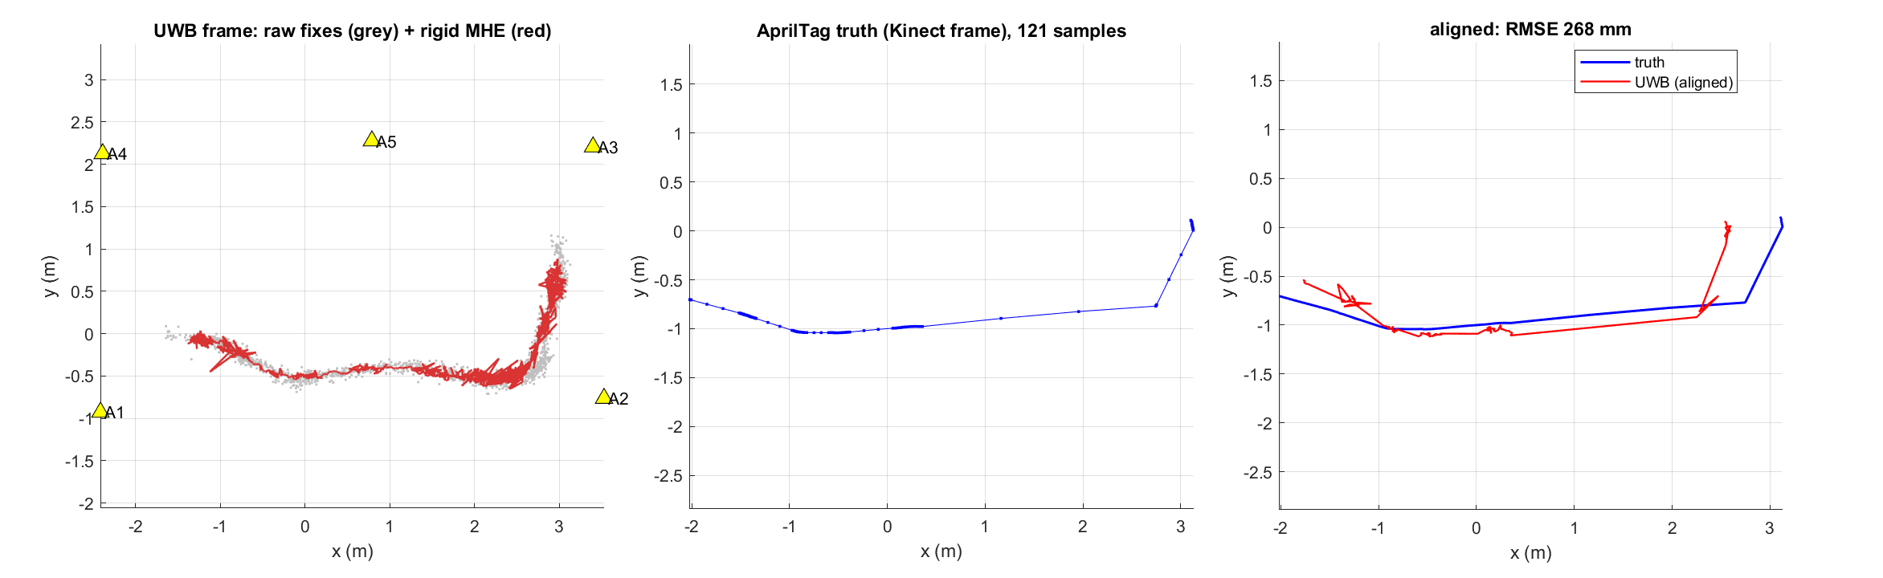
RAP Paper/figures/rover_run_top.png
