AdershM-2/UWB_3/matlab/results/anchor_geometry.png

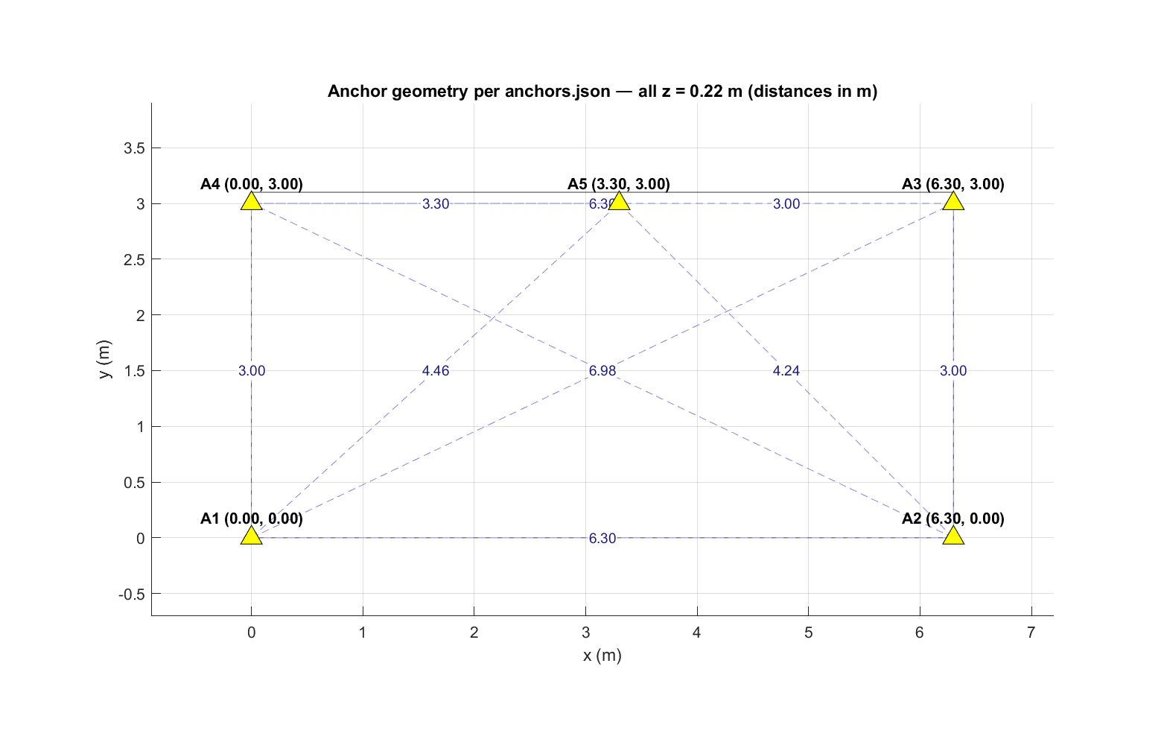
matlab/results/anchor_geometry.png
