AdershM-2/UWB_3/matlab/results/rtls_log_20260702_163114/gap_hist_tag241.png

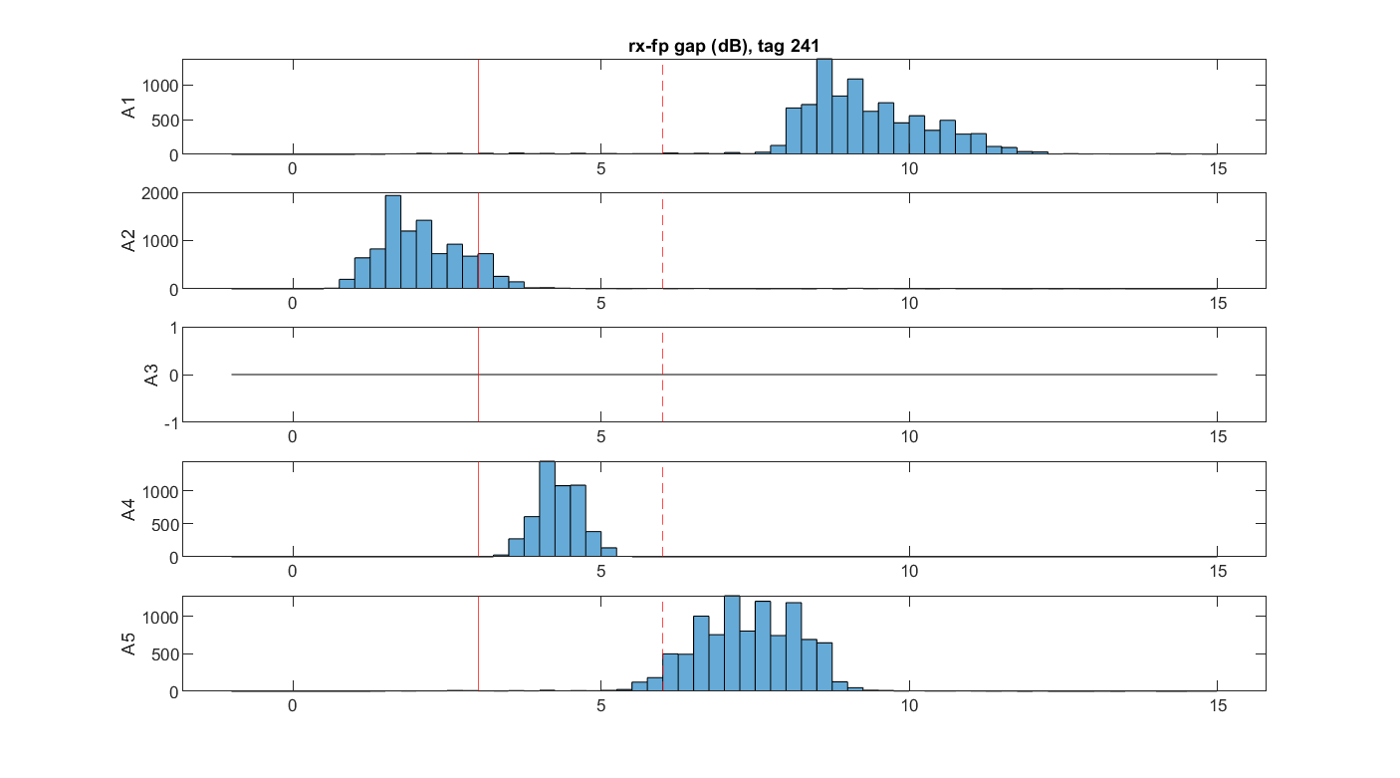
matlab/results/rtls_log_20260702_163114/gap_hist_tag241.png
