AdershM-2/UWB_3/paper/figures/trilateration_geometry.pdf

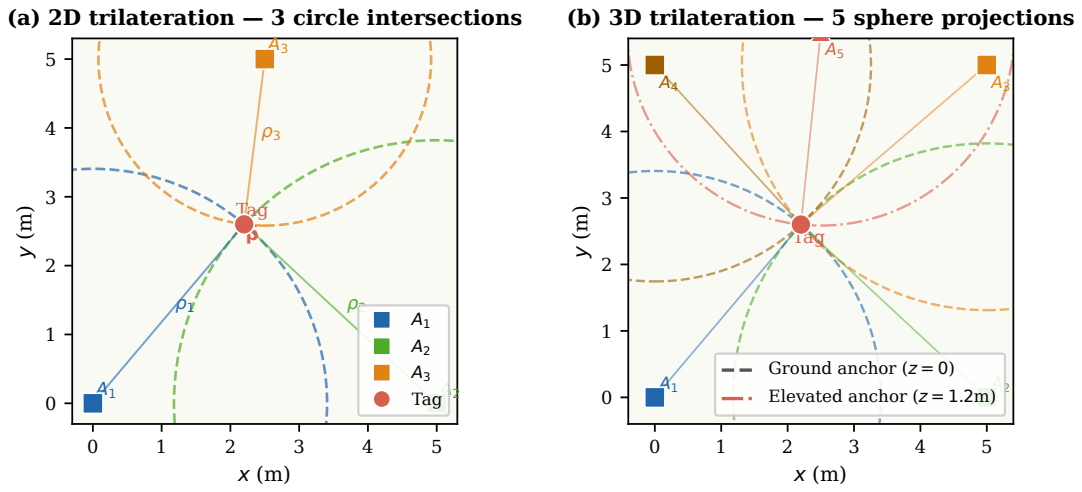
[picture p32: page 1]
Tag p̂; A1 A2 A3 Tag; Tag; Ground anchor (z = 0); Elevated anchor (z = 1.2m)

(a) 2D trilateration — 3 circle intersections

(b) 3D trilateration — 5 sphere projections
