AdershM-2/UWB_3/RAP Paper/figures/anchor_topology.pdf

## Five-anchor two-tag DUNE deployment (isometric view)

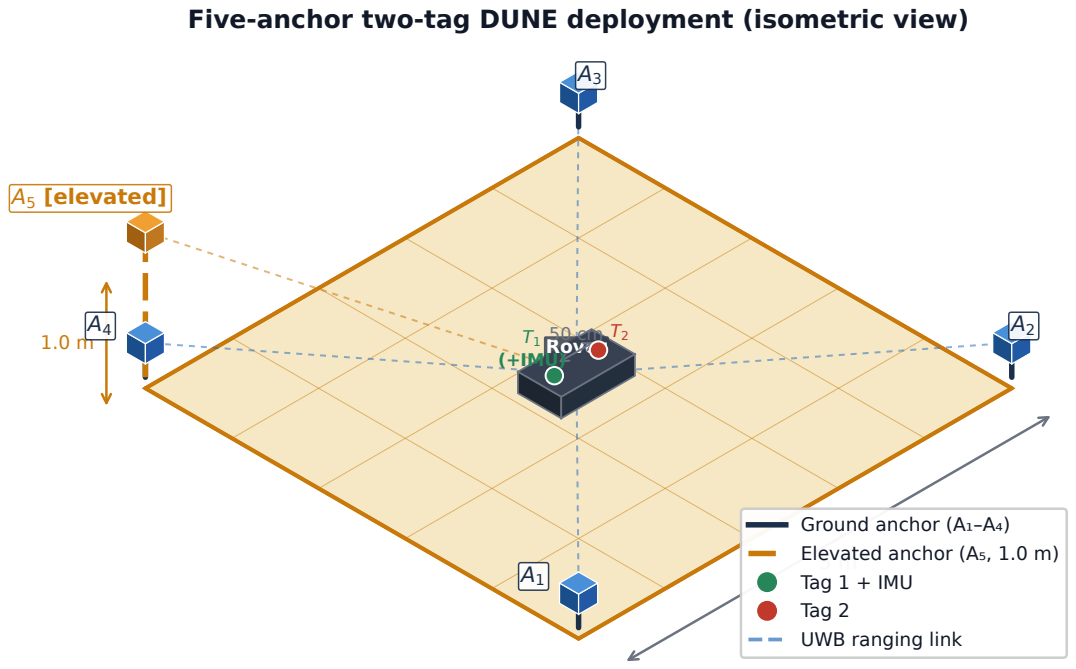
[picture p33: page 1]
A5 [elevated]; Rover T1 50 cm (+IMU)

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
