AdershM-2/UWB_3/paper/figures/nlos_diagram.pdf

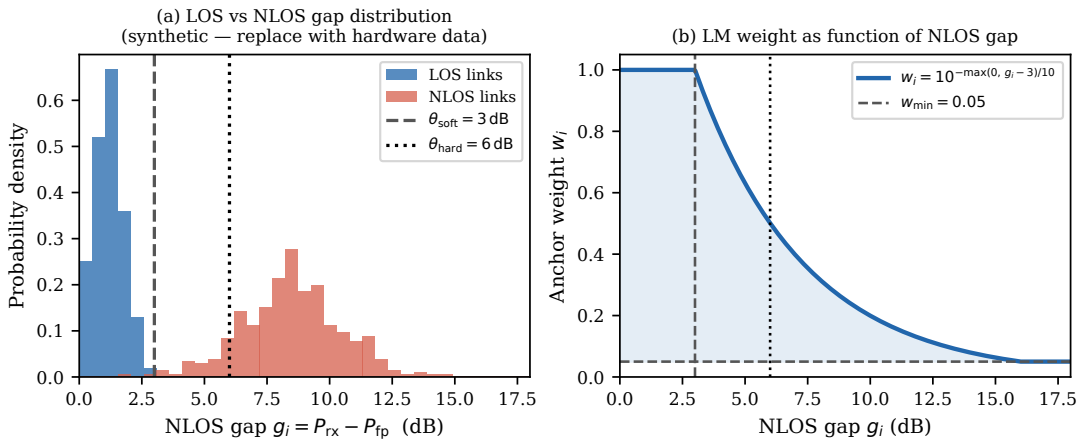
[picture p34: page 1]
Probability density; LOS links NLOS links θsoft = 3 dB θhard = 6 dB; nch; or weig; −max(0, gi − 3)/10; wmin = 0.05

(a) LOS vs NLOS gap distribution
(synthetic — replace with hardware data)

(b) LM weight as function of NLOS gap

NLOS gap gi = Prx − Pfp (dB)

NLOS gap gi (dB)
