AdershM-2/UWB_3/RAP Paper/figures/nlos_concept.pdf

## Non-Line-of-Sight (NLOS): physical mechanism and range bias

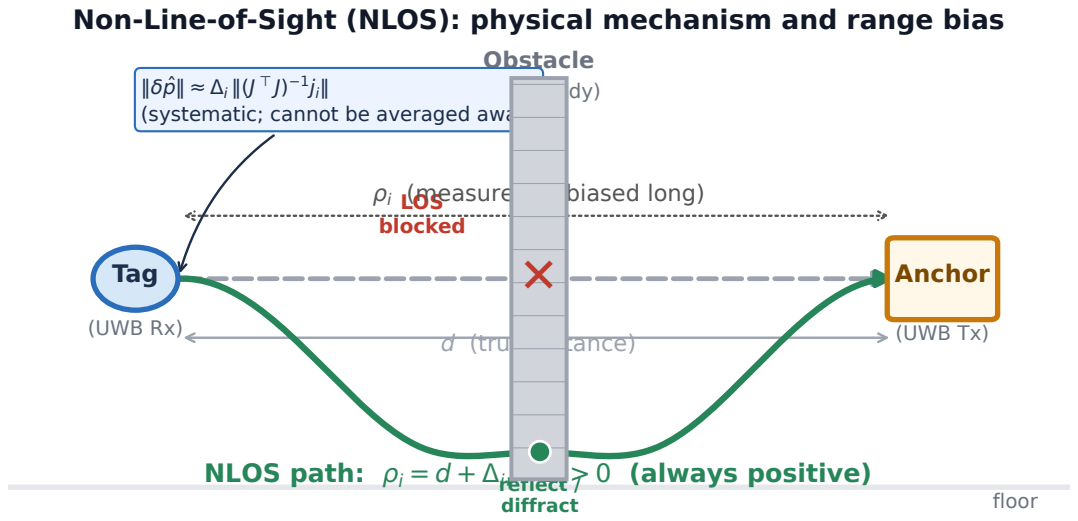
[picture p35: page 1]
floor; Obstacle (wall / body); d (true distance); reflect / diffract; NLOS path: ρi = d + Δi,; Δi > 0 (always positive); Tag; (UWB Rx); Anchor; (UWB Tx)

(systematic; cannot be averaged away)

ρi (measured — biased long)
LOS
blocked
