AdershM-2/UWB_3/sketches/TagWrover/TagWrover.ino

/*
 * TagWrover.ino  –  UWB tag for a generic ESP32-WROVER + DW1000 module
 *                   with external SSD1306 OLED and BNO085 IMU.
 *
 * Peripheral map
 * ──────────────────────────────────────────────────────────────────────
 *  DW1000 (SPI) : SCK=18  MISO=19  MOSI=23  CS=4   RST=27  IRQ=34
 *  SSD1306 OLED : SDA=32  SCL=33   (Wire,  I2C address 0x3C or 0x3D)
 *  BNO085 IMU   : SDA=25  SCL=26   (Wire1, I2C address 0x4A  ← BNO_ADDR)
 *
 *  GPIO 4 = DW1000 CS on this board, so the default OLED SDA=4 conflicts.
 *  OLED moved to 32/33 (Wire). BNO085 on separate bus 25/26 (Wire1).
 *
 * ⚠  GPIO 16/17 are reserved for PSRAM on WROVER modules — do not use them.
 *    BNO085 is wired to 25/26 (BNO_SDA/BNO_SCL below) to avoid that conflict.
 *
 * Required libraries (install via Arduino Library Manager):
 *   – Adafruit BNO08x          (Adafruit)
 *   – Adafruit SSD1306          (Adafruit)
 *   – Adafruit GFX Library      (Adafruit)
 *
 * OLED display layout (128×64, text size 1):
 *   Row 0 (y= 0): "TAG:F0  4/4"        ← tag ID + anchors OK / total
 *   Row 1 (y=16): "R:+12.3  P: -5.6"   ← roll, pitch (degrees)
 *   Row 2 (y=32): "Y:+045.2 deg"        ← yaw (degrees)
 *   Row 3 (y=48): "a:+0.12-0.03+9.81"  ← linear acceleration (m/s²)
 *
 * Serial output (every 200 ms):
 *   [IMU] R:+12.30 P: -5.60 Y:+45.20 deg   Ax:+0.120 Ay:-0.030 Az:+9.810 m/s2
 *
 * The IMU tail (,IMU,status,qw,qx,qy,qz,ax,ay,az,gx,gy,gz) is appended to every
 * RTLS packet when BNO085 is present, making the data available to the Python host.
 */

// ── Transport: pick exactly ONE ───────────────────────────────────────────────
 #define UWB_HOSTLINK_SERIAL
//#define UWB_HOSTLINK_UDP
#define UWB_USE_OLED

// ── Coordination: pick exactly ONE ───────────────────────────────────────────
// RING (default) — the two tags pass a token OVER THE AIR and each streams to
//   the host independently. This is the long-proven WiFi setup.
// WIRE — TagLink: this board becomes MASTER. It owns the ranging schedule,
//   grants the other tag its air slot over a dedicated UART2 cable, and
//   forwards that tag's data to the host on its own link. Exactly one DW1000
//   transmits at a time and the air is never contended.
//
// To switch this board to wired master mode, swap the comment markers on the
// next two lines AND on the transport pair above (WIRE mode is meant to be run
// with UWB_HOSTLINK_SERIAL — one USB cable carries both tags):
//#define UWB_COORD_RING
#define UWB_COORD_WIRE
#define UWB_WIRE_ROLE_MASTER    // this board has the IMU -> it is the master
//
// Wiring for WIRE mode (a shared ground is REQUIRED, not optional):
//   this board GPIO 22 (TX) ──> other board GPIO 35 (RX)
//   this board GPIO 35 (RX) <── other board GPIO 22 (TX)
//   GND <──> GND
#if defined(UWB_COORD_WIRE) && !defined(UWB_WIRE_ROLE_MASTER)
#error "TagWrover is the IMU board: define UWB_WIRE_ROLE_MASTER with UWB_COORD_WIRE"
#endif

// ── Board pin overrides — MUST appear before #include <UwbRtls.h> ────────────
// ESP32 UWB (non-Pro) uses DW1000 CS=4, not 21.
// GPIO 4 is also the default OLED SDA in UwbConfig.h — conflict!
// Both SPI-CS and I2C-SDA cannot share the same pin.
// Fix: keep DW1000 CS=4 (hardware-wired) and move OLED to GPIO 32/33.
// Rewire your OLED: SDA → GPIO 32, SCL → GPIO 33.
#define UWB_PIN_SS    4    // DW1000 chip select (hardware-wired on this board)
#define OLED_PIN_SDA 32    // OLED I2C SDA — moved off GPIO 4 to avoid CS clash
#define OLED_PIN_SCL 33    // OLED I2C SCL

#include <UwbRtls.h>
#include <Wire.h>
#include <Adafruit_BNO08x.h>
#include <Preferences.h>
#include <esp_timer.h>   // monotonic µs clock for the TagLink cycle timing

// ── Configuration — edit these for your setup ─────────────────────────────────
static const uint8_t  TAG_ID        = 0xF0;  // 0xF0 — Tag.ino boards use 0xF1
// Factory default only — an NVS-stored value (from SETMYDELAY / HWCALIB_SELF)
// overrides this at boot, so delay retuning never needs a reflash.
static const uint16_t ANTENNA_DELAY = 16360;  // Tag 1 (0xF0) calibrated (3.0 m ref, 2026-06-18)

static const uint8_t ANCHORS[]  = { 0x01, 0x02, 0x03, 0x04, 0x05 };
static const uint8_t N_ANCHORS  = sizeof(ANCHORS) / sizeof(ANCHORS[0]);

// Multi-tag token ring: ordered list of ALL tag addresses sharing the channel.
// MUST be identical on every tag board (default from UwbConfig.h).
static const uint8_t TAG_RING[] = UWB_TAG_RING_INIT;
static const uint8_t RING_SIZE  = sizeof(TAG_RING) / sizeof(TAG_RING[0]);

#if defined(UWB_HOSTLINK_UDP)
static const char*    WIFI_SSID = "iitk";          // ← fill in
static const char*    WIFI_PASS = "";                    // ← "" for open network
static IPAddress      HOST_IP(255, 255, 255, 255);       // ← Python/MATLAB PC IP
static const uint16_t HOST_PORT  = 4100;
#endif

// BNO085 I2C bus  ── see PSRAM warning above ──────────────────────────────────
#define BNO_SDA   25   // Wire1 SDA — free from OLED and DW1000
#define BNO_SCL   26   // Wire1 SCL
#define BNO_ADDR  0x4A // SA0 LOW (default); use 0x4B if SA0 is tied HIGH

// Survey averaging samples (100 per anchor pair)
static const uint16_t SURVEY_SAMPLES = 100;

// Hardware antenna-delay calibration (GUI-triggered binary search per anchor).
static const uint8_t  CALIB_ITERS    = 14;
static const uint16_t CALIB_SAMPLES  = 50;
static const uint16_t CALIB_DELAY_LO = 15800;
static const uint16_t CALIB_DELAY_HI = 16900;

// ── Objects ───────────────────────────────────────────────────────────────────
TwrEngine    engine;
UwbScheduler scheduler;
HostLink     host;
OledStatus   oled;
Preferences  prefs;

// Coordination — one of the two, chosen by the #define block at the top.
#if defined(UWB_COORD_WIRE)
TagLink      tagLink;   // wired master/slave TDMA over UART2
#else
TagRing      ring;      // over-air token (one tag transmits at a time)
#endif

static uint16_t g_antDelay = ANTENNA_DELAY;  // active own delay (NVS-backed)

Adafruit_BNO08x bno085(-1);    // -1 = MCU does not drive the reset pin
static bool     imuPresent = false;

// Latest IMU readings — updated by pollImu()
static struct {
  float   qw=1, qx=0, qy=0, qz=0;   // rotation vector (unit quaternion)
  float   ax=0, ay=0, az=0;          // linear acceleration, m/s² (gravity removed)
  float   gx=0, gy=0, gz=0;          // calibrated angular velocity, rad/s
  float   roll=0, pitch=0, yaw=0;    // Euler angles, degrees
  uint8_t status = 0;                 // BNO085 accuracy 0–3 (from val.status)
  bool    valid  = false;
} imuData;

// ── IMU helpers ───────────────────────────────────────────────────────────────

static void quatToRPY(float qw, float qx, float qy, float qz,
                      float& roll, float& pitch, float& yaw) {
  // Roll (rotation about X axis)
  float sinr = 2.0f * (qw*qx + qy*qz);
  float cosr = 1.0f - 2.0f * (qx*qx + qy*qy);
  roll = atan2f(sinr, cosr) * 180.0f / (float)PI;

  // Pitch (rotation about Y axis)
  float sinp = 2.0f * (qw*qy - qz*qx);
  pitch = (fabsf(sinp) >= 1.0f) ? copysignf(90.0f, sinp)
                                 : asinf(sinp) * 180.0f / (float)PI;

  // Yaw (rotation about Z axis)
  float siny = 2.0f * (qw*qz + qx*qy);
  float cosy = 1.0f - 2.0f * (qy*qy + qz*qz);
  yaw = atan2f(siny, cosy) * 180.0f / (float)PI;
}

static void setImuReports() {
  // 10 000 µs interval = 100 Hz output rate for all reports.
  bno085.enableReport(SH2_ROTATION_VECTOR,       10000);
  bno085.enableReport(SH2_LINEAR_ACCELERATION,   10000);
  bno085.enableReport(SH2_GYROSCOPE_CALIBRATED,  10000);
}

// Drain the BNO085 FIFO.  Safe to call at any time; no-op if IMU absent.
static void pollImu() {
  if (!imuPresent) return;

  // If the sensor rebooted (e.g. brown-out), re-enable reports.
  if (bno085.wasReset()) {
    Serial.println("[IMU] BNO085 reset detected — re-enabling reports");
    setImuReports();
  }

  sh2_SensorValue_t val;
  while (bno085.getSensorEvent(&val)) {
    switch (val.sensorId) {
      case SH2_ROTATION_VECTOR:
        imuData.qw     = val.un.rotationVector.real;
        imuData.qx     = val.un.rotationVector.i;
        imuData.qy     = val.un.rotationVector.j;
        imuData.qz     = val.un.rotationVector.k;
        imuData.status = val.status;   // 0–3 fusion accuracy from BNO085
        quatToRPY(imuData.qw, imuData.qx, imuData.qy, imuData.qz,
                  imuData.roll, imuData.pitch, imuData.yaw);
        imuData.valid  = true;
        break;
      case SH2_LINEAR_ACCELERATION:
        imuData.ax = val.un.linearAcceleration.x;
        imuData.ay = val.un.linearAcceleration.y;
        imuData.az = val.un.linearAcceleration.z;
        break;
      case SH2_GYROSCOPE_CALIBRATED:
        imuData.gx = val.un.gyroscope.x;
        imuData.gy = val.un.gyroscope.y;
        imuData.gz = val.un.gyroscope.z;
        break;
      default:
        break;
    }
  }
}

// Throttled Serial print (every 200 ms)
static void printImuSerial() {
  static uint32_t lastMs = 0;
  uint32_t now = millis();
  if (now - lastMs < 200) return;
  lastMs = now;

  if (!imuPresent) {
    Serial.println("[IMU] not present");
    return;
  }
  if (!imuData.valid) {
    Serial.println("[IMU] waiting for first sample...");
    return;
  }
  Serial.printf("[IMU] R:%+7.2f  P:%+7.2f  Y:%+7.2f deg    "
                "Ax:%+7.3f  Ay:%+7.3f  Az:%+7.3f m/s2    "
                "Gx:%+6.3f  Gy:%+6.3f  Gz:%+6.3f rad/s  conf=%u\n",
                imuData.roll, imuData.pitch, imuData.yaw,
                imuData.ax,   imuData.ay,   imuData.az,
                imuData.gx,   imuData.gy,   imuData.gz,
                (unsigned)imuData.status);
}

// Update OLED: UWB status on row 0, IMU data on rows 1-3.
// Copy the latest BNO085 reading into the wire-format sample. Shared by both
// cycles so the two code paths can never disagree about what "valid" means.
static void fillImuSample(ImuSample& s) {
  if (!imuPresent || !imuData.valid) return;
  s.valid  = true;
  s.status = imuData.status;
  s.qw = imuData.qw;  s.qx = imuData.qx;
  s.qy = imuData.qy;  s.qz = imuData.qz;
  s.ax = imuData.ax;  s.ay = imuData.ay;  s.az = imuData.az;
  s.gx = imuData.gx;  s.gy = imuData.gy;  s.gz = imuData.gz;
}

static void updateOled(uint8_t nGood) {
  char l0[22], l1[22], l2[22], l3[22];
  snprintf(l0, 22, "TAG:%02X  %u/%u OK", TAG_ID, nGood, N_ANCHORS);
  if (!imuPresent) {
    snprintf(l1, 22, "IMU not found");
    l2[0] = l3[0] = '\0';
  } else if (!imuData.valid) {
    snprintf(l1, 22, "IMU init...");
    l2[0] = l3[0] = '\0';
  } else {
    snprintf(l1, 22, "R:%+6.1f P:%+6.1f",  imuData.roll,  imuData.pitch);
    snprintf(l2, 22, "Y:%+6.1f deg",        imuData.yaw);
    snprintf(l3, 22, "a:%+5.2f%+5.2f%+5.2f",
             imuData.ax, imuData.ay, imuData.az);
  }
  oled.show(l0, l1, l2, l3);
}

// ── Anchor self-survey (same as the standard Tag sketch) ─────────────────────
static void runSurvey() {
  uint8_t pairs = (N_ANCHORS * (N_ANCHORS - 1)) / 2;
  char buf[64];

  snprintf(buf, sizeof(buf), "SURVEY_BEGIN,v1,%u\n", pairs);
  host.sendRaw(buf);
  Serial.printf("Survey: %u anchors, %u pairs, %u samples each\n",
                N_ANCHORS, pairs, SURVEY_SAMPLES);
  char oledStatus[20];
  snprintf(oledStatus, sizeof(oledStatus), "%u pairs, %u samp", pairs, SURVEY_SAMPLES);
  oled.showSplash("SURVEY", "Running...", oledStatus);

  uint8_t pairIdx = 0;
  for (uint8_t i = 0; i < N_ANCHORS; i++) {
    for (uint8_t j = i + 1; j < N_ANCHORS; j++) {
      uint8_t a = ANCHORS[i], b = ANCHORS[j];
      float   sum = 0.0f;
      uint16_t ok = 0;
      pairIdx++;

      char oledL1[20], oledL2[20];
      snprintf(oledL1, sizeof(oledL1), "%u/%u  %02X->%02X", pairIdx, pairs, a, b);
      Serial.printf("  Pair %u/%u  0x%02X -> 0x%02X:\n", pairIdx, pairs, a, b);

      for (uint16_t s = 0; s < SURVEY_SAMPLES; s++) {
        float dist, rxp;
        if (engine.surveyRequest(a, b, dist, rxp)) { sum += dist; ok++; }
        if ((s & 0xF) == 0xF) {
          snprintf(oledL2, sizeof(oledL2), "%u/%u ok=%u", s+1, SURVEY_SAMPLES, ok);
          oled.showSplash("SURVEY", oledL1, oledL2);
          Serial.printf("    [%u/%u ok=%u]\n", s + 1, SURVEY_SAMPLES, ok);
        }
        delay(5);
      }

      if (ok >= SURVEY_SAMPLES / 4) {
        uint32_t mm = (uint32_t)lroundf(sum / ok * 1000.0f);
        snprintf(buf, sizeof(buf), "SURVEY,v1,%u,%u,%lu,%u\n", a, b, mm, ok);
        host.sendRaw(buf);
        Serial.printf("  => %.3f m  (%u/%u ok)\n", sum / ok, ok, SURVEY_SAMPLES);
      } else {
        Serial.printf("  FAILED (ok=%u/%u) — check link 0x%02X<->0x%02X\n",
                      ok, SURVEY_SAMPLES, a, b);
      }
    }
  }
  host.sendRaw("SURVEY_DONE,v1\n");
  Serial.println("Survey complete.");
  oled.showSplash("SURVEY", "DONE", "See host PC");
}

static char g_bootMsg[40];   // reset forensics line, sent once the host link is up

// Bring up the coordination layer. Called from both transport branches of
// setup(), after engine/scheduler are up and imuPresent is known.
static inline void coordBegin() {
#if defined(UWB_COORD_WIRE)
  tagLink.begin(TAG_ROLE_MASTER, TAG_ID, imuPresent ? TAGLINK_CAP_IMU : 0);
#else
  ring.begin(&engine, TAG_ID, TAG_RING, RING_SIZE);
#endif
}

// ── setup ─────────────────────────────────────────────────────────────────────
void setup() {
  Serial.begin(115200);
  delay(300);
  ResetDiag::report(g_bootMsg, sizeof(g_bootMsg));

  // ── OLED first — must precede WiFi (same as Tag.ino line 64) ───────────────
  oled.begin();
  oled.showSplash("TAG WROVER", "Starting...", "BNO085...");

  ChargeMode::begin();
  ChargeMode::checkAndSleep(&oled);   // short GPIO13-14 -> charge mode (deep sleep)

  // Own antenna delay: NVS-calibrated value overrides the sketch constant
  // (SETMYDELAY / HWCALIB_SELF persist here — retuning needs no reflash).
  prefs.begin("uwb", false);
  g_antDelay = prefs.getUShort("tagDelay", ANTENNA_DELAY);
  Serial.printf("[CAL] Tag antenna delay: %u%s\n", g_antDelay,
                g_antDelay == ANTENNA_DELAY ? " (sketch default)" : " (from NVS)");

  // ── BNO085 on Wire1 (pins BNO_SDA, BNO_SCL) ──────────────────────────────
  Wire1.begin(BNO_SDA, BNO_SCL);
  Serial.printf("[IMU] probing BNO085 at 0x%02X on SDA=%d SCL=%d ...\n",
                BNO_ADDR, BNO_SDA, BNO_SCL);

  if (bno085.begin_I2C(BNO_ADDR, &Wire1)) {
    imuPresent = true;
    setImuReports();
    Serial.println("[IMU] BNO085 found and configured");
    oled.showSplash("TAG WROVER", "BNO085 OK", "WiFi...");
  } else {
    imuPresent = false;
    Serial.println("[IMU] BNO085 NOT FOUND — check wiring and BNO_SDA/SCL above.");
    oled.showSplash("TAG WROVER", "IMU MISSING", "Check pins");
    delay(2000);
  }

  // ── WiFi / transport init ────────────────────────────────────────────────
#if defined(UWB_HOSTLINK_UDP)
  host.begin(WIFI_SSID, WIFI_PASS, HOST_IP, HOST_PORT);
  // WiFi association can glitch I2C buses; re-init both afterwards.
  Wire.end();
  delay(50);
  oled.begin();
  if (imuPresent) {
    Wire1.end();
    delay(20);
    Wire1.begin(BNO_SDA, BNO_SCL);
    setImuReports();   // re-enable reports; bus restart may have lost the session
  }
  // ── UWB radio LAST — after WiFi/I2C settled ────────────────────────────────
  // Explicit SPI.begin() here because WiFi + Wire bus teardowns above can leave
  // the ESP32 SPI peripheral in an undefined state on WROVER modules.
  // "DECA 01302001" in Serial → CS=4 correct; all zeros → wrong CS pin.
  SPI.begin(UWB_PIN_SCK, UWB_PIN_MISO, UWB_PIN_MOSI);
  engine.begin(TWR_TAG, TAG_ID, g_antDelay);
  scheduler.begin(&engine, ANCHORS, N_ANCHORS);
  coordBegin();
  engine.printDeviceId();
#else
  host.begin(115200);
  SPI.begin(UWB_PIN_SCK, UWB_PIN_MISO, UWB_PIN_MOSI);
  engine.begin(TWR_TAG, TAG_ID, g_antDelay);
  scheduler.begin(&engine, ANCHORS, N_ANCHORS);
  coordBegin();
  engine.printDeviceId();
#endif
  host.sendRaw(g_bootMsg);   // why did we last reset? (PANIC/WDT/BROWNOUT/...)

  Serial.printf("Tag 0x%02X ready — CS=%d  %u anchors  IMU:%s\n",
                TAG_ID, UWB_PIN_SS, N_ANCHORS, imuPresent ? "YES" : "NO");
  char l2[20];
  snprintf(l2, 20, "%u anch  IMU:%s", N_ANCHORS, imuPresent ? "OK" : "NO");
  oled.showSplash("TAG WROVER", "Ready", l2, "Ranging...");
}

// ── Antenna delay push relay ──────────────────────────────────────────────────
static void handleSetAntDelay(const char* cmd) {
  unsigned int aid = 0, ticks = 0;
  if (sscanf(cmd, "SETANTDELAY,%u,%u", &aid, &ticks) != 2) {
    Serial.println("[CAL] SETANTDELAY parse error — expected SETANTDELAY,<id>,<ticks>");
    return;
  }
  uint8_t  anchorAddr = (uint8_t)aid;
  uint16_t delayTicks = (uint16_t)ticks;
  Serial.printf("[CAL] Pushing delay %u to anchor 0x%02X ...\n", delayTicks, anchorAddr);
  oled.showSplash("CALIBRATE", "Push delay...", "");
  bool ok = engine.pushAntDelay(anchorAddr, delayTicks);
  char buf[48];
  snprintf(buf, sizeof(buf), ok ? "ANTDELAY_ACK,%u,%u\n" : "ANTDELAY_FAIL,%u,%u\n",
           anchorAddr, delayTicks);
  host.sendRaw(buf);
  Serial.printf("[CAL] %s 0x%02X\n", ok ? "ACK from" : "No ACK from", anchorAddr);
}

static void handleHwCalib(const char* cmd) {
  unsigned int aid, trueDistMm;
  if (sscanf(cmd, "HWCALIB,%u,%u", &aid, &trueDistMm) != 2) {
    host.sendRaw("HWCALIB_FAIL,0,parse_error\n");
    return;
  }
  uint8_t anchorAddr = (uint8_t)aid;
  Serial.printf("[HWCAL] Calibrating anchor 0x%02X at true dist %u mm\n",
                anchorAddr, trueDistMm);
  char oledL1[20], oledL2[20];
  snprintf(oledL1, sizeof(oledL1), "Anch 0x%02X", anchorAddr);
  oled.showSplash("HW CALIB", oledL1, "Searching...");

  uint16_t low = CALIB_DELAY_LO, high = CALIB_DELAY_HI;
  for (uint8_t it = 0; it < CALIB_ITERS; it++) {
    uint16_t mid = (low + high) / 2;
    if (!engine.pushAntDelay(anchorAddr, mid, 1)) {
      char buf[48];
      snprintf(buf, sizeof(buf), "HWCALIB_FAIL,%u,push_timeout\n", aid);
      host.sendRaw(buf);
      return;
    }
    float sum = 0.0f; uint16_t ok = 0;
    for (uint16_t s = 0; s < CALIB_SAMPLES; s++) {
      float dist, rxp;
      if (engine.rangeTo(anchorAddr, dist, rxp)) { sum += dist; ok++; }
      delay(5);
    }
    if (ok < CALIB_SAMPLES / 4) {
      char buf[48];
      snprintf(buf, sizeof(buf), "HWCALIB_FAIL,%u,no_range\n", aid);
      host.sendRaw(buf);
      return;
    }
    float meanMm = (sum / ok) * 1000.0f;
    int32_t errMm = (int32_t)(meanMm - (float)trueDistMm);
    char buf[64];
    snprintf(buf, sizeof(buf), "HWCALIB_PROG,%u,%u,%u,%u,%ld\n",
             aid, it, mid, (uint32_t)meanMm, (long)errMm);
    host.sendRaw(buf);
    Serial.printf("  [%2u/%u] delay=%u  mean=%u mm  err=%+ld mm\n",
                  (unsigned)(it + 1), (unsigned)CALIB_ITERS,
                  mid, (uint32_t)meanMm, (long)errMm);
    if ((it & 6) == 6) {
      snprintf(oledL2, sizeof(oledL2), "it%u d=%u", it + 1, mid);
      oled.showSplash("HW CALIB", oledL1, oledL2);
    }
    if (meanMm > (float)trueDistMm) low = mid; else high = mid;
  }
  uint16_t finalDelay = (low + high) / 2;
  bool pushOk = engine.pushAntDelay(anchorAddr, finalDelay, 3);
  char buf[48];
  snprintf(buf, sizeof(buf), pushOk ? "HWCALIB_DONE,%u,%u\n"
                                    : "HWCALIB_FAIL,%u,final_push\n",
           aid, finalDelay);
  host.sendRaw(buf);
  Serial.printf("[HWCAL] Anchor 0x%02X: %s  delay=%u\n",
                anchorAddr, pushOk ? "DONE" : "FAIL", finalDelay);
  snprintf(oledL2, sizeof(oledL2), "d=%u %s", finalDelay, pushOk ? "OK" : "FAIL");
  oled.showSplash("HW CALIB", oledL1, oledL2);
}

// ── Own antenna-delay control (tag-side twin of the anchor NVS flow) ─────────
static void applyMyDelay(uint16_t ticks) {
  engine.setAntennaDelay(ticks);    // applies configure() + startRx()
  g_antDelay = ticks;
  prefs.putUShort("tagDelay", ticks);
}

// All own-delay commands carry the target TAG_ID as the first field so a UDP
// broadcast is safe with several tags powered — non-addressees stay silent.
static void handleSetMyDelay(const char* cmd) {
  unsigned int tid = 0, ticks = 0;
  if (sscanf(cmd, "SETMYDELAY,%u,%u", &tid, &ticks) != 2) {
    host.sendRaw("MYDELAY_FAIL,parse_error\n");
    return;
  }
  if ((uint8_t)tid != TAG_ID) return;   // addressed to another tag
  applyMyDelay((uint16_t)ticks);
  char buf[48];
  snprintf(buf, sizeof(buf), "MYDELAY_ACK,%u,%u\n", TAG_ID, ticks);
  host.sendRaw(buf);
  Serial.printf("[CAL] Own antenna delay set: %u (NVS saved)\n", ticks);
}

static void handleGetMyDelay(const char* cmd) {
  unsigned int tid = 0;
  if (sscanf(cmd, "GETMYDELAY,%u", &tid) != 1) return;
  if ((uint8_t)tid != TAG_ID && tid != 0) return;   // 0 = query all tags
  char buf[48];
  snprintf(buf, sizeof(buf), "MYDELAY_ACK,%u,%u\n", TAG_ID, g_antDelay);
  host.sendRaw(buf);
}

// Binary-search OUR OWN antenna delay against one already-calibrated anchor at
// a tape-measured distance. Mirrors handleHwCalib but adjusts this tag instead
// of pushing to the anchor — per-tag bias must not be absorbed into anchor NVS
// (shared anchors serve every tag in the fleet).
static void handleHwCalibSelf(const char* cmd) {
  unsigned int tid, aid, trueDistMm;
  if (sscanf(cmd, "HWCALIB_SELF,%u,%u,%u", &tid, &aid, &trueDistMm) != 3) {
    host.sendRaw("HWCALIB_SELF_FAIL,0,parse_error\n");
    return;
  }
  if ((uint8_t)tid != TAG_ID) return;   // addressed to another tag
  uint8_t anchorAddr = (uint8_t)aid;
  Serial.printf("[HWCAL-SELF] Calibrating own delay vs anchor 0x%02X at %u mm\n",
                anchorAddr, trueDistMm);
  char oledL1[20], oledL2[20];
  snprintf(oledL1, sizeof(oledL1), "Self vs %02X", anchorAddr);
  oled.showSplash("SELF CALIB", oledL1, "Searching...");

  uint16_t low = CALIB_DELAY_LO, high = CALIB_DELAY_HI;
  for (uint8_t it = 0; it < CALIB_ITERS; it++) {
    uint16_t mid = (low + high) / 2;
    engine.setAntennaDelay(mid);              // adjust OURSELVES, not the anchor
    float sum = 0.0f; uint16_t ok = 0;
    for (uint16_t s = 0; s < CALIB_SAMPLES; s++) {
      float dist, rxp;
      if (engine.rangeTo(anchorAddr, dist, rxp)) { sum += dist; ok++; }
      delay(5);
    }
    if (ok < CALIB_SAMPLES / 4) {
      engine.setAntennaDelay(g_antDelay);     // restore last good value
      char buf[48];
      snprintf(buf, sizeof(buf), "HWCALIB_SELF_FAIL,%u,no_range\n", aid);
      host.sendRaw(buf);
      return;
    }
    float meanMm = (sum / ok) * 1000.0f;
    int32_t errMm = (int32_t)(meanMm - (float)trueDistMm);
    char buf[64];
    snprintf(buf, sizeof(buf), "HWCALIB_SELF_PROG,%u,%u,%u,%u,%ld\n",
             aid, it, mid, (uint32_t)meanMm, (long)errMm);
    host.sendRaw(buf);
    Serial.printf("  [%2u/%u] delay=%u  mean=%u mm  err=%+ld mm\n",
                  (unsigned)(it + 1), (unsigned)CALIB_ITERS,
                  mid, (uint32_t)meanMm, (long)errMm);
    if ((it & 6) == 6) {
      snprintf(oledL2, sizeof(oledL2), "it%u d=%u", it + 1, mid);
      oled.showSplash("SELF CALIB", oledL1, oledL2);
    }
    if (meanMm > (float)trueDistMm) low = mid; else high = mid;
  }
  uint16_t finalDelay = (low + high) / 2;
  applyMyDelay(finalDelay);                    // apply + persist to NVS
  char buf[48];
  snprintf(buf, sizeof(buf), "HWCALIB_SELF_DONE,%u,%u\n", TAG_ID, finalDelay);
  host.sendRaw(buf);
  Serial.printf("[HWCAL-SELF] DONE  own delay=%u (NVS saved)\n", finalDelay);
  snprintf(oledL2, sizeof(oledL2), "d=%u OK", finalDelay);
  oled.showSplash("SELF CALIB", oledL1, oledL2);
}

// ── CIR capture (diagnostics) ────────────────────────────────────────────────
// CIR,<anchorId> → one TWR exchange with that anchor, then stream the
// accumulator (channel impulse response) of the final RANGE_REPORT frame:
//   CIRHDR,<aid>,<fpIndexRaw>,<nTaps>,<dist_mm>     (fpIndexRaw is 10.6 fixed)
//   CIRD,<aid>,<seg>,<hex...>                        (32 taps = 128 B per line)
//   CIREND,<aid>
static void handleCirCapture(const char* cmd) {
  unsigned int aid = 0;
  if (sscanf(cmd, "CIR,%u", &aid) != 1) {
    host.sendRaw("CIR_FAIL,0,parse_error\n");
    return;
  }
  static const uint16_t NTAPS = 1016;      // 64 MHz PRF accumulator length
  static byte cir[NTAPS * 4];
  float dist = 0.0f, rxp = 0.0f;
  uint16_t fpIdx = 0;
  if (!engine.captureCir((uint8_t)aid, dist, rxp, fpIdx, cir, NTAPS)) {
    char buf[32];
    snprintf(buf, sizeof(buf), "CIR_FAIL,%u,no_range\n", aid);
    host.sendRaw(buf);
    return;
  }
  char hdr[64];
  snprintf(hdr, sizeof(hdr), "CIRHDR,%u,%u,%u,%ld\n",
           aid, fpIdx, NTAPS, (long)(dist * 1000.0f));
  host.sendRaw(hdr);
  static char line[16 + 256 + 2];
  for (uint16_t seg = 0; (uint32_t)seg * 32 < NTAPS; seg++) {
    uint16_t t0 = seg * 32;
    uint16_t nT = (uint16_t)((NTAPS - t0 < 32) ? (NTAPS - t0) : 32);
    int off = snprintf(line, sizeof(line), "CIRD,%u,%u,", aid, seg);
    for (uint16_t b = 0; b < nT * 4; b++)
      off += snprintf(line + off, sizeof(line) - (size_t)off, "%02X",
                      cir[(uint32_t)t0 * 4 + b]);
    line[off++] = '\n';
    line[off] = '\0';
    host.sendRaw(line);
    delay(2);                              // let the serial buffer drain
  }
  char tail[24];
  snprintf(tail, sizeof(tail), "CIREND,%u\n", aid);
  host.sendRaw(tail);
}

static void dispatchCmd(const char* cmd) {
  if (strcmp(cmd, "SURVEY") == 0)
    runSurvey();
  else if (strncmp(cmd, "SETANTDELAY,", 12) == 0)
    handleSetAntDelay(cmd);
  else if (strncmp(cmd, "HWCALIB_SELF,", 13) == 0)
    handleHwCalibSelf(cmd);
  else if (strncmp(cmd, "HWCALIB,", 8) == 0)
    handleHwCalib(cmd);
  else if (strncmp(cmd, "SETMYDELAY,", 11) == 0)
    handleSetMyDelay(cmd);
  else if (strncmp(cmd, "GETMYDELAY,", 11) == 0)
    handleGetMyDelay(cmd);
  else if (strncmp(cmd, "CIR,", 4) == 0)
    handleCirCapture(cmd);
}

// ── loop ──────────────────────────────────────────────────────────────────────
// Both cycle bodies are defined below; declare them so loop() can sit first.
#if defined(UWB_COORD_WIRE)
static void masterCycle();
#else
static void ringCycle();
#endif

void loop() {
  ChargeMode::checkAndSleep(&oled);   // jumper 13-14 enters charge mode at any time

  // ── UDP command check (calibration tool sends SETANTDELAY here) ───────────
  static char udpCmd[32];
  if (host.receiveCmd(udpCmd, sizeof(udpCmd)) > 0)
    dispatchCmd(udpCmd);

  // ── Serial command check (SURVEY trigger, debug) ──────────────────────────
  static char    cmdBuf[32];
  static uint8_t cmdLen = 0;
  while (Serial.available()) {
    char c = (char)Serial.read();
    if (c == '\n' || c == '\r') {
      cmdBuf[cmdLen] = '\0';
      dispatchCmd(cmdBuf);
      cmdLen = 0;
    } else if (cmdLen < sizeof(cmdBuf) - 1) {
      cmdBuf[cmdLen++] = c;
    }
  }

#if defined(UWB_COORD_WIRE)
  tagLink.poll();
  masterCycle();
#else
  ringCycle();
#endif
}

// ── RING cycle (over-air token) ───────────────────────────────────────────────
// Unchanged behaviour: sweep only on our turn, stream, hand the token on.
#if !defined(UWB_COORD_WIRE)
static void ringCycle() {
  static uint8_t nGood = 0;

  pollImu();
  const bool myTurn = ring.poll();
  if (myTurn) nGood = scheduler.sweep();
  pollImu();   // more BNO085 data accumulated during the ranging wait

  if (myTurn) {
    ImuSample imuSamp;
    fillImuSample(imuSamp);
    // Phase-C wobble diagnostics: DW1000 die temperature + Vbat once per
    // sweep (SAR ADC; engine idles the radio for the read, then re-arms).
    float dieTempC = NAN, vbatV = NAN;
    engine.readTempVbat(dieTempC, vbatV);
    host.sendSweep(millis(), TAG_ID, scheduler,
                   imuSamp.valid ? &imuSamp : nullptr, dieTempC, vbatV);
    ring.handoff();
  }

  printImuSerial();
  static uint32_t oledLast = 0;
  if (millis() - oledLast > 500) { oledLast = millis(); updateOled(nGood); }
}
#endif

// ── MASTER cycle (TagLink) ────────────────────────────────────────────────────
// The slave's slot is NOT wait time: GO is issued the moment our own sweep ends,
// and everything below grantSlot (IMU, format, host send, OLED) runs while the
// slave is sweeping. waitDone() then blocks only for whatever budget is left,
// polling the IMU as idle work.
#if defined(UWB_COORD_WIRE)
static void masterCycle() {
  static float   rateHz = 0.0f;
  static uint8_t nGood  = 0;

  int64_t  cycleStartUs = esp_timer_get_time();
  uint16_t cycle = tagLink.startCycle();

  // 1) Our own sweep, then free the air.
  int64_t t0 = esp_timer_get_time();
  nGood = scheduler.sweep();
  uint32_t ownSweepUs = (uint32_t)(esp_timer_get_time() - t0);
  float dieTempC = NAN, vbatV = NAN;
  engine.readTempVbat(dieTempC, vbatV);   // idles + re-arms the radio internally
  engine.setRadioState(RADIO_IDLE);

  // 2) Grant the slave its slot FIRST — its sweep now overlaps our work.
  bool granted = false;
  if (tagLink.slavePresent()) { tagLink.grantSlot(); granted = true; }

  // 3) Master's own processing, concurrent with the slave's sweep.
  int64_t procT0 = esp_timer_get_time();
  pollImu();
  ImuSample imuSamp;
  fillImuSample(imuSamp);

  char line[768];
  int len = HostLink::format(line, sizeof(line), millis(), TAG_ID, scheduler,
                             imuSamp.valid ? &imuSamp : nullptr, dieTempC, vbatV);
  if (len > 0) {
    len = HostLink::appendTail(line, sizeof(line), len, ",CYC,%u", cycle);
    host.sendLine(line, len);
  }

  printImuSerial();
  static uint32_t oledLast = 0;
  if (millis() - oledLast > 500) { oledLast = millis(); updateOled(nGood); }
  uint32_t procUs = (uint32_t)(esp_timer_get_time() - procT0);

  // 4) Collect the slave's slot (IMU keeps draining as idle work).
  uint32_t slaveSweepUs = 0;
  if (granted) {
    tagLink.waitDone(pollImu);
    if (tagLink.hasData()) {
      slaveSweepUs = tagLink.dataSweepUs();
      int slen = HostLink::format(line, sizeof(line), tagLink.dataTagMs(),
                                  tagLink.dataTagId(), tagLink.dataRanges(),
                                  tagLink.dataCount());
      if (slen > 0) {
        slen = HostLink::appendTail(line, sizeof(line), slen, ",CYC,%u,MRX,%llu",
                                    cycle, (unsigned long long)tagLink.dataRxTimeUs());
        host.sendLine(line, slen);
      }
    }
  }
  engine.setRadioState(RADIO_ACTIVE);   // take the air back for the next sweep

  // 5) Per-cycle time budget — the "where does the time go" input.
  //    DIAG,v1,<cycle>,<cycle_start_us>,<master_sweep_us>,<slave_sweep_us>,
  //            <uart_wait_us>,<proc_us>,<idle_us>,<total_us>
  uint32_t uartWaitUs = granted ? tagLink.lastUartWaitUs() : 0;
  uint32_t totalUs    = (uint32_t)(esp_timer_get_time() - cycleStartUs);
  uint32_t accounted  = ownSweepUs + procUs + uartWaitUs;
  uint32_t idleUs     = (totalUs > accounted) ? (totalUs - accounted) : 0;
  char diag[128];
  int dlen = snprintf(diag, sizeof(diag),
                      "DIAG,v1,%u,%lld,%lu,%lu,%lu,%lu,%lu,%lu\n",
                      cycle, (long long)cycleStartUs,
                      (unsigned long)ownSweepUs, (unsigned long)slaveSweepUs,
                      (unsigned long)uartWaitUs, (unsigned long)procUs,
                      (unsigned long)idleUs, (unsigned long)totalUs);
  if (dlen > 0 && dlen < (int)sizeof(diag)) host.sendLine(diag, dlen);

  if (totalUs > 0) {
    float hz = 1e6f / (float)totalUs;
    rateHz = (rateHz == 0.0f) ? hz : rateHz + 0.2f * (hz - rateHz);
  }

  // Rate-limited human-readable summary (+ link health: crc spike = bad cable).
  static uint32_t timeLast = 0;
  if (millis() - timeLast > 2000) {
    timeLast = millis();
    const TagLinkStats& s = tagLink.stats();
    Serial.printf("[TIME] cycle=%u own=%.1fms slave=%.1fms uart=%.1fms proc=%.1fms"
                  " total=%.1fms rate=%.1fHz | crc=%lu resync=%lu stale=%lu"
                  " gap=%lu dup=%lu tmo=%lu\n",
                  cycle, ownSweepUs / 1e3f, slaveSweepUs / 1e3f, uartWaitUs / 1e3f,
                  procUs / 1e3f, totalUs / 1e3f, rateHz,
                  (unsigned long)s.crcErr, (unsigned long)s.resync,
                  (unsigned long)s.staleCycle, (unsigned long)s.seqGap,
                  (unsigned long)s.seqDup, (unsigned long)s.slotTimeout);
  }
}
#endif
