AdershM-2/UWB_3/(commit log)

2026-07-18 Initial commit: DUNE UWB localisation project snapshot (2026-07-18)
    Dual-tag UWB RTLS on ESP32/DW1000 with a MATLAB host pipeline.
    matlab/ MATLAB host pipeline (+dune package, calibration scripts,
    config JSONs, replay results) — the active pipeline
    matlab/vision/ Kinect v2 / AprilTag ground-truth tooling
    sketches/ ESP32 + DW1000 firmware (Anchor, Tag, TagWrover,
    AntennaCalibration)
    paper/ IEEE manuscript (sections drafted; Results pending hardware)
    docs/ design + plan notes
    Not yet included: the UwbRtls Arduino library (the firmware's core protocol
    dependency) lives outside this folder in the Arduino librarie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
    [siunitx-abbreviations.cfg]
2026-07-18 Vendor UwbRtls firmware library into the repo (libraries/UwbRtls)
    The DW1000 RTLS protocol library (TwrEngine, UwbScheduler, TagRing, HostLink,
    UwbFrame + the vendored DW1000 driver) previously lived only in the Arduino
    libraries path, outside version control. Copied it in under libraries/ so the
    repo is self-contained: point the Arduino IDE's sketchbook at d:\UWB_3 (or add
    libraries/ to the library path) and the sketches in sketches/ build as-is.
    Note: sketches/ holds the working board copies; libraries/UwbRtls/examples/
    holds the library's shipped examples — these may have diverged and are not yet
    reconciled.
2026-07-18 Consolidate overhead-camera calibration toolchain into matlab/vision
    Copied the 2026-07-09 camera-calibration toolchain from D:\UWB_modules_new\matlab\vision
    into this repo's matlab/vision/ (estimateCameraHeight, calibrateOverheadCamera, auditFloorScale,
    registerWorldFrameClicks, undistortPts/distortPts, clickTagTruth, visionSystemConfig + the
    camcal-aware versions of registerWorldFrame/transformPoseToWorld, plus calibration_data/).
    Removed the old partial core/ + analysis/ subfolders (superseded; recoverable via git);
    kept getAprilTagPose. Run camera calibration from matlab/vision now (calibration_data is
    relative to the scripts).
    Also expanded rebuild_plan.md step 2 into sub-steps 2.1-2.6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
    [apriltag_minsize_2026-07-08_05-26-04.csv, apriltag_minsize_2026-07-08_05-31-35.csv]
2026-07-20 Step 2 complete: Kinect overhead camera calibrated and world-registered
    - Camera: h=4.066 m, f=1067.6 px, negligible distortion; Stage-B floor
    homography anchored to the tape scale bars (addScaleBars.m).
    - World frame registered to the plywood-corner layout
    (world_registration.mat, RMSE 13.5 mm) - Kinect is now the
    click-to-world ground-truth reference.
    - anchors.json set to the real 2.387x1.194 m layout, z=0.24, a5 centre.
    - New tools: measureAnchorsFromCamera.m, uwb3vision.m, handoff doc.
2026-07-20 Step 3: live MATLAB UWB pipeline (COM ingest -> weighted multilateration)
    - dune.solveSweep: single solve path for live + replay (sentinel reject,
    optional host-bias toggle default OFF, NLOS gap weights, warm-started LM).
    Protocol-agnostic sweep structs for the future broadcast-POLL A/B test.
    - dune.TagSerial: serialport line ingest + calibration command send + raw tee.
    - dune.sweepRecord: JSONL logging in the readSessionLog schema (replayable).
    - scripts/live_tag: live floor map + trail + rate/residual readout, logging.
    - scripts/replay_rtls: rebuilds RTLS lines from old JSONL logs and runs the
    exact live chain offline (validated on 2026-06/07 sessions, 0 parse fails).
    - scripts/ancho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
2026-07-20 Step 4 (delay calibration): sweep-path tuning hits 4 mm position error
    - scripts/calibrate_delays.m: HWCALIB driver (Kinect click-truth ->
    on-device binary search per anchor) with before/after proof + JSON report.
    Finding: HWCALIB burst ranging and production ring-sweep ranging disagree
    by a CONSTANT per-anchor offset (+60..+500 mm) despite calling the same
    rangeTo() - burst-calibrated delays leave the sweep path biased.
    Documented in config/delay_calibration.json; firmware investigation TBD.
    - scripts/tune_delays_sweep.m: the fix - feedback tuning on the SWEEP path
    (measure sweep medians vs truth -> SETANTDELAY ticks -> repeat).
    Converged in 2 iterations: all anchors within +/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
2026-07-20 Step 5 baseline: multi-spot static accuracy harness + first campaign
    - scripts/static_accuracy.m: per-spot loop (park -> Kinect click-truth ->
    20 s live sweeps -> full-path solve), per-spot + overall stats, floor map,
    spots.json; per-anchor range-error medians as Tier-2 seed data.
    - Campaign 2026-07-20 (5 spots + calibration point, 809 sweeps): overall
    static 2D RMSE 121 mm (goal <=30). Errors are per-spot constants
    (scatter ~30 mm) - a smooth field, not noise. Analysis: range error vs
    rx power correlates +0.78 pooled / up to +0.98 per anchor (~7-14 mm/dB,
    DW1000 APS011 signal-level bias). Per-anchor linear rx correction
    (offline eval): RMSE 119 -> 75 mm; LOSO says ~45 mm unexp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
2026-07-20 Tier-2 range correction: per-anchor power-bias model wired into the pipeline
    - 19-spot Kinect-truth campaign (static_accuracy_20260720_195637,
    ~7.6k usable sweeps). Model bake-off with leave-one-spot-out CV:
    per-anchor linear in FIRST-PATH power wins (range-level median residual
    34 mm vs 75 raw); gap hard-drop and rx smoothing added nothing; oracle
    ceiling 72 mm RMSE (per-sweep noise tails -> step-7 filtering territory).
    - config/range_correction.json: corr_mm = slope*fp_dBm + intercept per
    anchor (slopes 7.7-9.5 mm/dB), fp clamped to fitted window.
    - dune.loadRangeCorrection + solveSweep opts.rangeCorr apply it;
    live_tag / static_accuracy auto-load it (powerCorr=false to disable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
2026-07-20 Update rebuild plan: steps 1-5 done, step 7 next, step 6 deferred
    - Record 2026-07-20 results (delay calibration, Tier-2 power correction,
    static campaign numbers, burst-vs-sweep anomaly).
    - Backlog: refit power-bias model as a PINN on the saved 19-spot dataset.
    - Step 7 broken into 7.1-7.5 (tag-241 tuning, EKF port, IMU + dual-tag yaw,
    Kinect moving-truth recorder, moving validation).
2026-07-20 Step 7.1+7.2: tag-delay tuner and FusionEKF port with offline validation
    - scripts/tune_tag_delay.m (7.1): SETMYDELAY sweep-path feedback tuning for
    a second tag (241) against clicked Kinect truth; corrects the common
    across-anchor offset only, never touches anchor delays; writes
    config/delay_tuning_tag<id>.json. Awaits hardware run.
    - +dune/FusionEkf.m (7.2): port of python fusion_ekf.py. 6-state
    [p v accel-bias], IMU-driven or CV predict, chi2-gated position + ZUPT
    updates, divergence recovery (reinit after 10 consecutive rejections).
    - scripts/ekf_replay.m: offline driver for raw serial logs and live JSONL
    logs; static-spot evaluation vs Kinect truth.
    - Campaign validation (19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
2026-07-20 Tag 241 calibrated + EKF scrutiny round 1 (adaptive R, tightly-coupled mode)
    - Tag 241 own delay tuned on hardware via tune_tag_delay: 16473 -> 16365
    ticks, common offset -507 -> -2 mm in one step; parked position error
    48 mm at an arbitrary spot (= field accuracy; anchors untouched).
    Provenance: config/delay_tuning_tag241.json. Both tags now calibrated.
    - FusionEkf hardening: Joseph-form covariance update, nonlinear-innovation
    support in update(), tightly-coupled updateRanges() (sequential chi2(1)-
    gated per-range updates), CV-mode freeze of the unobservable accel-bias
    random walk, reinitFrom() for driver-level recovery.
    - ekf_replay: mode=pos|ranges, adaptive measurement covari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
2026-07-20 Wire FusionEkf into live_tag; PINN experiment verdict recorded
    - live_tag: EKF smoothing on by default (CV predict + adaptive-R gated
    position update + windowed ZUPT from the IMU tail; ekf=false to disable).
    Smoothed dot + trail, raw fix as grey ghost; EKF track logged as ex/ey
    (readSessionLog-compatible). Divergence recovery via reinit.
    - sweepRecord: optional EKF position -> ex/ey fields.
    - PINN experiment (19-spot LOSO, 31.5k samples, DL toolbox): small MLP on
    [fp, gap, anchor] with APS011 monotonicity penalty does NOT beat the
    per-anchor linear-fp model (position RMSE: linear 98, MLP 107, PINN 108;
    range-level ~equal). The fp-bias relation is linear over -110..-75 dBm;
    the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
2026-07-20 EKF stillMode: freeze process noise when stillness is detected
    Root cause of persistent parked wobble: ZUPT clamps velocity but the CV
    process noise (~30 mm/step at sigma=0.8, dt~0.17) kept re-opening the
    position gain, so the dot kept following measurement noise. stillMode
    (set by drivers from IMU windowed stillness, or filter-inferred stillness
    for no-IMU tags) caps sigma_accel at 0.05 -> the state truly pins while
    parked and releases as soon as the stillness condition breaks.
    live_tag: stillness computed before predict; no-IMU stillness counter
    maintained after update. tagZ default 0.24 (matches truth clicks).
    Campaign metric unchanged (bias-floor dominated); live parked behaviour
    is the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
2026-07-20 Per-anchor range-bias memory in the EKF: kills anchor-dropout position jumps
    User-reported problem: when the scheduler skips an anchor, the fix is
    solved by a different anchor SUBSET whose residual biases average
    differently -> the position teleports and the filter follows.
    - FusionEkf: optional augmented state (enableRangeBias) with one
    slowly-varying range-bias per anchor (RW 3 mm/sqrt(s), init 50 mm),
    learned through tightly-coupled updates (z = ||p-a|| + b_k) and
    REMEMBERED while an anchor is skipped; reinitFrom preserves them.
    All updates generalized to the augmented state (Joseph form).
    - Dropout experiment (19 parked dwells, each anchor artificially removed
    mid-dwell): subs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
2026-07-20 live_tag: nlos toggle (soft gap weights optional)
    Parked-dwell test (19 dwells): weights OFF = scatter 26->24 mm, wander
    unchanged (~75 mm slow multipath breathing), median-vs-truth 48->39 mm.
    With the power correction in place the soft weights add little statically;
    the MAD gate still handles hard outliers. Default stays ON (body-blocking
    protection while moving); nlos=false to disable.
2026-07-20 RangeHold: last-known-range memory keeps full anchor geometry (user idea)
    When anchors miss sweeps, the fix was solved by a changing anchor subset
    -> position jumps. dune.RangeHold caches each anchor recent ranges
    (held value = median of last 5) and injects the held range into sweeps
    where that anchor is missing: full weight while the tag is STILL (the
    range is genuinely unchanged), fast decay + 3 s cap while moving.
    solveSweep gains sweep.wScale passthrough; live_tag applies the hold by
    default (hold=false to disable) and shows (n held) in the title.
    Dropout experiment (19 dwells, anchor removed mid-dwell), median jump:
    raw 13-28 mm -> raw+hold 6-10 mm; pos-EKF inherits the stable fixes;
    b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
2026-07-21 Adopt Bitcraze-style robust M-estimation updates in FusionEkf
    Marginal outliers are down-weighted (R inflated so effective NIS sits at
    the chi2 gate, bounded influence) instead of hard-rejected; only gross
    outliers beyond 10x gate are rejected. Default ON.
    Campaign A/B (full session incl. carrying):
    pos mode: 98 -> 97 mm (neutral statically; helps tails/moving)
    ranges+bias: 164 -> 105 mm <- fixes the tightly-coupled lock-in
    failure (hard gates let partial acceptance pin the filter at wrong
    positions; bounded influence prevents it). ranges mode (per-anchor
    bias memory, best dropout robustness) is now viable session-wide.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
2026-07-21 CIR capture instrument: firmware command + MATLAB waterfall tool
    Firmware (library + TagWrover, synced to the Arduino-path copy):
    - DW1000: readAccumulator() (forced ACC clocks, dummy-byte discard, per
    UM 7.2.27 / decadriver dwt_readaccdata) and getFirstPathIndex()
    (RX_TIME FP_INDEX, 10.6 fixed point). New ACC_MEM / FP_INDEX constants.
    - TwrEngine::captureCir(): one DS-TWR exchange, then CIR + first-path
    index of the final RANGE_REPORT read BEFORE re-arming RX. Deliberate
    duplicate of the proven rangeTo() flow (no refactor risk).
    - TagWrover: serial command CIR,<aid> -> CIRHDR / 32 CIRD hex lines
    (1016 taps @ PRF64) / CIREND. Diagnostics only; radio config untouched,
    so all calib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
    [TagWrover.ino]
2026-07-21 CIR capture fix: force transceiver idle before reading the accumulator
    First hardware run returned all-zero CIRs: with the auto-re-arm receive
    mode the receiver is already preamble-hunting when captureCir reads
    ACC_MEM, and an active receiver clears it. DW1000.idle() (TRXOFF) before
    the diagnostics + accumulator reads, startRx() after. Library re-synced
    to the Arduino-path copy.
2026-07-21 Rebuild plan: add expert-reviewed wobble root-cause investigation (Phases A-D)
    Reviewer verdict: estimator at its floor; residual lives in RF/timing
    physics. Prime suspect promoted: burst-vs-sweep cadence anomaly. Formula
    audit done (Neirynck product form confirmed). Phases: A offline forensics
    (cadence correlation, range-space decomposition, stillMode budget
    inversion), B CIR snapshots (reflash staged), C free observables
    (temp/Vbat/CFO/cadence telemetry), D isolation dwells (metronomic TDMA,
    raised anchors, channel alternation, continuous CIR). 7.3 resumes after.
2026-07-21 Phase A forensics done (cadence rejected, breathing is per-link) + Phase C RTLS v4 staged
    Phase A (docs/phase_a_findings.md, matlab/scripts/phase_a_forensics.m):
    - A1 cadence hypothesis REJECTED as breathing driver (gap-residual corr <= 0.06
    over 44k obs); real +/-5-7 mm receiver-idle micro-effect confirmed per anchor.
    - A2 breathing decomposition: per-anchor INDEPENDENT (cross-anchor corr +0.05,
    PC1 same-sign 26%) => link/anchor-side cause, tag-side common-mode excluded.
    - A3 stillMode noise-budget inversion: NEGATIVE (spot-specific residuals poison
    bias memory across dwells, 91->319 mm); FusionEkf.stillInvert kept default-off.
    - ekf_replay: truth-based spot clustering (spots.json med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
    [TagWrover.ino]
2026-07-21 Plan: goal 3->8 cm with stability focus; broadcast-POLL scope; TX-power experiment E
2026-07-21 Output pin (deadband) in live_tag + fix dead SAR/CFO reads (awaits reflash)
    - live_tag: opts.pin (default on, radius 5 cm) freezes the REPORTED position
    while parked; sustained excursion or motion releases. Output-stage only -
    estimator untouched (A3 showed in-filter absorption corrupts).
    - DW1000.getTempAndVbat: SAR was disabled before it ever converted (enable
    then disable back-to-back) -> raw 0 -> constant -132 C / 2.51 V. Now:
    reset, enable, 10 us wait, read, disable.
    - TwrEngine.rangeTo: idle the transceiver before the per-frame diagnostics -
    the auto-re-armed receiver re-tracks DRX_CARRIER_INT, so CFO read ~0
    (same mechanism as the all-zero CIR captures). captureCir pattern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
2026-07-21 live_tag pin: freeze the red dot too + residual/velocity fallback trigger
    - The red marker (dotH) was drawn at the RAW solve, so the pin froze only the
    trail/title/log, not the dot the user watches. Now dotH follows disp_ (the
    pinned/EKF value); grey ghost still shows raw.
    - Pin now engages on IMU stillness OR a calm solve (fit residual < pinResid
    0.06 m AND EKF speed < pinVel 0.08 m/s), so a parked tag pins even when the
    BNO085 stays jittery. Releases on noisy solve or real motion.
2026-07-21 Plan: pivot to motion tests, defer static experiments; add motion_check analyser
    - Plan: wobble investigation parked as good-enough for now; motion test is now
    step 1, reflash/raised-tag/A5/locked-room deferred until motion says ranges
    need work.
    - motion_check.m: segments a live_tag log into still/moving, reports per-move
    displacement (known-distance check), EKF-vs-raw lag, path jerk, pin coverage.
    No Kinect truth needed; smoke-tested on an existing parked log.
2026-07-21 live_tag: light output EMA to smooth the moving track (data-tuned)
    Motion log 202505 analysis: CV process-noise tuning is a poor smoothness
    lever (sigma 0.8->0.1 = only 13% less jerk, 3x the lag) because most of the
    jaggedness is the low-frequency breathing. An output-stage EMA on the moving
    track is far better: alpha 0.6 gives ~50% less jerk for ~25 mm lag. Added as
    opts.smooth (default 0.6, 1=off), applied like the pin - cosmetic, EKF state
    untouched, re-seeded to the pin point so release into motion has no jump.
    motion_check: omitnan in lag/jerk so unsolved sweeps during motion do not
    NaN the metrics.
2026-07-21 Experimental Moving Horizon Estimator (CasADi/IPOPT) + offline A/B harness
    dune.MheEstimator: sliding-window (N sweeps) NLP over the whole [p,v]
    trajectory; cost = robust pseudo-Huber per-anchor range fit + constant-
    velocity process model + arrival cost. Built once, IPOPT-solved each push.
    mhe_replay.m: offline A/B vs FusionEkf on any log (motion jerk/lag, static
    wander/RMSE, per-sweep solve time).
    Motion log 202505 (horizon 10): MHE jerk 0.369 vs EKF 0.613 (40% smoother)
    for +7 mm lag; MHE track stays contained where the EKF overshoots outliers.
    Solve time median 3.3 ms, p95 5.2 ms - live-feasible at 5 Hz. Static verdict
    pending. CasADi at C:\Users\itisa\Downloads\casadi-3.7.0 (caller add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
2026-07-21 MHE: add ZUPT (zero-velocity pseudo-meas when still) for parity with EKF
    The first static A/B was unfair - the EKF gets ZUPT while parked but the MHE
    did not, so on still dwells the MHE window drifted on the range breathing
    (S8 wander 241 mm vs EKF 47). Added a STILL parameter + zero-velocity term to
    the NLP; mhe_replay feeds the same stillness signal the EKF uses. Motion log
    202505: MHE jerk 0.344 vs EKF 0.613 (44% smoother) for +8 mm lag; solve
    median 2.9 ms. Static re-eval pending.
2026-07-21 MHE jump-guard + wire into live_tag as opt-in estimator
    Guard (dune.MheEstimator.maxJump): reject an output that leaps beyond the CV
    prediction, or a non-converged IPOPT solve, and fall back to the raw fix +
    reseed the window. Fixes the divergence cascade (first guard mistakenly fell
    back to unanchored CV extrapolation -> 9 m runaway). Motion log: 13/433 trips,
    jerk 0.359 vs EKF 0.613 (41% smoother). Note S8 static slow-drift is not sudden
    jumps, so the guard does not remove it (documented).
    live_tag: opts.estimator=mhe (default ekf), horizon, casadiPath. The EKF
    still runs for stillness + the pin velocity gate; MHE supplies the display fix,
    which then flows through the pin + EMA smoother l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
2026-07-21 MHE: gyro coordinated-turn model (delta IMU fusion) + IMU probe findings
    IMU probe (log 202505): accel bias ~0 (BNO085 gravity-removal clean; the old
    EKF divergence was a frame problem, not bias), tag flat (body gz = world yaw
    rate), but absolute orientation frame looks rotated (world-accel vs dv/dt corr
    -0.39). Per the delta idea, added a coordinated-turn model: the velocity vector
    rotates at the world-vertical gyro rate (delta-only, no absolute heading;
    omega=0 = exact CV). MheEstimator OMEGA param + trapezoidal position;
    mhe_replay/live_tag useImu (default true for MHE, worldYawRate helper).
    Offline on the hand-carried log it is a wash (jerk 0.357 CV vs 0.362 turn) -
    no sustained turns t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
2026-07-21 MHE: non-holonomic unicycle model for the RC car (gyro heading + no side-slip)
    MheEstimator.model=unicycle: state [px py theta speed]. Gyro yaw rate drives
    heading (change-in-yaw, no absolute compass - the UWB anchors the absolute
    heading), velocity is forced along the heading (no sideways slip), speed free.
    The physically-correct car-like model; needs no trusted orientation. CV path
    preserved as default. Wired: mhe_replay/live_tag model=unicycle.
    Offline on the HOLONOMIC hand log: smoother (jerk 0.331 vs cv 0.362) but
    laggier (39 vs 28 mm) - expected, the no-slip rule fights the hand's sideways
    motion. On a real front-steering car the lag penalty should vanish. Stable and
    fast (3.3 ms, max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
2026-07-21 Plan: park wobble + broadcast-POLL, proceed to 7.3 two-tags; handoff prompt
    - Wobble investigation (remaining) + broadcast-POLL marked PARKED (resumable).
    - 7.3 rewritten: two tags over WiFi/UDP (cannot USB both), yaw from the rigid
    baseline vs IMU yaw, and the fixed inter-tag distance as a rigid-body solver
    constraint (extends the MHE unicycle model). 7.4 Kinect accuracy stays later.
    - docs/handoff_two_tags.md: self-contained prompt for the new chat.
2026-07-21 7.3 transport: host-side UDP ingest (dune.TagUdp) + udp_probe
    Step 7.3 task 1 (dual-tag transport). The firmware already UDP-broadcasts
    every RTLS line to 255.255.255.255:4100; the host had no UDP receiver. Add:
    - dune.TagUdp: drop-in sibling of dune.TagSerial (start/drain/drainEvents/
    stop). One java.net.DatagramSocket (no Instrument Control Toolbox; udpport
    needs it and it isn't installed) ingests ALL tags at once; consumer demuxes
    by s.tag. Learns tag_id -> sender IP so sendCmd() can unicast a command
    back to a tag over UDP (firmware already listens on the broadcast port).
    Poll-on-drain model fits live_tag's per-loop drain().
    - udp_probe.m: task-1 verification tool (prints arri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
2026-07-21 7.3 tasks 2+3: live_dual_tag - dual UDP ingest, baseline yaw vs IMU yaw
    Both tags stream over WiFi/UDP into one dune.TagUdp socket; each sweep is
    demuxed by tag_id and solved independently (dune.solveSweep + optional per-tag
    FusionEkf). The map shows each tag as its own dot + trail and draws the rigid
    baseline between them. Readout reports each tag's (x,y), the measured inter-tag
    distance vs the known baseline L (a live way to re-measure L and a rigid-body
    sanity check), the baseline yaw = atan2(tag_hi - tag_lo), the BNO085 IMU yaw,
    and their offset + circular-mean (task 3: a stable offset quantifies the
    rotated IMU frame). Per-tag sweeps log to dual_log_*.jsonl (sweepRecord schema,
    replayab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
2026-07-21 7.3 checkpoint: dual-tag over UDP validated live (both tags)
    Record the milestone in the plan: tasks 1-3 done, both tags streaming over
    WiFi/UDP and displaying with the rigid baseline + baseline yaw. Measured
    inter-tag distance 0.317 m mean (std 29 mm) over an ~30 cm physical placement
    -> pipeline is accurate (no systematic bias); the 29 mm wander is the per-anchor
    breathing in the baseline, which the rigid constraint (task 4, next) will
    suppress. IMU on tag 240 silent (fixable) -> yaw-vs-IMU deferred. Still need a
    tape-measured antenna-centre distance as the hard constraint L.
2026-07-21 7.3 task 4: rigid-body joint solve (dune.rigidSolve) + rigid_replay
    Fit BOTH tags' ranges to one rigid pose [cx cy psi] with the inter-tag
    distance fixed at L (hard, baked into the parameterisation p_hi/p_lo =
    c +/- (L/2)[cos psi, sin psi]) - the soft-penalty variant is unnecessary since
    the hard form is simpler and exact. Reuses solveSweep for per-anchor power
    correction + NLOS/MAD weights + the independent init; LM over the 3 params.
    psi is the heading toward the higher-id tag (matches live_dual_tag baseline yaw).
    Validated offline on dual_log_20260721_222016 (parked, 82 nearest-time pairs,
    L=0.315): baseline std 36 mm -> exact; centre wander 26.9 -> 22.9 mm (-15%);
    yaw std 7.1 -> 5.6 deg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
2026-07-21 7.3 task 4: wire rigid pose into live_dual_tag (centre + heading)
    live_dual_tag now also runs dune.rigidSolve each time both tags are fresh
    (opts.rigid, default on): draws a purple centre marker + heading arrow, adds
    "RIG c(x,y) yaw" to the readout, and logs cx/cy/yawRig alongside the raw pair
    in dual_yaw. psi warm-starts from the previous sweep. Pass baseline=<tape L>;
    the readout's d+/-mm vs L flags a wrong L. Loop guard keeps it robust to the
    window closing mid-drain.
    Live smoke-tested with BOTH tags (baseline=0.315): 91 sweeps, 72 baseline
    records with rigid fields populated, no errors. Rigid centre sits between the
    two tags as expected.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
2026-07-21 7.3 end-of-day: record dual-tag degradation diagnosis + tomorrow's plan
    Dual-tag live run degraded: dots slid apart. Chain diagnosed: A1/A2 dropped
    mid-run (why = open: RF/power/connection) -> only top-edge A3/A4/A5 left,
    near-collinear -> multilaterate's degenerate-geometry gate correctly refuses
    (not a solver bug) -> with no fixes the per-tag EKF coasts and live_dual_tag's
    display follows it (my bug - live_tag guards the dot on a valid raw fix, the
    dual script dropped that). Rigid centre stayed correct throughout. Last fully
    reliable config: single-tag live_tag over COM + MHE unicycle.
2026-07-22 Plan: record true 7.3 state - transport done + in live_tag, dual-tag rolled back
    Reconciles the plan with reality after the working-tree rollback:
    - Task 1 transport DONE and now wired into single-tag live_tag over WiFi
    (00d7519). Corrects the stale "iitk blocks UDP" note - it never bit.
    - Tasks 2-4 (live_dual_tag, dune.rigidSolve) were built and validated, then
    deleted from the working tree; they remain in git history, restorable.
    - Records the dual-tag failure diagnosis: (1) A1/A2 died mid-run leaving the
    three near-collinear top-edge anchors, so the degenerate-geometry gate
    correctly refused fixes - now mitigated (batteries recharged, per-anchor
    freshness indicator); (2) a real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
2026-07-22 Rigid two-tag rover: MheRigid (dual-tag unicycle MHE) + live_rover over WiFi
    dune.MheRigid: ONE rigid body state [cx cy psi speed] observed by BOTH tags.
    Tag positions are derived from the pose (front = c + (Lh/2)[cos,sin]psi, rear =
    c - ...), so the rig's physics are enforced STRUCTURALLY, not as penalties:
    - inter-tag distance exact by construction
    - "both stationary or both moving" automatic (single speed state)
    - yaw observed by UWB geometry AND driven by the gyro yaw rate (delta only,
    no trusted absolute heading)
    Asynchronous by design: each sweep from EITHER tag is its own window node with
    sgn=+1/-1, so the two streams need no nearest-time pairing.
    Terrain: roll/pitch taken d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
2026-07-22 Port PS4 rover teleop + simultaneous UWB capture (moving-truth rig, 7.4)
    Ported from D:\MMS_Codebase\matlab\slip_analysis\
    test_random_excitation_slip_measurement.m. The MMS codebase is used READ-ONLY
    (addpath only, nothing there modified); all DUNE changes live in this file.
    Why: the rover already carries an AprilTag the Kinect tracks, so driving it with
    the two UWB tags aboard captures GROUND TRUTH and UWB sweeps on one clock - the
    dataset 7.5 needs to score EKF vs MHE vs the rigid two-tag MHE.
    Added to the original: dune.TagUdp ingest of BOTH tags in the same loop; a
    data.uwb block (per-sweep ranges/rx/fp aligned to anchor ids + the tag-240 IMU
    tail); POSIX timestamps on rover samples A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
2026-07-22 live_rover: output pin + circular EMA (port from live_tag); measured rig geometry
    Static wobble report: live_rover was showing the RAW MHE pose - the output pin
    and EMA that make live_tag's parked display stable were never ported. Added:
    - pin: while STILL and inside pinRadius (5 cm), freeze the displayed centre
    AND yaw; sustained excursion (~8 sweeps) re-pins. Title shows PIN.
    - smooth: light circular EMA on the moving pose (yaw averaged as a unit
    vector, not naively - avoids the +/-pi wrap artefact).
    Both are COSMETIC: the raw MHE pose is still what gets logged (plus a `pinned`
    flag), so offline analysis is unaffected. The underlying slow drift is the known
    per-anchor breathing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
2026-07-22 Fix rover_teleop_uwb control loop stall (PS4 presses were being missed)
    Symptom: "PS4 clicks not taken". Console showed n=22 in 15.2 s = ~1.4 Hz loop
    (target 20 Hz). The pad was actually read fine (V reached 0.010, seg advanced) -
    but at 1.4 Hz the loop polls every ~700 ms, so a normal press starts and ends
    between two polls and the rising-edge detector never sees it. The PS4 code is
    byte-identical to the working original; the stall was entirely mine.
    Causes, measured:
    1. data.uwb (~13 MB of preallocated arrays) lived INSIDE `data`, which
    logDataPointHW takes by value and modifies -> MATLAB copy-on-write
    duplicated the whole struct every iteration. Now a separate `uwb`
    vari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
2026-07-22 Add rover_run_report: UWB (rigid MHE) vs AprilTag truth analysis + diagnostics
    Solves per-sweep raw fixes and runs dune.MheRigid offline over a
    rover_teleop_uwb capture, de-rotates the AprilTag lever arm to get the implied
    rig centre, aligns on the shared POSIX clock, and fits the 2D rigid transform
    between the Kinect world and the UWB anchor world (Umeyama, no scale) since the
    two frames are not assumed equal. Reports RMSE/median/p95 and plots trajectory
    overlay plus the data-quality panels (anchors per sweep, per-tag sweep counts,
    truth availability, error vs time) that decide whether a run is usable.
    First run (20260722_140022): shape tracks well but the number is not yet
    trustworthy - A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
2026-07-22 Plan: BUILD PHASE DONE - move to testing & tuning (7.5 active)
    The chain exists end-to-end and has run on hardware: two tags -> WiFi/UDP ->
    rigid two-tag MHE -> live pose, plus a PS4-teleoperated rover capturing UWB and
    AprilTag truth on one clock, and an offline report scoring UWB vs truth. No
    major new components planned.
    - Status block rewritten to list what exists (calibration, EKF + MHE family,
    UDP transport, the four apps) and the one known residual (per-anchor
    breathing, masked at the output, not eliminated).
    - 7.4 marked DONE: moving truth comes from the ROVER (it already carries the
    AprilTag), not a separate recorder. Records the measured rig geometry
    (L=0.527, front 241 /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
2026-07-22 Add full LaTeX work report (docs/report/dune_report.tex, 13 pages)
    End-to-end record of the project, written explanation-first rather than
    math-first: ceiling-camera calibration and world registration, clicking the
    anchors into the world frame, two-way ranging and antenna-delay calibration,
    the signal-strength (first-path power) correction, least-squares
    multilateration, the Kalman filter and its five additions, the 19-position
    static campaign, the wobble investigation (timing rejected, per-link cause
    established, CIR confirming the buried first path), the output pin, the
    moving-horizon estimator, the rigid two-tag pose formulation and its synthetic
    validation, WiFi/UDP transport, and the fi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
2026-07-22 Add README and MIT license for public release
    README: what the system is, current accuracy (94 mm static per-reading,
    60-65 mm filtered), the known 5-7 cm parked drift stated plainly with its
    physical cause, hardware list, requirements (CasADi and Simulink 3D Animation
    are optional, per-feature), quick-start for live_tag / live_rover /
    rover_teleop_uwb / test_mhe_rigid, a brief how-it-works, and repo layout.
    Flags that paper/ predates the MATLAB rewrite and docs/report/ is authoritative.
    LICENSE: MIT for the project, with explicit carve-out for the vendored DW1000
    driver under libraries/UwbRtls/src/dw1000/, which is Apache 2.0
    (c) 2015 Thomas Trojer and stays that way including our modifica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
2026-07-22 Add rover_pose_report: full 6-DOF (x,y,z + roll,pitch,yaw) comparison
    Compares every observable pose channel against the AprilTag, from a single
    rover run: x/y (UWB rigid MHE after the fitted frame transform), z (AprilTag
    only - the UWB solve is 2D), and roll/pitch/yaw from the AprilTag, the rover's
    Teensy IMU and the tag-240 IMU. Constant offsets are removed by circular mean
    before comparison, since each source defines zero differently (marker print
    orientation, IMU mounting, anchor frame); the offsets are reported.
    UNITS: verified from the data rather than assumed - AprilTag euler is in
    RADIANS, the rover Teensy IMU reports DEGREES. Converted here.
    Finding: the AprilTag is good truth onl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
2026-07-22 Rewrite report as full documentation (25 pages, styled, figures, tutorials)
    Complete rewrite per feedback that v1 was an outline. Now a documentation-grade
    document: six parts (system, ground truth, radio, estimation, rover, hindsight)
    plus appendices (tool index, parameter reference, glossary, references).
    - Explanation-first prose with worked math: parallax height, DS-TWR product
    form, tick size, LM step, MAD gate, EKF predict/update, pseudo-Huber MHE
    cost, unicycle/rigid parameterisations, baseline-to-yaw noise, Umeyama fit.
    - Styled: colored parts/sections, four callout box types (In plain words /
    Try it yourself / Pitfall / Measured result), MATLAB listings, fancy headers.
    - Ever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
2026-07-22 Report: full NLOS section (physics, weight formula, three uses, honest ablation)
    New subsection 8.3 "Blocked paths: the NLOS machinery in detail":
    - the rx-fp gap as a blocked-path detector, with the courtyard-echo analogy and
    why NLOS ranges are biased LONG, not just noisy
    - the same-frame subtlety (tag overwrites the anchor-reported power so the gap
    compares powers of one frame)
    - the exact gapWeights formula: w = max(0.05, 10^(-(g-3)/10)), floor so a
    suspect anchor is de-emphasised but never silently dropped
    - the three places the weight acts: LS solve, per-range trust in EKF/MHE,
    adaptive R on the position fix
    - the ablation stated honestly: statically neutral-to-slightly-negativ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
2026-07-23 rover_teleop_uwb: decouple PS4 polling from the heavy sensor work
    User report: buttons need multiple presses to register. Root cause (diagnosed
    read-only earlier): the loop ran at ~3 Hz because EVERY iteration paid for a
    full Kinect frame + readAprilTag (~150-280 ms; 500-900 ms with the 3-retry
    storm on a missed detection) plus ~5 serial round-trips re-sending an
    unchanged velocity command. At 3 Hz a quick tap falls between polls.
    Restructure (all in our ported file; MMS classes untouched):
    - Velocity sent ON CHANGE + 1 s keepalive instead of every iteration. Motors
    latch their last command - the original already relied on that while idle.
    A D-pad change still transmits immediately; all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
2026-07-23 Auto-run the run report after a session; common axes on trajectory panels
    User edits:
    - rover_teleop_uwb: after the data is saved and the hardware released, call
    rover_run_report(filepath) automatically, in a try/catch that prints the
    manual command if it fails. Hardware is already disconnected at that point,
    so a report failure costs nothing.
    - rover_run_report: pin all three trajectory panels to the same x/y limits
    ([-3 3 -2 2]) so truth and UWB are directly comparable by eye, and clip the
    anchor labels to the axes.
2026-07-23 rover_run_report: validate the UWB-vs-truth alignment, plot it honestly
    Panel 3 drew the estimate resampled onto the ~1.2 Hz AprilTag timestamps
    while panel 1 drew all 6 Hz sweeps, so the same track looked like two
    different curves. Panel 3 now overlays the full-rate track (light red) on
    the truth-time samples (solid red); they coincide, which is the visual
    proof that the rigid transform is applied consistently.
    Checked the alignment three ways on rover_uwb_20260723_125849 before
    concluding the fit was not at fault:
    - lever-arm convention: all five sign/rotation variants land in
    251-286 mm, so no variant rescues the error
    - camera/UWB clock lag: sweeping +/-3 s, the best lag (+0.45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
2026-07-28 Report: add wired dual-tag mode, RF self-survey feature, MHE speed params
    Documents three of the recent additions (30 pages now):
    - Wired tag coordination as a SECOND mode alongside the wireless token ring
    (new 7.3): master/slave over a 921600-baud UART with versioned CRC framing,
    one radio active at a time, decided by cable not by a lossy radio token.
    Motivated by the first rover run's slot starvation (1124 vs 386 sweeps).
    Downstream (host format, solver, rigid MHE) is mode-agnostic.
    - Anchor RF self-survey as its own feature (new section 9) with results: the
    anchors range to each other, classical MDS reconstructs the constellation
    shape with no camera. Measured on survey_2026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
2026-07-29 Add RAP paper and wired dual-tag TDMA stack
    Adds a full RA-P paper workspace (LaTeX source, sections, figures, refs, and compiled artifacts) under `RAP Paper/`. Implements a new wired master/slave coordination path (`TagLink`) for dual-tag operation with cycle-based forwarding, diagnostics, adaptive slot budgeting, and explicit radio idle/active control in `TwrEngine`, plus host-line serialization updates to keep master/slave output format identical. Updates Tag/TagWrover sketches to support wire mode and serial transport, and extends MATLAB tooling with new survey/NLOS capture-report workflows, anchor rebuild/reconstruction scripts, EKF-vs-MHE comparison reporting, and MHE speed-bounding/fo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
